shousei01/dcdc_converter/README.txt

DCDC converter - LLC (isolated) + 4-switch buck-boost, STM32G474RBT3          Rev E2 (2026-10-20)
12-48 V in, 1.5-48 V / 5 A / 50 W out, basic isolation, isolated CAN

01_hardware
  kicad_project\   KiCad 6/7 project (10-sheet wired schematic + routed 4-layer PCB). Open in KiCad, or import
                   into EasyEDA Pro (File > Import > KiCad) - same files as easyeda\*.zip
  easyeda\         DCDC_LLC_4SBB_G474_EasyEDA_import.zip
  docs\            DCDC_Design_Notes.docx / .pdf (design notes: sizing, full scales, firmware notes, review),
                   schematic PDF, PCB layer PDF, DRC report, pin-map.xlsx (every MCU pin + all AFs + what we use),
                   T1_PQ2620_winding_guide.html (hand-winding guide, 2D/3D, dots), layout_review_layers.png
  fabrication\     JLCPCB Gerber/drill zip, CPL (pick & place), JLCPCB BOM;
                   DCDC_JLC_BOM.csv / DCDC_JLC_CPL.csv = assembly upload files (U1, T1, connectors, headers,
                   SW1 and the J6 SWD pads are hand-soldered / not placed and left out)
  bom\             grouped BOM with prices / sources
02_firmware        firmware workspace + README (pin map, clocks, ADC full scales, VIN monitor, OVP, start-up)
03_calculations    loss / LLC sizing scripts; aux_fuse_check.py (Rev D); flyback_aux.py (Rev E isolated aux
                   flyback: rail budget, DCM operating points, stresses, ripple, feedback); copper_check.py
                   (Rev E copper widths / losses of the high-current paths on the finished board)
04_scripts         generator, routing and clean-up scripts that build this release (Rev E layout: 04_scripts\pcb5)

Rev E2 changes (20 Oct)
  - Debug-port series resistors: R123-R128 47.5 Ohm 0402 (UNI-ROYAL 0402WGF475JTCE, C82290) in SWDIO, SWCLK,
    TP_DAC, TP_GPIO1, TP_GPIO2, NRST; R129 2 Ohm 0603 (FOJAN FRC0603F2R00TS, C2933191) from +3V3 to J6 pin 7 /
    J7 VTref (net PROG_3V3). Each sits on the MCU side of the J6 / J7 branch, put into the existing traces.
  - DRC clean-up: the 16 courtyard overlaps Rev E accepted (T1 / CR1-CR6 / R64, T2 / D8 / C94 / R116 / C95 /
    Q11 / R114, C98 / R122, C69 / U11, C34 / U1) are cleared by 0.05-2 mm moves with the tracks re-attached;
    the 4 silk-over-pad notices are gone too. DRC: 0 errors, 0 warnings, 0 unconnected (docs\DRC_report.txt).
  - Board-edit scripts: 04_scripts\pcb6 (build_e2.sh lists the order).

Rev E changes
  - Isolated aux supply: the isolator's built-in 3.3 V is gone. New flyback (sheet "Isolated aux flyback"):
    UC3843B U20 from +10V_P, FDN86246 Q11, PA3855.006NLT EP13 transformer T2 (Np:Ns 1.33:1, 2250 Vdc hi-pot),
    SS110 D9 -> isolated +10 V. Secondary regulation: TL431 U22 (+10 V = 9.98 V) driving an EL357N opto U21
    into the UC3843 COMP pin; RCD clamp D8/R116/C94; 2 A primary current limit (R114 0.5 Ohm).
  - Secondary rails now come from the flyback, not VBUS: +10 V (drivers) -> U4 LMR16006 10 V -> 5 V ->
    U5 TLV75533 -> +3V3 (MCU, CAN, isolator side B) -> FB1 -> +3V3A. The MCU, CAN and drivers are up as soon
    as VIN is present, before the LLC starts.
  - U12 is now a CA-IS3742LW (4-channel isolator, no power). U12 ENA = +5V_P, ENB = +3V3.
  - VREF+ back to +3V3A (3.3 V); REF3030 U19 removed. Full scales: VBUS / VOUT 68.0 V, IL +/-20.6 A
    (zero 1.65 V), IOUT 6.6 A, DAC3 / COMP 0-3.3 V (see design notes and 02_firmware README).
  - PCB re-placed and re-routed for 1 oz outer / 0.5 oz inner copper: power on F.Cu pours (one net each),
    In1 solid ground planes (GNDP / GND / GND_ISO) with 4 mm isolation bands, VBUS link / VOUT strip / PGND bar
    copy on B.Cu, signals on In2 / B.Cu under ground floods. Gate loops as tight HO + HS pairs (0.4 mm) on
    B.Cu / In2; power via fields at 1.7 mm pitch so In1 keeps a ground web; own GND via on every small R/C in the
    MCU area. Board copper loss ~0.5 W at 50 W / 12 V in (03_calculations\copper_check.txt).
PCB status: 160 x 105 mm, 4 layers, 291 footprints, 779 vias; 0 DRC errors / 0 warnings / 0 unconnected with the
JLC rules loaded (docs\DRC_report.txt); no copper in the primary-secondary or CAN bands.
Order: 4 layers, 1.6 mm, 1 oz outer / 0.5 oz inner copper, JLC04161H-7628 stack-up;
upload fabrication\*_gerbers_JLCPCB.zip, DCDC_JLC_BOM.csv and DCDC_JLC_CPL.csv.
New parts to check in the JLC placement viewer: U20 (SOIC-8), U21 (SOP-4), U22 (SOT-23), Q11 (SOT-23),
T2 (EP13 SMD), U12 (SOIC-16W), U5 (SOT-23-5).

Rev D changes (history)
  - NTC moved PA4 -> PA6 (ADC2_IN3); PA4 kept free for DAC1_OUT1
  - 10k pull-down to GND on every unused MCU pin (R90-R105; R93 is now the PA2 / VIN_PWM pull-down)
  - HSE crystal 16 MHz (Y1 + 12 pF C0G)
  - (superseded in Rev E) ADC / DAC / comparator reference: external REF3030 (U19, 3.000 V +/-0.2 %) on VREF+, no longer the
    isolator's 3.3 V rail. Full scales: VBUS / VOUT 61.8 V, IL +/-18.75 A, IOUT 6.0 A (see design notes)
  - Primary input OVP: TL431 + LMV331, trips 50.26 V rising / 49.83 V falling, through U12 isolator
    channel 1 -> PA15 (HRTIM1_FLT2)
  - Isolated VIN monitor: primary ramp (~200 Hz) + comparator PWM through U12 channel 2 -> PA2 (TIM15_CH1);
    divider R81/R82 0.1 %. Monitoring only, about +/-0.5 % after a two-point calibration
  - Test pads TP1-TP15 on rails / filtered signals only (no switch nodes)
  - T1 footprint fits the vendor PQ2620 and PQ2625 6+6 bobbins: 3.8 mm pitch inside each 3-pin group,
    7.5 mm between pins 3 and 4, 25.4 mm row-to-row, 1.2 mm holes
  - JP1 is a 2x2 header that switches both legs of the CAN split termination
  - Silkscreen: VIN+/-, VOUT+/-, CAN_H / CAN_L / CAN_GND, JP1 shunt boxes, J7 notch + pin 1, DIP A0-A5 / ON=1
  - F1 now a 1206 7 A 63 V chip fuse (Littelfuse 0458007.DR; 2nd source Schurter 3413.0326.11);
    L2 / L3 now 5040 shielded 47 uH (Sunlord SWPA5040S470MT; 2nd source Bourns SRN5040-470M,
    Taiyo Yuden NRS5040T470MMGK). EN_AUX re-routed, VIN track centred between the L3 pads.
    Every part carries a JLCPCB-checked LCSC number (design.py JLC_LCSC) in the BOMs, schematic and PCB
  - Layout review (18 Oct): smaller switch-node pours, tighter gate loops, Kelvin taps, output pour,
    straightened routing, 5 mm ground stitching
  - JLCPCB compliance (4-layer, 2 oz outer): PTH pad-to-track >= 0.28 mm, inner hole-to-copper >= 0.3 mm,
    silkscreen text >= 1.0 mm / 0.15 mm stroke; limits kept as custom DRC rules in kicad_project\*.kicad_dru
Rev D PCB status: 160 x 105 mm, 4 layers, 257 footprints, 0 DRC errors / warnings with the JLC rules loaded,
0 unconnected, primary-secondary copper gap 4.0 mm on every layer.
Rev D order: 4 layers, 1.6 mm, 2 oz outer copper, JLC04161H-7628 stack-up; upload fabrication\*_gerbers_JLCPCB.zip.
