shousei01/dcdc_converter/01_hardware/docs/pin-map.xlsx

Sheet: Pin map
Pin # | Pin name | Pin type | Net (schematic) | Status | Function used | Mode / AF | Direction | Connected to | Design notes | Additional functions (analog, wake-up, ...) | AF0 | AF1 | AF2 | AF3 | AF4 | AF5 | AF6 | AF7 | AF8 | AF9 | AF10 | AF11 | AF12 | AF13 | AF14 | AF15
1 | VBAT | Power | +3V3 | Power | VBAT (backup domain) | Power | Supply |  | Tied to +3V3 (no backup battery; RTC/backup registers lost at power-off)
2 | PC13 | I/O | SP_PC13 | Unused | Not used | Analog (reset state) or input | - | R90.1 | 10k pull-down to GND (R90); low-drive backup-domain pin | RTC_OUT1, RTC_TAMP1, RTC_TS, SYS_WKUP2 |  |  | TIM1_BKIN |  | TIM1_CH1N |  | TIM8_CH4N |  |  |  |  |  |  |  |  | EVENTOUT
3 | PC14-OSC32_IN | I/O | SP_PC14 | Unused | Not used | Analog (reset state) or input | - | R91.1 | 10k pull-down to GND (R91); low-drive backup-domain pin | RCC_OSC32_IN |  |  |  |  |  |  |  |  |  |  |  |  |  |  |  | EVENTOUT
4 | PC15-OSC32_OUT | I/O | SP_PC15 | Unused | Not used | Analog (reset state) or input | - | R92.1 | 10k pull-down to GND (R92); low-drive backup-domain pin | ADC1_EXTI15, ADC2_EXTI15, RCC_OSC32_OUT |  |  |  |  |  |  |  |  |  |  |  |  |  |  |  | EVENTOUT
5 | PF0-OSC_IN | I/O | OSC_IN | Used | RCC_OSC_IN (HSE) | RCC HSE crystal | In | C38.1, Y1.1 | Y1 16 MHz 9 pF + 12 pF C0G load caps -> PLL 170 MHz | ADC1_IN10, RCC_OSC_IN |  |  |  |  | I2C2_SDA | I2S2_WS / SPI2_NSS | TIM1_CH3N |  |  |  |  |  |  |  |  | EVENTOUT
6 | PF1-OSC_OUT | I/O | OSC_OUT | Used | RCC_OSC_OUT (HSE) | RCC HSE crystal | Out | C39.1, Y1.3 | Y1 16 MHz | ADC2_IN10, COMP3_INM, RCC_OSC_OUT |  |  |  |  |  | I2S2_CK / SPI2_SCK |  |  |  |  |  |  |  |  |  | EVENTOUT
7 | PG10-NRST | I/O | NRST | Used | NRST | Reset | In/Out | C40.1, J6.6, J7.10 | 100 nF to GND (C40); SWD reset on J6.6 / J7.10 | DAC1_EXTI10, DAC2_EXTI10, DAC3_EXTI10, DAC4_EXTI10 | RCC_MCO |  |  |  |  |  |  |  |  |  |  |  |  |  |  | EVENTOUT
8 | PC0 | I/O | ADDR0 | Used | GPIO input | Input, no pull (10k external pull-up) | In | R32.1, R38.2, SW1.1 | Address bit 0: DIP SW1 / header J5 (ON or jumper = 0) | ADC1_IN6, ADC2_IN6, COMP3_INM |  | LPTIM1_IN1 | TIM1_CH1 |  |  |  |  |  | LPUART1_RX |  |  |  |  |  |  | EVENTOUT
9 | PC1 | I/O | ADDR1 | Used | GPIO input | Input, no pull (10k external pull-up) | In | R33.1, R39.2, SW1.2 | Address bit 1: DIP SW1 / header J5 (ON or jumper = 0) | ADC1_IN7, ADC2_IN7, COMP3_INP |  | LPTIM1_OUT | TIM1_CH2 |  |  |  |  |  | LPUART1_TX |  | QUADSPI1_BK2_IO0 |  |  | SAI1_SD_A |  | EVENTOUT
10 | PC2 | I/O | ADDR2 | Used | GPIO input | Input, no pull (10k external pull-up) | In | R34.1, R40.2, SW1.3 | Address bit 2: DIP SW1 / header J5 (ON or jumper = 0) | ADC1_IN8, ADC2_IN8, ADC3_EXTI2, ADC4_EXTI2, ADC5_EXTI2 |  | LPTIM1_IN2 | TIM1_CH3 | COMP3_OUT |  |  | TIM20_CH2 |  |  |  | QUADSPI1_BK2_IO1 |  |  |  |  | EVENTOUT
11 | PC3 | I/O | ADDR3 | Used | GPIO input | Input, no pull (10k external pull-up) | In | R35.1, R41.2, SW1.4 | Address bit 3: DIP SW1 / header J5 (ON or jumper = 0) | ADC1_IN9, ADC2_IN9, ADC3_EXTI3, ADC4_EXTI3, ADC5_EXTI3, OPAMP5_VINP, OPAMP5_VINP_SEC | SYS_SLEEP | LPTIM1_ETR | TIM1_CH4 | SAI1_D1 |  |  | TIM1_BKIN2 |  |  |  | QUADSPI1_BK2_IO2 |  |  | SAI1_SD_A |  | EVENTOUT
12 | PA0 | I/O | VBUS_SNS | Used | ADC1_IN1 | Analog | In | C41.1, R21.2, R22.1 | VBUS divider 100k/5.1k, 1 nF -> 68 V full scale | ADC1_IN1, ADC2_IN1, COMP1_INM, COMP3_INP, RTC_TAMP2, SYS_WKUP1 |  | TIM2_CH1 | TIM5_CH1 |  |  |  |  | USART2_CTS / USART2_NSS | COMP1_OUT | TIM8_BKIN | TIM8_ETR |  |  |  | TIM2_ETR | EVENTOUT
13 | PA1 | I/O | IOUT_SNS | Used | ADC1_IN2 | Analog | In | C47.1, R28.2, TP14.1 | INA181A2 on 10 mOhm (RSH1): 0.5 V/A, 1k + 10 nF filter | ADC1_IN2, ADC2_IN2, COMP1_INP, OPAMP1_VINP, OPAMP1_VINP_SEC, OPAMP3_VINP, OPAMP3_VINP_SEC, OPAMP6_VINM, OPAMP6_VINM0, OPAMP6_VINM_SEC | RTC_REFIN | TIM2_CH2 | TIM5_CH2 |  |  |  |  | USART2_DE / USART2_RTS |  | TIM15_CH1N |  |  |  |  |  | EVENTOUT
14 | PA2 | I/O | SP_PA2 | Unused | Not used | Analog (reset state) or input | - | R93.1 | 10k pull-down to GND (R93) | ADC1_IN3, ADC3_EXTI2, ADC4_EXTI2, ADC5_EXTI2, COMP2_INM, OPAMP1_VOUT, RCC_LSCO, SYS_WKUP4 |  | TIM2_CH3 | TIM5_CH3 |  |  |  |  | USART2_TX | COMP2_OUT | TIM15_CH1 | QUADSPI1_BK1_NCS |  | LPUART1_TX |  | UCPD1_FRSTX1 / UCPD1_FRSTX2 | EVENTOUT
15 | VSS | Power | GND | Power | Ground | Power | Supply |  | Secondary GND plane (In1)
16 | VDD | Power | +3V3 | Power | VDD supply | Power | Supply |  | 100 nF per VDD pin (C30-C34) + 4.7 uF bulk (C35)
17 | PA3 | I/O | SP_PA3 | Unused | Not used | Analog (reset state) or input | - | R94.1 | 10k pull-down to GND (R94) | ADC1_IN4, ADC3_EXTI3, ADC4_EXTI3, ADC5_EXTI3, COMP2_INP, OPAMP1_VINM, OPAMP1_VINM0, OPAMP1_VINM_SEC, OPAMP1_VINP, OPAMP1_VINP_SEC, OPAMP5_VINM, OPAMP5_VINM1, OPAMP5_VINM_SEC |  | TIM2_CH4 | TIM5_CH4 | SAI1_CK1 |  |  |  | USART2_RX |  | TIM15_CH2 | QUADSPI1_CLK |  | LPUART1_RX | SAI1_MCLK_A |  | EVENTOUT
18 | PA4 | I/O | SP_PA4 | Reserved | Reserved: DAC1_OUT1 | Analog (reset state) or input | - | R95.1 | Kept free for DAC1_OUT1 (Rev D request); 10k pull-down R95 is a valid DAC load (min 5k) | ADC2_IN17, COMP1_INM, DAC1_OUT1 |  |  | TIM3_CH2 |  |  | SPI1_NSS | I2S3_WS / SPI3_NSS | USART2_CK |  |  |  |  |  | SAI1_FS_B |  | EVENTOUT
19 | PA5 | I/O | TP_DAC | Used | DAC1_OUT2 | Analog | Out | J6.3 | Test_pin_DAC on PROG PADS J6.3 (debug waveform out) | ADC2_IN13, COMP2_INM, DAC1_OUT2, OPAMP2_VINM, OPAMP2_VINM0, OPAMP2_VINM_SEC |  | TIM2_CH1 | TIM2_ETR |  |  | SPI1_SCK |  |  |  |  |  |  |  |  | UCPD1_FRSTX1 / UCPD1_FRSTX2 | EVENTOUT
20 | PA6 | I/O | NTC_SNS | Used | ADC2_IN3 | Analog | In | C48.1, R29.2, TH1.1 | NTC 10k B3950 / 10k divider (Rev D: moved from PA4 to PA6) | ADC2_IN3, DAC2_OUT1, OPAMP2_VOUT |  | TIM16_CH1 | TIM3_CH1 |  | TIM8_BKIN | SPI1_MISO | TIM1_BKIN |  | COMP1_OUT |  | QUADSPI1_BK1_IO3 |  | LPUART1_CTS |  |  | EVENTOUT
21 | PA7 | I/O | SP_PA7 | Unused | Not used | Analog (reset state) or input | - | R96.1 | 10k pull-down to GND (R96) | ADC2_IN4, COMP2_INP, OPAMP1_VINP, OPAMP1_VINP_SEC, OPAMP2_VINP, OPAMP2_VINP_SEC |  | TIM17_CH1 | TIM3_CH2 |  | TIM8_CH1N | SPI1_MOSI | TIM1_CH1N |  | COMP2_OUT |  | QUADSPI1_BK1_IO2 |  |  |  | UCPD1_FRSTX1 / UCPD1_FRSTX2 | EVENTOUT
22 | PC4 | I/O | ADDR4 | Used | GPIO input | Input, no pull (10k external pull-up) | In | R36.1, R42.2, SW1.5 | Address bit 4: DIP SW1 / header J5 (ON or jumper = 0) | ADC2_IN5 |  |  | TIM1_ETR |  | I2C2_SCL |  |  | USART1_TX |  |  | QUADSPI1_BK2_IO3 |  |  |  |  | EVENTOUT
23 | PC5 | I/O | ADDR5 | Used | GPIO input | Input, no pull (10k external pull-up) | In | R37.1, R43.2, SW1.6 | Address bit 5: DIP SW1 / header J5 (ON or jumper = 0) | ADC2_IN11, OPAMP1_VINM, OPAMP1_VINM1, OPAMP1_VINM_SEC, OPAMP2_VINM, OPAMP2_VINM1, OPAMP2_VINM_SEC, SYS_WKUP5 |  |  | TIM15_BKIN | SAI1_D3 |  |  | TIM1_CH4N | USART1_RX |  |  |  |  |  | HRTIM1_EEV10 |  | EVENTOUT
24 | PB0 | I/O | IL_SNS | Used | COMP4_INP | Analog | In | C45.1, R27.2, TP13.1 | Inductor current (INA181A1 on 4 mOhm, 1.65 V + 0.08 V/A): buck-mode negative OCP, COMP4 output inverted -> HRTIM fault | ADC1_IN15, ADC3_IN12, COMP4_INP, OPAMP2_VINP, OPAMP2_VINP_SEC, OPAMP3_VINP, OPAMP3_VINP_SEC |  |  | TIM3_CH3 |  | TIM8_CH2N |  | TIM1_CH2N |  |  |  | QUADSPI1_BK1_IO1 |  |  | HRTIM1_FLT5 | UCPD1_FRSTX1 / UCPD1_FRSTX2 | EVENTOUT
25 | PB1 | I/O | IL_SNS | Used | ADC1_IN12 + COMP1_INP | Analog | In | C45.1, R27.2, TP13.1 | Inductor current sample for CC loop; COMP1 = positive OCP -> HRTIM fault (thresholds from DAC3) | ADC1_IN12, ADC3_IN1, COMP1_INP, OPAMP3_VOUT, OPAMP6_VINM, OPAMP6_VINM1, OPAMP6_VINM_SEC |  |  | TIM3_CH4 |  | TIM8_CH3N |  | TIM1_CH3N |  | COMP4_OUT |  | QUADSPI1_BK1_IO0 |  | LPUART1_DE / LPUART1_RTS | HRTIM1_SCOUT |  | EVENTOUT
26 | PB2 | I/O | SP_PB2 | Unused | Not used | Analog (reset state) or input | - | R97.1 | 10k pull-down to GND (R97) | ADC2_IN12, ADC3_EXTI2, ADC4_EXTI2, ADC5_EXTI2, COMP4_INM, OPAMP3_VINM, OPAMP3_VINM0, OPAMP3_VINM_SEC | RTC_OUT2 | LPTIM1_OUT | TIM5_CH1 | TIM20_CH1 | I2C3_SMBA |  |  |  |  |  | QUADSPI1_BK2_IO1 |  |  | HRTIM1_SCIN |  | EVENTOUT
27 | VSSA | Power | GND | Power | Ground | Power | Supply |  | Secondary GND plane (In1)
28 | VREF+ | MonoIO | +3V3A | Power | VREF+ input | Power | Supply |  | Tied to +3V3A (VREFBUF disabled); ADC/DAC full scale = 3.3 V | VREFBUF_OUT
29 | VDDA | Power | +3V3A | Power | Analog supply / reference | Power | Supply |  | VDDA and VREF+ from +3V3 via FB1; VREFBUF off, VREF+ used as input (1 uF + 100 nF)
30 | PB10 | I/O | SP_PB10 | Unused | Not used | Analog (reset state) or input | - | R98.1 | 10k pull-down to GND (R98) | COMP5_INM, DAC1_EXTI10, DAC2_EXTI10, DAC3_EXTI10, DAC4_EXTI10, OPAMP3_VINM, OPAMP3_VINM1, OPAMP3_VINM_SEC, OPAMP4_VINM, OPAMP4_VINM0, OPAMP4_VINM_SEC |  | TIM2_CH3 |  |  |  |  |  | USART3_TX | LPUART1_RX |  | QUADSPI1_CLK |  | TIM1_BKIN | HRTIM1_FLT3 | SAI1_SCK_A | EVENTOUT
31 | VSS | Power | GND | Power | Ground | Power | Supply |  | Secondary GND plane (In1)
32 | VDD | Power | +3V3 | Power | VDD supply | Power | Supply |  | 100 nF per VDD pin (C30-C34) + 4.7 uF bulk (C35)
33 | PB11 | I/O | VOUT_SNS | Used | ADC1_IN14 + COMP6_INP | Analog | In | C42.1, R23.2, R24.1 | VOUT divider 100k/5.1k; COMP6 = fast hardware OVP (threshold from DAC3) | ADC1_EXTI11, ADC1_IN14, ADC2_EXTI11, ADC2_IN14, COMP6_INP, OPAMP4_VINP, OPAMP4_VINP_SEC, OPAMP6_VOUT |  | TIM2_CH4 |  |  |  |  |  | USART3_RX | LPUART1_TX |  | QUADSPI1_BK1_NCS |  |  | HRTIM1_FLT4 |  | EVENTOUT
34 | PB12 | I/O | LLC_A | Used | HRTIM1_CHC1 | AF13 | Out | R79.1, U12.12 | LLC half-bridge high side via CA-IS3742 (U12) -> UCC27211 (U10) | ADC1_IN11, ADC4_IN3, COMP7_INM, OPAMP4_VOUT, OPAMP6_VINP, OPAMP6_VINP_SEC |  |  | TIM5_ETR |  | I2C2_SMBA | I2S2_WS / SPI2_NSS | TIM1_BKIN | USART3_CK | LPUART1_DE / LPUART1_RTS | FDCAN2_RX |  |  |  | HRTIM1_CHC1 |  | EVENTOUT
35 | PB13 | I/O | LLC_B | Used | HRTIM1_CHC2 | AF13 | Out | R80.1, U12.11 | LLC half-bridge low side via U12 -> U10 | ADC3_IN5, COMP5_INP, OPAMP3_VINP, OPAMP3_VINP_SEC, OPAMP4_VINP, OPAMP4_VINP_SEC, OPAMP6_VINP, OPAMP6_VINP_SEC |  |  |  |  |  | I2S2_CK / SPI2_SCK | TIM1_CH1N | USART3_CTS / USART3_NSS | LPUART1_CTS | FDCAN2_TX |  |  |  | HRTIM1_CHC2 |  | EVENTOUT
36 | PB14 | I/O | SR1_PWM | Used | HRTIM1_CHD1 | AF13 | Out | R73.1, U11.2 | Synchronous rectifier Q7 via UCC27524 (U11) | ADC1_IN5, ADC4_IN4, COMP7_INP, OPAMP2_VINP, OPAMP2_VINP_SEC, OPAMP5_VINP, OPAMP5_VINP_SEC |  | TIM15_CH1 |  |  |  | SPI2_MISO | TIM1_CH2N | USART3_DE / USART3_RTS | COMP4_OUT |  |  |  |  | HRTIM1_CHD1 |  | EVENTOUT
37 | PB15 | I/O | SR2_PWM | Used | HRTIM1_CHD2 | AF13 | Out | R74.1, U11.4 | Synchronous rectifier Q8 via U11 | ADC1_EXTI15, ADC2_EXTI15, ADC2_IN15, ADC4_IN5, COMP6_INM, OPAMP5_VINM, OPAMP5_VINM0, OPAMP5_VINM_SEC | RTC_REFIN | TIM15_CH2 | TIM15_CH1N | COMP3_OUT | TIM1_CH3N | I2S2_SD / SPI2_MOSI |  |  |  |  |  |  |  | HRTIM1_CHD2 |  | EVENTOUT
38 | PC6 | I/O | SP_PC6 | Unused | Not used | Analog (reset state) or input | - | R99.1 | 10k pull-down to GND (R99) |  |  |  | TIM3_CH1 | HRTIM1_EEV10 | TIM8_CH1 |  | I2S2_MCK | COMP6_OUT | I2C4_SCL |  |  |  |  | HRTIM1_CHF1 |  | EVENTOUT
39 | PC7 | I/O | SP_PC7 | Unused | Not used | Analog (reset state) or input | - | R100.1 | 10k pull-down to GND (R100) |  |  |  | TIM3_CH2 | HRTIM1_FLT5 | TIM8_CH2 |  | I2S3_MCK | COMP5_OUT | I2C4_SDA |  |  |  |  | HRTIM1_CHF2 |  | EVENTOUT
40 | PC8 | I/O | PWM_E1 | Used | HRTIM1_CHE1 | AF3 | Out | R14.1, U3.5 | 4SBB output leg high side Q3 via UCC27211 (U3) |  |  |  | TIM3_CH3 | HRTIM1_CHE1 | TIM8_CH3 |  | TIM20_CH3 | COMP7_OUT | I2C3_SCL |  |  |  |  |  |  | EVENTOUT
41 | PC9 | I/O | PWM_E2 | Used | HRTIM1_CHE2 | AF3 | Out | R15.1, U3.6 | 4SBB output leg low side Q4 via U3 | DAC1_EXTI9, DAC2_EXTI9, DAC3_EXTI9, DAC4_EXTI9 |  |  | TIM3_CH4 | HRTIM1_CHE2 | TIM8_CH4 | I2S_CKIN | TIM8_BKIN2 |  | I2C3_SDA |  |  |  |  |  |  | EVENTOUT
42 | PA8 | I/O | PWM_A1 | Used | HRTIM1_CHA1 | AF13 | Out | R8.1, U2.5 | 4SBB input leg high side Q1 via UCC27211 (U2) | ADC5_IN1, OPAMP5_VOUT | RCC_MCO |  | I2C3_SCL |  | I2C2_SDA | I2S2_MCK | TIM1_CH1 | USART1_CK | COMP7_OUT |  | TIM4_ETR | FDCAN3_RX | SAI1_CK2 | HRTIM1_CHA1 | SAI1_SCK_A | EVENTOUT
43 | PA9 | I/O | PWM_A2 | Used | HRTIM1_CHA2 | AF13 | Out | R9.1, U2.6 | 4SBB input leg low side Q2 via U2 | ADC5_IN2, DAC1_EXTI9, DAC2_EXTI9, DAC3_EXTI9, DAC4_EXTI9, UCPD1_DBCC1 |  |  | I2C3_SMBA |  | I2C2_SCL | I2S3_MCK | TIM1_CH2 | USART1_TX | COMP5_OUT | TIM15_BKIN | TIM2_CH3 |  |  | HRTIM1_CHA2 | SAI1_FS_A | EVENTOUT
44 | PA10 | I/O | SP_PA10 | Unused | Not used | Analog (reset state) or input | - | R101.1 | 10k pull-down to GND (R101) | DAC1_EXTI10, DAC2_EXTI10, DAC3_EXTI10, DAC4_EXTI10, UCPD1_DBCC2 |  | TIM17_BKIN |  | CRS_SYNC | I2C2_SMBA | SPI2_MISO | TIM1_CH3 | USART1_RX | COMP6_OUT |  | TIM2_CH4 | TIM8_BKIN | SAI1_D1 | HRTIM1_CHB1 | SAI1_SD_A | EVENTOUT
45 | PA11 | I/O | CAN_RXD | Used | FDCAN1_RX | AF9 | In | U9.5 | CA-IS3062VW (U9) RXD | ADC1_EXTI11, ADC2_EXTI11, USB_DM |  |  |  |  |  | I2S2_SD / SPI2_MOSI | TIM1_CH1N | USART1_CTS / USART1_NSS | COMP1_OUT | FDCAN1_RX | TIM4_CH1 | TIM1_CH4 | TIM1_BKIN2 | HRTIM1_CHB2 |  | EVENTOUT
46 | PA12 | I/O | CAN_TXD | Used | FDCAN1_TX | AF9 | Out | U9.3 | CA-IS3062VW (U9) TXD | USB_DP |  | TIM16_CH1 |  |  |  | I2S_CKIN | TIM1_CH2N | USART1_DE / USART1_RTS | COMP2_OUT | FDCAN1_TX | TIM4_CH2 | TIM1_ETR |  | HRTIM1_FLT1 |  | EVENTOUT
47 | VSS | Power | GND | Power | Ground | Power | Supply |  | Secondary GND plane (In1)
48 | VDD | Power | +3V3 | Power | VDD supply | Power | Supply |  | 100 nF per VDD pin (C30-C34) + 4.7 uF bulk (C35)
49 | PA13 | I/O | SWDIO | Used | SYS_JTMS-SWDIO | AF0 (reset default) | In/Out | J6.1, J7.2 | J6.1 / J7.2 |  | SYS_JTMS-SWDIO | TIM16_CH1N |  | I2C4_SCL | I2C1_SCL | IR_OUT |  | USART3_CTS / USART3_NSS |  |  | TIM4_CH3 |  |  | SAI1_SD_B |  | EVENTOUT
50 | PA14 | I/O | SWCLK | Used | SYS_JTCK-SWCLK | AF0 (reset default) | In | J6.2, J7.4 | J6.2 / J7.4 |  | SYS_JTCK-SWCLK | LPTIM1_OUT |  | I2C4_SMBA | I2C1_SDA | TIM8_CH2 | TIM1_BKIN | USART2_TX |  |  |  |  |  | SAI1_FS_B |  | EVENTOUT
51 | PA15 | I/O | VIN_OVP | Used | HRTIM1_FLT2 (alt.: GPIO EXTI15) | AF13 | In | TP15.1, U12.14 | Rev D: primary input OVP, LMV331 + TL431 trip 50.2 V, through U12 VI1->VO1; high = over-voltage. Configure FLT2 active-high so the HRTIM shuts all outputs in hardware | ADC1_EXTI15, ADC2_EXTI15 | SYS_JTDI | TIM2_CH1 | TIM8_CH1 |  | I2C1_SCL | SPI1_NSS | I2S3_WS / SPI3_NSS | USART2_RX | UART4_DE / UART4_RTS | TIM1_BKIN |  | FDCAN3_TX |  | HRTIM1_FLT2 | TIM2_ETR | EVENTOUT
52 | PC10 | I/O | LED_FLT | Used | GPIO output | Output push-pull | Out | R45.2 | Red FAULT LED D5 via 1k, active low | DAC1_EXTI10, DAC2_EXTI10, DAC3_EXTI10, DAC4_EXTI10 |  |  |  |  | TIM8_CH1N | UART4_TX | I2S3_CK / SPI3_SCK | USART3_TX |  |  |  |  |  | HRTIM1_FLT6 |  | EVENTOUT
53 | PC11 | I/O | SR_EN | Used | GPIO output | Output push-pull | Out | R72.1, U11.1, U11.8 | UCC27524 ENA/ENB, high = SR drive enabled; 10k pull-downs keep it off at reset | ADC1_EXTI11, ADC2_EXTI11 |  |  |  | HRTIM1_EEV2 | TIM8_CH2N | UART4_RX | SPI3_MISO | USART3_RX | I2C3_SDA |  |  |  |  |  |  | EVENTOUT
54 | PC12 | I/O | SP_PC12 | Unused | Not used | Analog (reset state) or input | - | R102.1 | 10k pull-down to GND (R102) |  |  | TIM5_CH2 |  | HRTIM1_EEV1 | TIM8_CH3N | UART5_TX | I2S3_SD / SPI3_MOSI | USART3_CK |  |  |  |  |  |  | UCPD1_FRSTX1 / UCPD1_FRSTX2 | EVENTOUT
55 | PD2 | I/O | SP_PD2 | Unused | Not used | Analog (reset state) or input | - | R103.1 | 10k pull-down to GND (R103) | ADC3_EXTI2, ADC4_EXTI2, ADC5_EXTI2 |  |  | TIM3_ETR |  | TIM8_BKIN | UART5_RX |  |  |  |  |  |  |  |  |  | EVENTOUT
56 | PB3 | I/O | SWO | Used | SYS_JTDO-SWO | AF0 (reset default) | Out | J7.6 | J7.6 trace output | ADC3_EXTI3, ADC4_EXTI3, ADC5_EXTI3 | SYS_JTDO-SWO | TIM2_CH2 | TIM4_ETR | CRS_SYNC | TIM8_CH1N | SPI1_SCK | I2S3_CK / SPI3_SCK | USART2_TX |  |  | TIM3_ETR | FDCAN3_RX | HRTIM1_SCOUT | HRTIM1_EEV9 | SAI1_SCK_B | EVENTOUT
57 | PB4 | I/O | SP_PB4 | Unused | Not used | Analog (reset state) or input | - | R104.1 | 10k pull-down to GND (R104); PB4 = NJTRST with internal pull-up at reset - harmless, JTAG unused (SWD only) | UCPD1_CC2 | SYS_JTRST | TIM16_CH1 | TIM3_CH1 |  | TIM8_CH2N | SPI1_MISO | SPI3_MISO | USART2_RX | UART5_DE / UART5_RTS |  | TIM17_BKIN | FDCAN3_TX |  | HRTIM1_EEV7 | SAI1_MCLK_B | EVENTOUT
58 | PB5 | I/O | SP_PB5 | Unused | Not used | Analog (reset state) or input | - | R105.1 | 10k pull-down to GND (R105) |  |  | TIM16_BKIN | TIM3_CH2 | TIM8_CH3N | I2C1_SMBA | SPI1_MOSI | I2S3_SD / SPI3_MOSI | USART2_CK | I2C3_SDA | FDCAN2_RX | TIM17_CH1 | LPTIM1_IN1 | SAI1_SD_B | HRTIM1_EEV6 | UART5_CTS | EVENTOUT
59 | PB6 | I/O | TP_GPIO1 | Used | GPIO | Output (debug) | In/Out | J6.4 | Test_pin_GPIO1 on J6.4 (timing / debug) | UCPD1_CC1 |  | TIM16_CH1N | TIM4_CH1 |  |  | TIM8_CH1 | TIM8_ETR | USART1_TX | COMP4_OUT | FDCAN2_TX | TIM8_BKIN2 | LPTIM1_ETR | HRTIM1_SCIN | HRTIM1_EEV4 | SAI1_FS_B | EVENTOUT
60 | PB7 | I/O | TP_GPIO2 | Used | GPIO | Output (debug) | In/Out | J6.5 | Test_pin_GPIO2 on J6.5 (timing / debug) | SYS_PVD_IN |  | TIM17_CH1N | TIM4_CH2 | I2C4_SDA | I2C1_SDA | TIM8_BKIN |  | USART1_RX | COMP3_OUT |  | TIM3_CH4 | LPTIM1_IN2 | FMC_NL | HRTIM1_EEV3 | UART4_CTS | EVENTOUT
61 | PB8-BOOT0 | I/O | BOOT0 | Used | BOOT0 | Boot pin | In | R20.1 | 10k to GND (R20) -> boot from flash; nSWBOOT0 option bit may override |  |  | TIM16_CH1 | TIM4_CH3 | SAI1_CK1 | I2C1_SCL |  |  | USART3_RX | COMP1_OUT | FDCAN1_RX | TIM8_CH2 |  | TIM1_BKIN | HRTIM1_EEV8 | SAI1_MCLK_A | EVENTOUT
62 | PB9 | I/O | LED_RUN | Used | GPIO output | Output push-pull | Out | R44.2 | Green RUN LED D4 via 1k, active low | DAC1_EXTI9, DAC2_EXTI9, DAC3_EXTI9, DAC4_EXTI9 |  | TIM17_CH1 | TIM4_CH4 | SAI1_D2 | I2C1_SDA |  | IR_OUT | USART3_TX | COMP2_OUT | FDCAN1_TX | TIM8_CH3 |  | TIM1_CH3N | HRTIM1_EEV5 | SAI1_FS_A | EVENTOUT
63 | VSS | Power | GND | Power | Ground | Power | Supply |  | Secondary GND plane (In1)
64 | VDD | Power | +3V3 | Power | VDD supply | Power | Supply |  | 100 nF per VDD pin (C30-C34) + 4.7 uF bulk (C35)

Sheet: Summary
STM32G474RBT6 (LQFP64) pin usage - DCDC LLC + 4SBB, Rev D
Status | Pins
Used
Reserved
Unused (10k pull-down)
Power / ground
Total
Check (must be 64)
Peripheral resources in use
Peripheral | Signals (pin)
HRTIM1 Timer A | CHA1 PA8, CHA2 PA9 (AF13) - 4SBB input leg, 150 kHz
HRTIM1 Timer E | CHE1 PC8, CHE2 PC9 (AF3) - 4SBB output leg, 150 kHz
HRTIM1 Timer C | CHC1 PB12, CHC2 PB13 (AF13) - LLC half-bridge, ~205 kHz
HRTIM1 Timer D | CHD1 PB14, CHD2 PB15 (AF13) - synchronous rectifiers
HRTIM1 faults | FLT2 PA15 (AF13) = input OVP; internal COMP1/COMP4/COMP6 outputs as fault sources
ADC1 | IN1 PA0 VBUS, IN2 PA1 IOUT, IN12 PB1 IL, IN14 PB11 VOUT
ADC2 | IN3 PA6 NTC
COMP1 / COMP4 / COMP6 | INP PB1 (+OCP), INP PB0 (-OCP), INP PB11 (VOUT OVP); INM from DAC3 channels
DAC1 | OUT2 PA5 = Test_pin_DAC; OUT1 PA4 reserved
DAC3 (internal) | Comparator thresholds, no pins
FDCAN1 | RX PA11, TX PA12 (AF9) -> isolated CAN
SWD | SWDIO PA13, SWCLK PA14, SWO PB3, NRST
RCC | HSE 16 MHz crystal PF0/PF1 -> PLL 170 MHz
GPIO | ADDR0-5 PC0-PC5 (in), LED_RUN PB9, LED_FLT PC10, SR_EN PC11, TP_GPIO1/2 PB6/PB7
Legend: green = used, blue = reserved, grey = unused (10k pull-down), yellow = power. Pin-map columns K-AA copied from the ST pin database.
Source: STMicroelectronics STM32_open_pin_data (CubeMX DB) - mcu/STM32G474R(B-C-E)Tx.xml and mcu/IP/GPIO-STM32G47x_gpio_v1_0_Modes.xml; matches datasheet DS12288 pin definition and alternate-function tables.
Design columns D-J generated from the Rev D netlist (design.py, U1). Edit the netlist, not this sheet, and regenerate.
