shousei01/dcdc_converter/01_hardware/docs/layout_review_layers.png

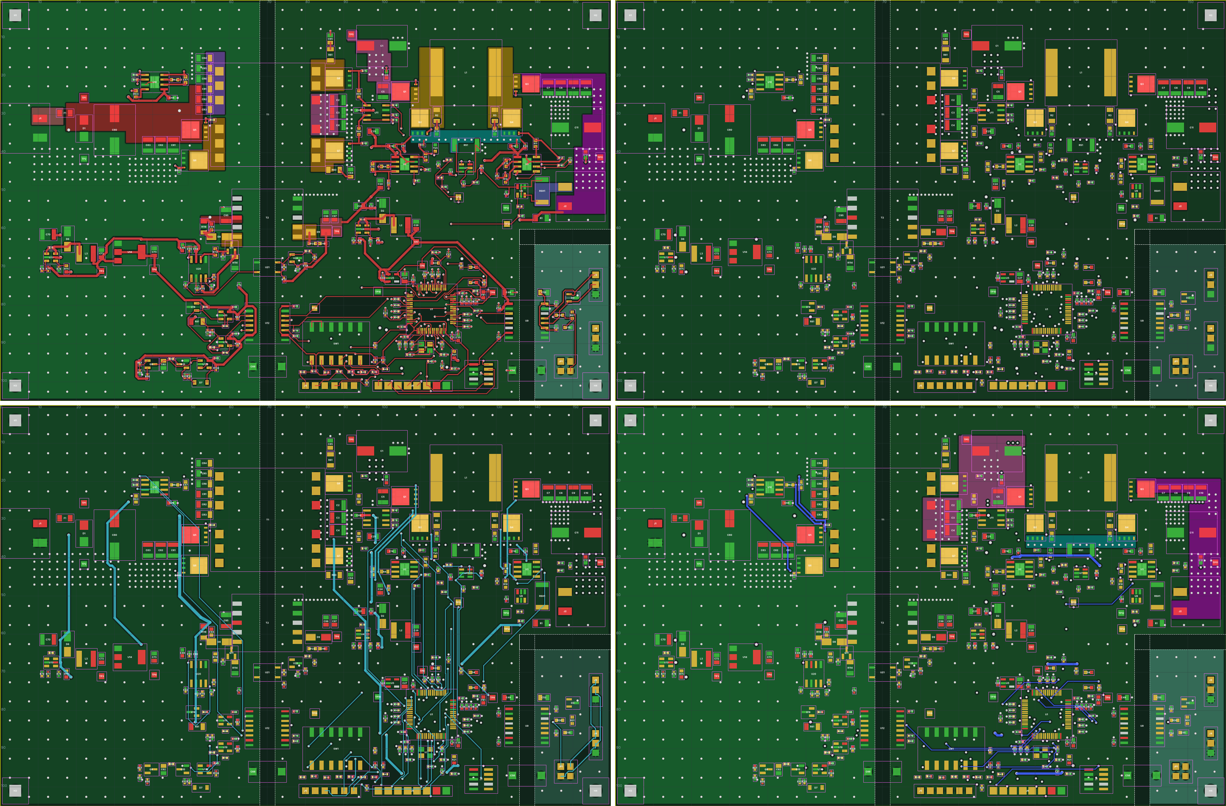
01_hardware/docs/layout_review_layers.png
