shousei01/dcdc_converter/01_hardware/bom/BOM_sourcing_revE.xlsx

Sheet: Summary
DCDC_LLC_4SBB_G474 Rev E - shortage risk, 2nd / 3rd sources (spec + footprint checked)
LCSC stock read live from lcsc.com on 2026-10-20. Stock moves daily - re-check at order time. JLC basic parts may be in JLC's own SMT stock when LCSC retail shows 0.
Risk | Lines | Rule
CRITICAL |  | Out of stock / not listed / < 50 boards, or a BOM error - change before ordering (same footprint)
HIGH |  | Covers < 100-300 boards, single maker, or discontinued - buy now
MEDIUM |  | Covers < 1,000 boards or alternates thin
LOW |  | Plenty of stock and two checked alternates
Check | Alternates | Meaning
DS |  | Checked against the datasheet: pinout vs board netlist, land pattern vs footprint, ratings
EQ |  | Same part number from another maker, or passive with same value / package / dielectric and equal-or-better rating
CHK |  | Usable; one item to confirm (see note)
PCB |  | Needs a PCB change - see 'PCB reserve'
Packages |  | All lines use industry-standard packages except: T2 (Pulse EP13Plus, vendor-specific) and T1 (custom PQ2620, hand-fitted). L1 1770 / L2-L3 5040 / SW1 2.54 SMD DIP / J1-J2 5.08 pluggable are de-facto standards made by many vendors.
First source changed on the Rev E BOM today (all in stock, same footprints):
C1235414 | STM32G474RBT3 (ST) | replaces C529413 STM32G474RBT6 - not listed / out of stock
C503061 | NCEP068N10G (NCE) | replaces C503012 NCEP0160AG
C2906861 | FRC0402F1002TS (FOJAN) | replaces C25744 0402WGF1002TCE - not listed / out of stock
C20539426 | TCC0402X5R105K500AT (CCTC) | replaces C52923 CL05A105KA5NQNC - not listed / out of stock
C2907006 | FRC0603F2R20TS (FOJAN) | replaces C22939 0603WAF220KT5E - not listed / out of stock
C2929994 | FRC0402F22R0TS (FOJAN) | replaces C25092 0402WGF220JTCE - not listed / out of stock
C844452 | TNPW040210K0BEED (VISHAY) | replaces C190095 RT0402BRD0710KL - not listed / out of stock
C85833 | BLM18KG601SN1D (muRata) | replaces C1002 GZ1608D601TF - not listed / out of stock
C167974 | FNR5040S470MT (cjiang) | replaces C86617 SWPA5040S470MT - not listed / out of stock
C2233314 | C0805C473F3GECAUTO (KEMET) | replaces C53134 CL21B473KBCNNNC
C2904236 | HoJLR2512-3W-4mR-1% (Milliohm) | replaces C500738 LR2512D-3W-4mR-1%
C2482 | SS110 (MDD(Microdiode Semiconductor)) | replaces C224219 SS110
C307331 | CL05B104KB54PNC | now also used for the 22 x 100 nF that were on C1525 (out of stock)
Buy now / watch:
C249664 | C1,C11,C60 | 175 pcs, 3 per board (58 boards). ChengTao RVE1J470M1010 is an exact 2nd source.
C49308184 | L1 | 120 pcs. Buy now. SMMS1770-220M / SLO1770C (both 23 A sat, 1770 body) - SOREDE 16 A part dropped.
C5718384 | T2 | 102 pcs, single maker (Pulse). Buy now. Backup needs the T2 jumper option (PA3855.005NLT in series).
C141980 | U2,U3,U10 | 338 pcs, 3 per board. UCC27211AQDDARQ1 (same DDA) / UCC27211DR (SOIC-8, no pad).
Not on LCSC | T1 | Custom PQ2620 transformer - the only part not orderable from LCSC
Extra to order | J1, J2 plugs | Kefa KF2EDGK-5.08-2P-AA (C440880), 2 per board - the cable-side plugs; JP1 needs one 2.54 mm jumper cap

Sheet: Sourcing
# | Designators | Qty / board | Description | Footprint | Package type | Primary MPN | Manufacturer | LCSC # | LCSC stock today | Boards covered | Price from (USD) | Risk | Action | Use as primary (same footprint) | 2nd source | 2nd LCSC # | 2nd stock | 2nd check | 2nd spec / fit note | 3rd source | 3rd LCSC # | 3rd stock | 3rd check | 3rd spec / fit note | Sources with stock for 100 boards
1 | C1,C11,C60 | 3 | 47u 63V | CP_Elec_10x10.5 | Standard (SMD alu 10x10.5) | VEJ470M1JTR-1010 | Lelon | C249664 | 175 |  | 0.0875 | HIGH | 175 pcs, 3 per board (58 boards). ChengTao RVE1J470M1010 is an exact 2nd source. |  | RVE1J470M1010 (ChengTao) | C46527630 | 350 | EQ | ChengTao RVE1J470M1010: 47 uF 63 V 10x10.5, 105 C | RVT63V100M10X10 (JIERR) | C51953411 | 24990 | CHK | JIERR 100 uF 63 V 10x10.5: same can, more C -> check F1 inrush
28 | L1 | 1 | PSPMAA1770-220M-CGP | L_Bourns_SRP1770TA_16.9x16.9mm | De-facto standard (many makers) (1770 molded) | PSPMAA1770-220M-CGP | PROD Tech | C49308184 | 120 |  | 0.8544 | HIGH | 120 pcs. Buy now. SMMS1770-220M / SLO1770C (both 23 A sat, 1770 body) - SOREDE 16 A part dropped. |  | SMMS1770-220M (Shun Xiang Nuo) | C2976969 | 961 | CHK | Shun Xiang Nuo SMMS1770-220M 22 uH, Isat 23 A, 17.5x17.2 - same 1770 body; confirm land drawing | SLO1770C220MTT (Sunltech) | C48996578 | 150 | DS | Sunltech SLO1770C220MTT 22 uH, Isat 23 A - land 3.5x12.8 / gap 11.2 fits the SRP1770 footprint
68 | T2 | 1 | PA3855.006NLT | TX_PA3855_EP13_10P | Vendor-specific (Pulse EP13Plus) | PA3855.006NLT | PULSE | C5718384 | 102 |  | 1.2828 | HIGH | 102 pcs, single maker (Pulse). Buy now. Backup needs the T2 jumper option (PA3855.005NLT in series). |  | PA3855.005NLT (PULSE) | C17526143 | 520 | PCB | Pulse PA3855.005NLT: same EP13 footprint and primary, secondaries must be in SERIES - needs the T2 jumper option |  |  |  |  | Custom-wound EP13 to the same pinout from a local winder (no PCB change)
70 | U2,U3,U10 | 3 | UCC27211DDAR | SOIC-8-1EP_3.9x4.9mm_P1.27mm_EP2.41x3.3mm | Standard (SOIC-8 PowerPAD) | UCC27211DDAR | TI | C141980 | 338 |  | 1.4619 | HIGH | 338 pcs, 3 per board. UCC27211AQDDARQ1 (same DDA) / UCC27211DR (SOIC-8, no pad). |  | UCC27211AQDDARQ1 (TI) | C485921 | 755 | DS | TI UCC27211AQDDARQ1 (same DDA package and pinout) | UCC27211DR (TI) | C2871979 | 2138 | DS | TI UCC27211DR SOIC-8 (no pad): same pinout; pad 9 left unsoldered - remove its paste for this build
19 | CR1,CR2,CR3,CR4,CR5,CR6 | 6 | 100n 100V C0G | C_1206_3216Metric | Standard (1206) | C1206N104J101T | IHHEC | C2940749 | 1802 |  | 0.1817 | MEDIUM | 902 pcs, 6 per board (150 boards). Murata / TDK 1206 C0G 100 V are verified 2nd/3rd (CCTC/HRE 'M3L' parts dropped: not C0G). |  | GRM31C5C2A104JA01L (muRata) | C405303 | 7815 | EQ | Murata GRM31C5C2A104JA01L 100 nF C0G 5 % 100 V 1206 | C3216C0G2A104JT000E (TDK) | C338111 | 1350 | EQ | TDK C3216C0G2A104JT000E 100 nF C0G 5 % 100 V 1206
26 | F1 | 1 | 0458007.DR | Fuse_1206_3216Metric | Standard (1206 fuse) | 0458007.DR | Littelfuse | C206980 | 765 |  | 0.4845 | MEDIUM | 765 pcs. Reomax R12.000.7 verified as 2nd source. |  | R12.000.7 (Reomax) | C5383192 | 2710 | DS | Reomax R12.000.7 7 A 63 V DC 1206 | 3413.0326.11 (SCHURTER) | C3165071 | 40 | EQ | Schurter 3413.0326.11 7 A 63 V 1206 (low stock)
30 | Q1,Q4 | 2 | NCEP0140AG | TDSON-8-1 | Standard (DFN5x6 / PowerPAK SO-8) | NCEP0140AG | NCE | C503009 | 4695 |  | 0.2860 | MEDIUM | 4,695 pcs (2,300 boards). NCE alternates have 2x the gate charge - fine, but check Q1/Q4 temperature on the bench if used. |  | NCEP095N10AG (NCE) | C2686677 | 645 | CHK | NCE NCEP095N10AG 100 V 12 mOhm: Qg 54 nC vs 26 nC - more gate/switching loss in the hard-switched Q1/Q4, check temp | NCEP068N10G (NCE) | C503061 | 7577 | CHK | NCE NCEP068N10G 100 V 6.1 mOhm: Qg 60 nC vs 26 nC - same check
35 | Q11 | 1 | FDN86246 | SOT-23 | Standard (SOT-23) | FDN86246 | onsemi | C891118 | 1606 |  | 0.6163 | MEDIUM | 1,606 pcs. JSMSEMI FDN86246 / HSS2N15 (150 V) - same SOT-23 pinout. |  | FDN86246 (JSMSEMI) | C7421706 | 4035 | EQ | JSMSEMI FDN86246 (same part no.) 150 V | HSS2N15 (HUASHUO) | C2987707 | 6090 | EQ | HUASHUO HSS2N15 150 V 1.8 A
51 | R81 | 1 | 191k 0.1% | R_1206_3216Metric | Standard (1206) | RT1206BRD07191KL | YAGEO | C870479 | 4755 |  | 0.0506 | MEDIUM | Single LCSC source (4,755 pcs, 1 per board). Other makers only at Digikey/Mouser. |  |  |  |  |  | No other 191k 0.1 % 1206 in stock on LCSC (Panasonic ERA-8AEB1913V / Vishay TNPW1206191KBEEA at Digikey/Mouser) |  |  |  |  | none in stock on LCSC
75 | U9 | 1 | CA-IS3062VW | SOIC-16W_7.5x10.3mm_P1.27mm | Standard (SOIC-16W) | CA-IS3062VW | Chipanalog | C5338808 | 4777 |  | 2.1600 | MEDIUM | 4,777 pcs but Chipanalog only (integrated isolated DC-DC). Backup ISO1042DW + B0505S needs the U9 reserve option. |  | ISO1042QDWRQ1 (TI) | C2671569 | 2231 | PCB | TI ISO1042QDWRQ1 fits the U9 footprint (pins 2-16 match) but needs pin 1 = 3.3 V and an external isolated 5 V (B0505S module) - U9 reserve option | ISO1042DWR (TI) | C1848126 | 270 | PCB | TI ISO1042DWR - same as above
77 | U12 | 1 | CA-IS3742LW | SOIC-16W_7.5x10.3mm_P1.27mm | Standard (SOIC-16W) | CA-IS3742LW | Chipanalog | C4944981 | 2320 |  | 0.4600 | MEDIUM | 2,320 pcs; default-LOW wide-body alternates exist but have low stock (TI 139, YLPTEC 90). |  | ISO7742FDWR (TI) | C2862403 | 139 | DS | TI ISO7742FDWR: same pinout, default LOW (F) like CA-IS3742L - low stock | ISO7742W0-Y (YLPTEC) | C53446650 | 90 | DS | YLPTEC ISO7742W0-Y: wide body, default LOW ('0') - low stock (do NOT use the N0 narrow-body part)
84 | U1 | 1 | STM32G474RBT3 (hand-soldered) | LQFP-64_10x10mm_P0.5mm | Standard (LQFP-64) | STM32G474RBT3 | ST | C1235414 | 564 |  | 2.9236 | MEDIUM | Primary covers the build; alternates thin - watch. |  | STM32G474RET6 (ST) | C521608 | 12 | EQ | ST STM32G474RET6 (512 KB, same pinout; 12 pcs) |  |  |  |  | none in stock on LCSC
89 | J7 | 1 | HX PZ1.27-2x5P TP (hand-soldered) | PinHeader_2x05_P1.27mm_Vertical_SMD | Standard (1.27 SMD header) | HX PZ1.27-2x5P TP | hanxia | C41376037 | 40345 |  |  | MEDIUM | Primary covers the build; alternates thin - watch. |  |  |  |  |  | Samtec FTSH-105-01-L-DV-K or any 2x5 1.27 mm SMD header |  |  |  |  | none in stock on LCSC
2 | C2,C3,C4,C5,C7,C8,C9,C10,C61,C62,C63,C70,C95 | 13 | 2.2u 100V X7R | C_1210_3225Metric | Standard (1210) | FS32X225K101EGG | PSA | C153036 | 261555 |  | 0.0476 | LOW | Stock fine; 2nd/3rd checked. |  | GRM32ER72A225KA35L (muRata) | C86054 | 25205 | EQ | Murata GRM32ER72A225KA35L 2.2 uF 100 V X7R 1210 | HMK325B7225KN-T (Taiyo Yuden) | C92775 | 30780 | EQ | Taiyo Yuden HMK325B7225KN-T 2.2 uF 100 V X7R 1210
3 | C6,C12 | 2 | 100n 100V X7R | C_0603_1608Metric | Standard (0603) | 0603B104K101NT | FH | C88219 | 1977150 |  | 0.0058 | LOW | Stock fine; 2nd/3rd checked. |  | CC0603KRX7R0BB104 (YAGEO) | C113803 | 328150 | EQ | Yageo CC0603KRX7R0BB104 100 V X7R | AM03B104K101NT (FH) | C42959888 | 4980 | EQ | FH AM03B104K101NT 100 V X7R
4 | C15,C18,C67 | 3 | 100n 25V X7R | C_0603_1608Metric | Standard (0603) | CC0603KRX7R9BB104 | YAGEO | C14663 | 6739100 |  | 0.0067 | LOW | Stock fine; 2nd/3rd checked. |  | 0603B104K500CT (Walsin) | C314282 | 835700 | EQ | Walsin 0603B104K500CT 50 V X7R | VJ0603Y104KXACW1BC (VISHAY) | C161854 | 13120 | EQ | Vishay VJ0603Y104KXACW1BC 50 V X7R
5 | C16,C19,C68,C69,C88 | 5 | 1u 25V X7R | C_0603_1608Metric | Standard (0603) | CL10A105KB8NNNC | Samsung Electro-Mechanics | C15849 | 2731000 |  | 0.0087 | LOW | Stock fine; 2nd/3rd checked. |  | 0603X105K500NT (FH) | C157684 | 774900 | EQ | FH 0603X105K500NT 1 uF 50 V X5R | CC0603KRX5R9BB105 (YAGEO) | C128624 | 23100 | EQ | Yageo CC0603KRX5R9BB105 1 uF 50 V X5R
6 | C17,C20,C22,C23,C71,C89,C29,C30,C31,C32,C33,C34,C37,C40,C43,C44,C46,C48,C50,C53,C54,C75,C77,C80,C83,C84,C90,C99 | 28 | 100n 25V | C_0402_1005Metric | Standard (0402) | CL05B104KB54PNC | Samsung Electro-Mechanics | C307331 | 2343800 |  | 0.0049 | LOW | Stock fine; 2nd/3rd checked. |  | CC0402KRX7R9BB104 (YAGEO) | C131394 | 4590850 | EQ | Yageo CC0402KRX7R9BB104 50 V X7R | 0402B104K500NT (FH) | C110251 | 1825760 | EQ | FH 0402B104K500NT 50 V X7R
7 | C21,C24,C25,C26,C72,C96,C97,C49,C52 | 9 | 10u 25V X5R | C_0805_2012Metric | Standard (0805) | CL21A106KAYNNNE | Samsung Electro-Mechanics | C15850 | 3082660 |  | 0.0528 | LOW | Stock fine; 2nd/3rd checked. |  | TCC0805X5R106K350FT (CCTC) | C18185754 | 100165 | EQ | CCTC TCC0805X5R106K350FT 10 uF 35 V X5R | GRM21BR6YA106KE43L (muRata) | C162422 | 99525 | EQ | Murata GRM21BR6YA106KE43L 10 uF 35 V X5R
8 | C27,C73 | 2 | 22u 10V X5R | C_0805_2012Metric | Standard (0805) | CL21A226MAQNNNE | Samsung Electro-Mechanics | C45783 | 100080 |  | 0.1061 | LOW | Stock fine; 2nd/3rd checked. |  | TCC0805X5R226M250FT (CCTC) | C20416420 | 131690 | EQ | CCTC TCC0805X5R226M250FT 22 uF 25 V | 0805X226M250NT (FH) | C129303 | 85780 | EQ | FH 0805X226M250NT 22 uF 25 V
9 | C28,C36,C51,C86 | 4 | 1u 10V | C_0402_1005Metric | Standard (0402) | TCC0402X5R105K500AT | CCTC | C20539426 | 179400 |  | 0.0099 | LOW | Stock fine; 2nd/3rd checked. |  | GRM155R61H105KE05D (muRata) | C1518208 | 32180 | EQ | Murata GRM155R61H105KE05D 1 uF 50 V X5R |  |  |  |  | none in stock on LCSC
10 | C35 | 1 | 4.7u 10V | C_0603_1608Metric | Standard (0603) | CL10A475KO8NNNC | Samsung Electro-Mechanics | C19666 | 584680 |  | 0.0114 | LOW | Stock fine; 2nd/3rd checked. |  | EMK107ABJ475KA-T (Taiyo Yuden) | C92758 | 157460 | EQ | Taiyo Yuden EMK107ABJ475KA-T 16 V X5R | GRM188R61E475KE11D (muRata) | C90057 | 106410 | EQ | Murata GRM188R61E475KE11D 25 V X5R
11 | C38,C39 | 2 | 12p C0G | C_0402_1005Metric | Standard (0402) | 0402CG120J500NT | FH | C1547 | 1236600 |  | 0.0013 | LOW | Stock fine; 2nd/3rd checked. |  | 0402CG120F500NT (FH) | C182477 | 145100 | EQ | FH 0402CG120F500NT 12 pF C0G 1 % | AM02CG120J500NT (FH) | C49238110 | 6900 | EQ | FH AM02CG120J500NT 12 pF C0G
12 | C41,C42,C79,C91,C92 | 5 | 1n C0G | C_0402_1005Metric | Standard (0402) | CC0402JRNPO9BN102 | YAGEO | C113780 | 60500 |  | 0.0096 | LOW | Stock fine; 2nd/3rd checked. |  | 0402N102J500CT (Walsin) | C237166 | 158300 | EQ | Walsin 0402N102J500CT 1 nF NP0 | AC0402JRNPO9BN102 (YAGEO) | C427014 | 12750 | EQ | Yageo AC0402JRNPO9BN102 1 nF NP0
13 | C45 | 1 | 470p C0G | C_0402_1005Metric | Standard (0402) | CC0402JRNPO9BN471 | YAGEO | C106259 | 349500 |  | 0.0021 | LOW | Stock fine; 2nd/3rd checked. |  | 0402N471J500CT (Walsin) | C295986 | 74200 | EQ | Walsin 0402N471J500CT 470 pF NP0 | CC0402GRNPO9BN471 (YAGEO) | C541429 | 2700 | EQ | Yageo CC0402GRNPO9BN471 470 pF NP0 2 %
14 | C47 | 1 | 10n C0G | C_0402_1005Metric | Standard (0402) | GRM1555C1H103JE01D | muRata | C22400107 | 52755 |  | 0.0600 | LOW | Stock fine; 2nd/3rd checked. |  | GRM1555C1E103JE01D (muRata) | C3855387 | 65320 | EQ | Murata GRM1555C1E103JE01D C0G 25 V (C47 sits on a 3.3 V ADC node) | CGA0402C0G103J250GT (HRE) | C36911359 | 10855 | EQ | HRE CGA0402C0G103J250GT C0G 25 V
15 | C55 | 1 | 4.7n | C_0603_1608Metric | Standard (0603) | 0603B472K500NT | FH | C53987 | 309050 |  | 0.0027 | LOW | Stock fine; 2nd/3rd checked. |  | 0603B472K101NT (FH) | C12164 | 14250 | EQ | FH 0603B472K101NT 100 V X7R | 0603B472J500NT (FH) | C168956 | 9300 | EQ | FH 0603B472J500NT 50 V X7R
16 | C81,C93 | 2 | 220p C0G | C_0402_1005Metric | Standard (0402) | CC0402JRNPO9BN221 | YAGEO | C107001 | 483000 |  | 0.0024 | LOW | Stock fine; 2nd/3rd checked. |  | 0402N221J500CT (Walsin) | C301973 | 33400 | EQ | Walsin 0402N221J500CT 220 pF NP0 | CC0402GRNPO9BN221 (YAGEO) | C541425 | 27400 | EQ | Yageo CC0402GRNPO9BN221 220 pF NP0
17 | C82 | 1 | C0805C473F3GECAUTO | C_0805_2012Metric | Standard (0805) | C0805C473F3GECAUTO | KEMET | C2233314 | 2403 |  | 0.4834 | LOW | Stock fine; 2nd/3rd checked. |  | C0805C473K3GECTU (KEMET) | C22409143 | 830 | DS | KEMET C0805C473K3GECTU 47 nF C0G 10 % 25 V | CL21B473KBCNNNC (Samsung Electro-Mechanics) | C53134 | 23600 | EQ | previous primary (low / no stock)
18 | C94 | 1 | 4.7n 100V X7R | C_0603_1608Metric | Standard (0603) | CC0603KRX7R0BB472 | YAGEO | C115052 | 80950 |  | 0.0080 | LOW | Stock fine; 2nd/3rd checked. |  | 0603B472K101NT (FH) | C12164 | 14250 | EQ | FH 0603B472K101NT 100 V X7R | 0603B472K101CT (Walsin) | C152940 | 2600 | EQ | Walsin 0603B472K101CT 100 V X7R
20 | D1 | 1 | SMBJ51A | D_SMB | Standard (SMB) | SMBJ51A | OTW | C20883337 | 9260 |  | 0.0163 | LOW | Stock fine; 2nd/3rd checked. |  | SMBJ51A (Littelfuse) | C1973217 | 7885 | EQ | Littelfuse SMBJ51A | SMBJ51A (RUILON) | C10225 | 2665 | EQ | RUILON SMBJ51A
21 | D2,D6,D8,D9 | 4 | SS110 | D_SMA | Standard (SMA) | SS110 | MDD(Microdiode Semiconductor) | C2482 | 163400 |  | 0.0100 | LOW | Stock fine; 2nd/3rd checked. |  | STPS1H100A (ST) | C165701 | 18455 | EQ | ST STPS1H100A 100 V 1 A SMA (lower leakage) | SS110 (Guangdong Hottech) | C224219 | 1360 | EQ | previous primary (low / no stock)
22 | D3 | 1 | NUP2105LT1G | SOT-23 | Standard (SOT-23) | NUP2105LT1G | onsemi | C14486 | 119530 |  | 0.0381 | LOW | Stock fine; 2nd/3rd checked. |  | NUP2105LT1G (GOODWORK) | C21713988 | 68040 | EQ | GOODWORK NUP2105LT1G (same part no., same pinout 1=CAN 2=CAN 3=GND) | NUP2105L (DOWO) | C284104 | 57270 | EQ | DOWO NUP2105L
23 | D4 | 1 | GREEN RUN | LED_0603_1608Metric | Standard (0603 LED) | KT-0603G | Hubei KENTO Elec | C12624 | 476000 |  | 0.0058 | LOW | Stock fine; 2nd/3rd checked. |  | 19-217/GHC-YR1S2/6T (EVERLIGHT) | C2986059 | 837050 | EQ | Everlight 19-217/GHC emerald green | 19-217/G7C-AN1P2/6T (EVERLIGHT) | C2986030 | 845850 | CHK | Everlight yellow-green, Vf 2.0 V (brighter at the same resistor)
24 | D5 | 1 | RED FAULT | LED_0603_1608Metric | Standard (0603 LED) | KT-0603R | Hubei KENTO Elec | C2286 | 5889200 |  | 0.0036 | LOW | Stock fine; 2nd/3rd checked. |  | 19-217/R6C-AL1M2VY/6T (EVERLIGHT) | C2986060 | 3778500 | EQ | Everlight 19-217/R6C red | 19-217/R6C-P1Q2/6T (EVERLIGHT) | C2986061 | 64200 | EQ | Everlight 19-217/R6C-P1Q2 red
25 | D7 | 1 | 1N4148W | D_SOD-123 | Standard (SOD-123) | 1N4148W | ST(Semtech) | C81598 | 2881050 |  | 0.0061 | LOW | Stock fine; 2nd/3rd checked. |  | 1N4448W (ST(Semtech)) | C108428 | 1400 | EQ | 1N4448W 80 V SOD-123 |  |  |  |  | none in stock on LCSC
27 | FB1 | 1 | BLM18KG601SN1D | L_0603_1608Metric | Standard (0603 bead) | BLM18KG601SN1D | muRata | C85833 | 806800 |  | 0.0093 | LOW | Stock fine; 2nd/3rd checked. |  | BLM18KG601SH1D (muRata) | C710379 | 21960 | EQ | Murata BLM18KG601SH1D 600R 1.3 A |  |  |  |  | none in stock on LCSC
29 | L2,L3 | 2 | FNR5040S470MT | L_Sunlord_SWPA5040S | De-facto standard (many makers) (5040 shielded) | FNR5040S470MT | cjiang | C167974 | 35940 |  | 0.0455 | LOW | Stock fine; 2nd/3rd checked. |  | ANR5040T470M (APV) | C7427133 | 7940 | CHK | APV ANR5040T470M 47 uH 1.3 A sat - no datasheet on LCSC; 5040 body |  |  |  |  | none in stock on LCSC
31 | Q2,Q3,Q5,Q6 | 4 | NCEP068N10G | TDSON-8-1 | Standard (DFN5x6 / PowerPAK SO-8) | NCEP068N10G | NCE | C503061 | 7577 |  | 0.6372 | LOW | Stock fine; 2nd/3rd checked. |  | NCEP095N10AG (NCE) | C2686677 | 645 | DS | NCE NCEP095N10AG 100 V 12 mOhm, Qg 54 nC | NCEP0160AG (NCE) | C503012 | 38 | EQ | previous primary (low / no stock)
32 | Q7,Q8 | 2 | BSC160N15NS5 | TDSON-8-1 | Standard (DFN5x6 / SuperSO8) | BSC160N15NS5 | Infineon | C459172 | 4771 |  | 0.5455 | LOW | Stock fine; 2nd/3rd checked. |  | SP015N13GHNK (Siliup) | C22466810 | 465 | DS | Siliup SP015N13GHNK 150 V 13 mOhm, Qg 30 nC (primary 19 nC) - fine for UCC27524 | LN7910DT1WG (LRC) | C2936692 | 1461 | CHK | LRC LN7910DT1WG 150 V 15 mOhm - Qg not readable in the datasheet text
33 | Q9 | 1 | MMBT3906 | SOT-23 | Standard (SOT-23) | MMBT3906LT1G | onsemi | C53444 | 938050 |  | 0.0086 | LOW | Stock fine; 2nd/3rd checked. |  | PMBT3906,215 (Nexperia) | C8670 | 114520 | EQ | Nexperia PMBT3906 | S-LMBT3906LT1G (LRC) | C383300 | 5280 | EQ | LRC S-LMBT3906LT1G
34 | Q10 | 1 | 2N7002 | SOT-23 | Standard (SOT-23) | 2N7002 | JSCJ | C8545 | 1919050 |  | 0.0105 | LOW | Stock fine; 2nd/3rd checked. |  | BSS123 (JSCJ) | C79015 | 150960 | EQ | JSCJ BSS123 100 V (G-S-D pinout) | CJ2310 (JSCJ) | C75882 | 156800 | EQ | JSCJ CJ2310 60 V 3 A
36 | R1 | 1 | 47k | R_1206_3216Metric | Standard (1206) | FRC1206J473 TS | FOJAN | C2907507 | 771700 |  | 0.0022 | LOW | Stock fine; 2nd/3rd checked. |  | RC1206FR-0747KL (YAGEO) | C137270 | 372600 | EQ | Yageo RC1206FR-0747KL 1 % (primary is 5 %) | FRC1206F4702TS (FOJAN) | C2933708 | 296200 | EQ | FOJAN FRC1206F4702TS 1 %
37 | R4,R5,R10,R11,R68,R69 | 6 | 4R7 | R_0603_1608Metric | Standard (0603) | 0603WAF470KT5E | UNI-ROYAL | C23164 | 20900 |  | 0.0014 | LOW | Stock fine; 2nd/3rd checked. |  | FRC0603F4R70TS (FOJAN) | C2907035 | 4914100 | EQ | FOJAN FRC0603F4R70TS | RC0603FR-074R7L (YAGEO) | C137705 | 8600 | EQ | Yageo RC0603FR-074R7L
38 | R6,R7,R8,R9,R12,R13,R14,R15,R20,R32,R33,R34,R35,R36,R37,R64,R65,R66,R67,R70,R71,R72,R73,R74,R79,R80,R83,R90,R91,R92,R93,R94,R95,R96,R97,R98,R99,R100,R101,R102,R103,R104,R105,R108,R113,R19,R29,R78,R87,R111,R120 | 51 | 10k | R_0402_1005Metric | Standard (0402) | FRC0402F1002TS | FOJAN | C2906861 | 14247200 |  | 0.0008 | LOW | Stock fine; 2nd/3rd checked. |  | RC0402FR-0710KL (YAGEO) | C60490 | 431300 | EQ | Yageo RC0402FR-0710KL |  |  |  |  | none in stock on LCSC
39 | R16,R18,R86 | 3 | 56k 1% | R_0402_1005Metric | Standard (0402) | 0402WGF5602TCE | UNI-ROYAL | C25796 | 13600 |  | 0.0016 | LOW | Stock fine; 2nd/3rd checked. |  | RC0402FR-0756KL (YAGEO) | C114756 | 1195200 | EQ | Yageo RC0402FR-0756KL | FRC0402F5602TS (FOJAN) | C2906875 | 728300 | EQ | FOJAN FRC0402F5602TS
40 | R17,R88 | 2 | 15k 1% | R_0402_1005Metric | Standard (0402) | 0402WGF1502TCE | UNI-ROYAL | C25756 | 1071900 |  | 0.0005 | LOW | Stock fine; 2nd/3rd checked. |  | RC0402FR-0715KL (YAGEO) | C114761 | 1482500 | EQ | Yageo RC0402FR-0715KL | FRC0402F1502TS (FOJAN) | C2909322 | 2074900 | EQ | FOJAN FRC0402F1502TS
41 | R21,R23 | 2 | 100k 0.1% | R_0603_1608Metric | Standard (0603) | RT0603BRD07100KL | YAGEO | C122538 | 1098200 |  | 0.0218 | LOW | Stock fine; 2nd/3rd checked. |  | TNPW0603100KBEEA (VISHAY) | C844888 | 46265 | EQ | Vishay TNPW0603100KBEEA 0.1 % 25 ppm | ERA3AEB104V (PANASONIC) | C190609 | 540 | EQ | Panasonic ERA3AEB104V 0.1 % 25 ppm
42 | R22,R24 | 2 | 5.1k 0.1% | R_0402_1005Metric | Standard (0402) | RN73H1ETTP5101B25 | KOA | C186154 | 6975 |  | 0.0947 | LOW | Stock fine; 2nd/3rd checked. |  | RT0402BRD075K1L (YAGEO) | C852856 | 15760 | EQ | Yageo RT0402BRD075K1L 0.1 % 25 ppm | TNPW04025K10BEED (VISHAY) | C2088796 | 7905 | EQ | Vishay TNPW04025K10BEED
43 | R25,R26 | 2 | 1k 0.1% | R_0402_1005Metric | Standard (0402) | RN73H1ETTP1001B25 | KOA | C186137 | 8110 |  | 0.1296 | LOW | Stock fine; 2nd/3rd checked. |  | RT0402BRD071KL (YAGEO) | C852624 | 293450 | EQ | Yageo RT0402BRD071KL 0.1 % 25 ppm | ARG02BTC1001 (Viking) | C2984405 | 26950 | EQ | Viking ARG02BTC1001
44 | R27 | 1 | 100R | R_0402_1005Metric | Standard (0402) | 0402WGF1000TCE | UNI-ROYAL | C25076 | 3045000 |  | 0.0008 | LOW | Stock fine; 2nd/3rd checked. |  | RC0402FR-07100RL (YAGEO) | C106232 | 8387000 | EQ | Yageo RC0402FR-07100RL | FRC0402F1000TS (FOJAN) | C2906860 | 7638200 | EQ | FOJAN FRC0402F1000TS
45 | R28,R38,R39,R40,R41,R42,R43,R44,R45,R85,R106,R109,R115,R118 | 14 | 1k | R_0402_1005Metric | Standard (0402) | 0402WGF1001TCE | UNI-ROYAL | C11702 | 8909200 |  | 0.0008 | LOW | Stock fine; 2nd/3rd checked. |  | FRC0402F1001TS (FOJAN) | C2906864 | 14359800 | EQ | FOJAN FRC0402F1001TS | RC0402FR-071KL (YAGEO) | C106235 | 209800 | EQ | Yageo RC0402FR-071KL
46 | R30,R31 | 2 | 60.4R | R_0603_1608Metric | Standard (0603) | FRC0603F60R4TS | FOJAN | C2933247 | 423800 |  | 0.0010 | LOW | 423 k pcs; Yageo 60.4R 2nd; no 3rd in stock. |  | RC0603FR-0760R4L (YAGEO) | C245987 | 191800 | EQ | Yageo RC0603FR-0760R4L |  |  |  |  | none in stock on LCSC
47 | R62,R63 | 2 | 2R2 | R_0603_1608Metric | Standard (0603) | FRC0603F2R20TS | FOJAN | C2907006 | 3848600 |  | 0.0013 | LOW | Stock fine; 2nd/3rd checked. |  | RC0603FR-072R2L (YAGEO) | C112307 | 445600 | EQ | Yageo RC0603FR-072R2L |  |  |  |  | none in stock on LCSC
48 | R75 | 1 | 470k | R_0603_1608Metric | Standard (0603) | 0603WAF4703T5E | UNI-ROYAL | C23178 | 655300 |  | 0.0014 | LOW | Stock fine; 2nd/3rd checked. |  | RC0603FR-07470KL (YAGEO) | C114622 | 272700 | EQ | Yageo RC0603FR-07470KL | FRC0603F4703TS (FOJAN) | C2907040 | 2245400 | EQ | FOJAN FRC0603F4703TS
49 | R76 | 1 | 68k | R_0402_1005Metric | Standard (0402) | 0402WGF6802TCE | UNI-ROYAL | C36871 | 2300 |  | 0.0011 | LOW | Stock fine; 2nd/3rd checked. |  | RC0402FR-0768KL (YAGEO) | C137947 | 473100 | EQ | Yageo RC0402FR-0768KL | FRC0402F6802TS (FOJAN) | C2909379 | 1801400 | EQ | FOJAN FRC0402F6802TS
50 | R77 | 1 | 120k 1% | R_0402_1005Metric | Standard (0402) | 0402WGF1203TCE | UNI-ROYAL | C25750 | 390700 |  | 0.0006 | LOW | Stock fine; 2nd/3rd checked. |  | RC0402FR-07120KL (YAGEO) | C93945 | 1326500 | EQ | Yageo RC0402FR-07120KL | FRC0402F1203TS (FOJAN) | C2909314 | 1322500 | EQ | FOJAN FRC0402F1203TS
52 | R82 | 1 | 10k 0.1% | R_0402_1005Metric | Standard (0402) | TNPW040210K0BEED | VISHAY | C844452 | 55710 |  | 0.0341 | LOW | Stock fine; 2nd/3rd checked. |  | TC02G1002BT (FH) | C2961361 | 7510 | EQ | FH TC02G1002BT 0.1 % 25 ppm |  |  |  |  | none in stock on LCSC
53 | R84 | 1 | 2.2M | R_0402_1005Metric | Standard (0402) | 0402WGF2204TCE | UNI-ROYAL | C11490 | 5900 |  | 0.0005 | LOW | Stock fine; 2nd/3rd checked. |  | RC0402FR-072M2L (YAGEO) | C138015 | 115100 | EQ | Yageo RC0402FR-072M2L | FRC0402F2204TS (FOJAN) | C2998080 | 349600 | EQ | FOJAN FRC0402F2204TS
54 | R89 | 1 | 22R | R_0402_1005Metric | Standard (0402) | FRC0402F22R0TS | FOJAN | C2929994 | 4263000 |  | 0.0011 | LOW | Stock fine; 2nd/3rd checked. |  | RC0402FR-0722RL (YAGEO) | C114765 | 2478600 | EQ | Yageo RC0402FR-0722RL |  |  |  |  | none in stock on LCSC
55 | R107 | 1 | 100k | R_0402_1005Metric | Standard (0402) | 0402WGF1003TCE | UNI-ROYAL | C25741 | 2245100 |  | 0.0008 | LOW | Stock fine; 2nd/3rd checked. |  | RC0402FR-07100KL (YAGEO) | C60491 | 8076400 | EQ | Yageo RC0402FR-07100KL | FRC0402F1003TS (FOJAN) | C2906859 | 4253800 | EQ | FOJAN FRC0402F1003TS
56 | R110 | 1 | 4.7M | R_0402_1005Metric | Standard (0402) | AC0402FR-074M7L | YAGEO | C227116 | 4300 |  | 0.0031 | LOW | Stock fine; 2nd/3rd checked. |  | FRC0402F4704TS (FOJAN) | C3013173 | 108900 | EQ | FOJAN FRC0402F4704TS | RC0402FR-074M7L (YAGEO) | C354978 | 48400 | EQ | Yageo RC0402FR-074M7L
57 | R112 | 1 | 10R | R_0603_1608Metric | Standard (0603) | 0603WAF100JT5E | UNI-ROYAL | C22859 | 1142980 |  | 0.0017 | LOW | Stock fine; 2nd/3rd checked. |  | RC0603FR-0710RL (YAGEO) | C109318 | 5228200 | EQ | Yageo RC0603FR-0710RL | FRC0603F10R0TS (FOJAN) | C2906983 | 1939500 | EQ | FOJAN FRC0603F10R0TS
58 | R114 | 1 | 0R5 1% | R_1206_3216Metric | Standard (1206) | 1206W4F500LT5E | UNI-ROYAL | C25340 | 454700 |  | 0.0041 | LOW | Stock fine; 2nd/3rd checked. |  | RL1206FR-070R5L (YAGEO) | C327075 | 7000 | EQ | Yageo RL1206FR-070R5L | HP06W2F500LT5E (UNI-ROYAL) | C2759131 | 9680 | EQ | UNI-ROYAL HP06W2F500LT5E 0.5 W
59 | R116 | 1 | 4k7 | R_1206_3216Metric | Standard (1206) | 1206W4F4701T5E | UNI-ROYAL | C17936 | 2003100 |  | 0.0037 | LOW | Stock fine; 2nd/3rd checked. |  | RC1206FR-074K7L (YAGEO) | C137262 | 47700 | EQ | Yageo RC1206FR-074K7L | NQ06W4F4701T5E (UNI-ROYAL) | C965034 | 5450 | EQ | UNI-ROYAL NQ06W4F4701T5E
60 | R117 | 1 | 1k5 | R_0402_1005Metric | Standard (0402) | 0402WGF1501TCE | UNI-ROYAL | C25867 | 778200 |  | 0.0013 | LOW | Stock fine; 2nd/3rd checked. |  | RC0402FR-071K5L (YAGEO) | C114759 | 965400 | EQ | Yageo RC0402FR-071K5L | FRC0402F1501TS (FOJAN) | C2933074 | 2177800 | EQ | FOJAN FRC0402F1501TS
61 | R119 | 1 | 30k 1% | R_0402_1005Metric | Standard (0402) | 0402WGF3002TCE | UNI-ROYAL | C25776 | 1408700 |  | 0.0008 | LOW | Stock fine; 2nd/3rd checked. |  | RC0402FR-0730KL (YAGEO) | C138008 | 307000 | EQ | Yageo RC0402FR-0730KL | FRC0402F3002TS (FOJAN) | C2909347 | 1724400 | EQ | FOJAN FRC0402F3002TS
62 | R121 | 1 | 4k7 | R_0402_1005Metric | Standard (0402) | 0402WGF4701TCE | UNI-ROYAL | C25900 | 8383200 |  | 0.0011 | LOW | Stock fine; 2nd/3rd checked. |  | RC0402FR-074K7L (YAGEO) | C105871 | 7531300 | EQ | Yageo RC0402FR-074K7L | CQ02WGF4701TCE (UNI-ROYAL) | C2765614 | 89400 | EQ | UNI-ROYAL CQ02WGF4701TCE
63 | R123,R124,R125,R126,R127,R128 | 6 | 0402WGF475JTCE | R_0402_1005Metric | Standard (0402) | 0402WGF475JTCE | UNI-ROYAL | C82290 | 10000 |  | 0.0013 | LOW | Stock fine; 2nd/3rd checked. |  | FRC0402F47R5TS (FOJAN) | C5159689 | 2400 | EQ | FOJAN FRC0402F47R5TS 47.5 R 1% 0402 62.5 mW | RTT0247R5FTH (RALEC) | C159023 | 9900 | EQ | RALEC RTT0247R5FTH 47.5 R 1% 0402 62.5 mW
64 | R129 | 1 | FRC0603F2R00TS | R_0603_1608Metric | Standard (0603) | FRC0603F2R00TS | FOJAN | C2933191 | 2259500 |  | 0.0022 | LOW | Stock fine; 2nd/3rd checked. |  | RC0603FR-7W2RL (YAGEO) | C2930558 | 17600 | EQ | YAGEO RC0603FR-7W2RL 2 R 1% 0603 200 mW |  |  |  |  | none in stock on LCSC
65 | RS1 | 1 | HoJLR2512-3W-4mR-1% | R_2512_6332Metric | Standard (2512) | HoJLR2512-3W-4mR-1% | Milliohm | C2904236 | 21240 |  | 0.0415 | LOW | Stock fine; 2nd/3rd checked. |  | HoLR2512-3W-4mR-1%-15ppm (Milliohm) | C2908366 | 3915 | EQ | Milliohm HoLR2512-3W-4mR-1%-15ppm | LR2512D-3W-4mR-1% (Milliohm) | C500738 | 3680 | EQ | previous primary (low / no stock)
66 | RSH1 | 1 | 10m 1% 1W | R_2512_6332Metric | Standard (2512) | GX2512-2W-10mR-1% | Milliohm | C500718 | 2140 |  | 0.0414 | LOW | Stock fine; 2nd/3rd checked. |  | HoYLR2512-3W-10mR-1% (Milliohm) | C5375464 | 223160 | EQ | Milliohm HoYLR2512-3W-10mR-1% | HoLLR2512-3W-10mR-1% (Milliohm) | C2994644 | 4180 | EQ | Milliohm HoLLR2512-3W-10mR-1%
67 | SW1 | 1 | DIP-6 | SW_DIP_SPSTx06_Slide_6.7x16.8mm_W8.61mm_P2.54mm_LowProfile | De-facto standard (many makers) (2.54 mm SMD DIP) | 2.54-6P TPGT | SHOU HAN | C6331172 | 11262 |  | 0.3527 | LOW | 11,262 pcs; HX TPGT clone (2,002 pcs) is the same body. |  | HX 2.54-6P TPGT (hanxia) | C19189100 | 2002 | EQ | hanxia HX 2.54-6P TPGT (same 6.15x15.24 TPGT body; primary land 1.1 x 2.2 mm, rows 6.6 / 11 mm = footprint) | DM-06-V-T/R (Diptronics) | C225006 | 4401 | CHK | Diptronics DM-06-V-T/R 6-pos 2.54 SMD - confirm row spacing vs footprint
69 | TH1 | 1 | 10k B3950 | R_0603_1608Metric | Standard (0603) | KNTC0603/10KF3950 | KUU | C2892547 | 109660 |  | 0.0133 | LOW | Stock fine; 2nd/3rd checked. |  | HNTC0603-103F3950FB (R+O) | C49247666 | 50770 | EQ | R+O HNTC0603-103F3950FB 10k 1 % B25/50 3950 | ANTC1608-103F3950FB (APV) | C52155406 | 5620 | EQ | APV ANTC1608-103F3950FB 10k 1 % B3950
71 | U4,U13 | 2 | LMR16006XDDCR | SOT-23-6 | Standard (SOT-23-6) | LMR16006XDDCR | TI | C87080 | 43365 |  | 0.3314 | LOW | Stock fine; 2nd/3rd checked. |  | LV2862XLVDDCR (TI) | C3200285 | 34923 | DS | TI LV2862XLVDDCR: same pinout (CB GND FB EN VIN SW), 0.765 V FB, 60 V, 770 kHz; EN threshold 1.25 V -> U13 UVLO ~10 V instead of ~12 V | LMR16006YDDCR (TI) | C290195 | 20508 | DS | TI LMR16006YDDCR 2.1 MHz: same pinout; 47 uH fine; U13 at 48 V runs near min on-time
72 | U5 | 1 | TLV75533PDBVR | SOT-23-5 | Standard (SOT-23-5) | TLV75533PDBVR | TI | C404027 | 114670 |  | 0.0659 | LOW | Stock fine; 2nd/3rd checked. |  | TLV75733PDBVR (TI) | C485517 | 57390 | DS | TI TLV75733PDBVR (1 A, same pinout) | RT9013-33GB (RICHTEK) | C47773 | 273255 | DS | Richtek RT9013-33GB: VIN GND EN NC VOUT = same, 5.5 V max (input is +5V)
73 | U7 | 1 | INA181A1IDBVR | SOT-23-6 | Standard (SOT-23-6) | INA181A1IDBVR | TI | C2058943 | 5213 |  | 0.2538 | LOW | Stock fine; 2nd/3rd checked. |  | INA181A1IDBVT (TI) | C2861997 | 514 | EQ | TI INA181A1IDBVT (same part, small reel) | INA181A1IDBVR(XBLW) (XBLW) | C45351496 | 4285 | CHK | XBLW INA181A1IDBVR clone - confirm gain error
74 | U8 | 1 | INA181A2IDBVR | SOT-23-6 | Standard (SOT-23-6) | INA181A2IDBVR | TI | C2058784 | 55660 |  | 0.1946 | LOW | Stock fine; 2nd/3rd checked. |  | INA181A2IDBVT (TI) | C116200 | 1074 | EQ | TI INA181A2IDBVT (same part, small reel) | INA181A2IDBVR(LX) (lingxingic) | C53198613 | 2655 | CHK | lingxingic INA181A2 clone - confirm gain error
76 | U11 | 1 | UCC27524DR | SOIC-8_3.9x4.9mm_P1.27mm | Standard (SOIC-8) | UCC27524DR | TI | C465729 | 17531 |  | 0.2077 | LOW | Stock fine; 2nd/3rd checked. |  | UCC27524ADR (TI) | C185857 | 26155 | DS | TI UCC27524ADR (same pinout ENA INA GND INB OUTB VDD OUTA ENB) | UCC27524DR(UMW) (UMW) | C20623206 | 3055 | DS | UMW UCC27524DR - datasheet states pin-to-pin with 27524
78 | U14 | 1 | AMS1117-5.0 | SOT-223-3_TabPin2 | Standard (SOT-223) | AMS1117-5.0 | Advanced Monolithic Systems | C6187 | 6670 |  | 0.1270 | LOW | Stock fine; 2nd/3rd checked. |  | AMS1117-5.0 (GOODWORK) | C6068482 | 52680 | EQ | GOODWORK AMS1117-5.0 (same part no.) | LD1117-5.0 (UMW) | C347230 | 98350 | EQ | UMW LD1117-5.0 (GND OUT IN, 15 V max; input +10V_P)
79 | U15,U17,U18 | 3 | LMV331IDBVR | SOT-23-5 | Standard (SOT-23-5) | LMV331IDBVR | TI | C34731 | 144505 |  | 0.0672 | LOW | Stock fine; 2nd/3rd checked. |  | LMV331X-S5TR (3PEAK) | C38943276 | 35930 | DS | 3PEAK LMV331X-S5TR: open-drain, pinout +IN -VS -IN OUT +VS = TI DBV, 35.9 k pcs | LMV331ILT (ST) | C672259 | 2635 | DS | ST LMV331ILT: open-drain, same SOT23-5 pinout
80 | U16,U22 | 2 | TL431AIDBZR | SOT-23 | Standard (SOT-23) | TL431AIDBZR | TI | C23892 | 121415 |  | 0.0449 | LOW | Stock fine; 2nd/3rd checked. |  | TL431AIDBZR(UMW) (UMW) | C29780634 | 12440 | DS | UMW TL431AIDBZR: 1=K 2=REF 3=A = TI DBZ (U22 needs this pinout) | TL431AIDBZR,215 (Nexperia) | C79737 | 4385 | DS | Nexperia TL431AIDBZR,215 'normal pinning' 1=K 2=REF 3=A (not the MFDT mirrored type)
81 | U20 | 1 | UC3843BVD1R2G | SOIC-8_3.9x4.9mm_P1.27mm | Standard (SOIC-8) | UC3843BVD1R2G | onsemi | C231572 | 22345 |  | 0.1922 | LOW | Stock fine; 2nd/3rd checked. |  | UC2843BD1R2G (onsemi) | C59197 | 72335 | EQ | onsemi UC2843BD1R2G (same die, -25..85 C) | UC3843D8TR (TI) | C702405 | 1296 | EQ | TI UC3843D8TR (same 8-pin pinout, 0..70 C)
82 | U21 | 1 | EL357N(B)(TA)-G | SOP-4_3.8x4.1mm_P2.54mm | Standard (SOP-4 2.54) | EL357N(B)(TA)-G | EVERLIGHT | C42381015 | 452440 |  | 0.0313 | LOW | Stock fine; 2nd/3rd checked. |  | LTV-357T-B (LITEON) | C33068 | 40510 | EQ | LITEON LTV-357T-B (CTR 130-260 %, same pinout) | EL357B (GOODWORK) | C17702877 | 7680 | EQ | GOODWORK EL357B (CTR B)
83 | Y1 | 1 | X322516MLB4SI | Crystal_SMD_3225-4Pin_3.2x2.5mm | Standard (3225 4-pad) | X322516MLB4SI | YXC Crystal Oscillators | C13738 | 84200 |  | 0.0485 | LOW | Stock fine; 2nd/3rd checked. |  | XL2LI-111-16M (YXC Crystal Oscillators) | C18207610 | 35535 | EQ | YXC XL2LI-111-16M 16 MHz 9 pF 50 ohm | XL2EL89CLI-111YLC-16M (YXC Crystal Oscillators) | C5444547 | 10405 | EQ | YXC XL2EL89CLI-111YLC-16M 16 MHz 9 pF
85 | J1,J2 | 2 | KF2EDGR-5.08-2P (hand-soldered) | PhoenixContact_MSTBA_2,5_2-G-5,08 | De-facto standard (many makers) (5.08 pluggable header) | KF2EDGR-5.08-2P | Cixi Kefa Elec | C441204 | 30830 |  | 0.0246 | LOW | Stock fine; 2nd/3rd checked. |  | 2EDGR-5.08-02P-14-100A(H) (DEGSON) | C699495 | 1720 | EQ | DEGSON 2EDGR-5.08-02P: same 5.08 mm 2-pin right-angle header |  |  |  |  | Mating plug: Kefa KF2EDGK-5.08-2P-AA (C440880), 2 per board
86 | J3,J4 | 2 | PZ254V-11-03P-A40 (hand-soldered) | PinHeader_1x03_P2.54mm_Vertical | Standard (2.54 header) | PZ254V-11-03P-A40 | XFCN | C42419910 | 5250 |  |  | LOW | Stock fine; 2nd/3rd checked. |  | XY-PZ254V-11-03P (XYECONN) | C53200685 | 2050 | EQ | XYECONN XY-PZ254V-11-03P | PZ254V-11-03P-RD (XFCN) | C41425293 | 4080 | EQ | XFCN PZ254V-11-03P-RD (red)
87 | J5 | 1 | PZ254V-11-06P-A40 (hand-soldered) | PinHeader_1x06_P2.54mm_Vertical | Standard (2.54 header) | PZ254V-11-06P-A40 | XFCN | C42419913 | 3800 |  |  | LOW | Stock fine; 2nd/3rd checked. |  | XY-PZ254V-11-06P (XYECONN) | C53200691 | 1180 | EQ | XYECONN XY-PZ254V-11-06P | PZ254V-11-06P-RD (XFCN) | C41425296 | 1580 | EQ | XFCN PZ254V-11-06P-RD (red)
88 | JP1 | 1 | PZ254V-12-04P-A40 (hand-soldered) | PinHeader_2x02_P2.54mm_Vertical | Standard (2.54 header) | PZ254V-12-04P-A40 | XFCN | C45384660 | 1280 |  |  | LOW | Stock fine; 2nd/3rd checked. |  | PZ254V-12-04P-T (XFCN) | C56153598 | 1000 | EQ | XFCN PZ254V-12-04P-T | PZ254V-12-04P-YL (XFCN) | C42393319 | 1980 | EQ | XFCN PZ254V-12-04P-YL

Sheet: Spec check findings
Line | Finding | Result
U12 3rd | YLPTEC ISO7742N0-Y (old 3rd source) is the NARROW SOIC-16 body | Won't fit SOIC-16W. Replaced by ISO7742W0-Y (wide, default-low).
U11 3rd | Maxinmicro MX27524S: pin order could not be confirmed from its datasheet | Dropped. TI UCC27524ADR + UMW UCC27524DR (stated pin-to-pin).
U15/17/18 | TPV331S5 / HT331 are push-pull clones with unconfirmed pinout | Replaced by 3PEAK LMV331X-S5TR and ST LMV331ILT (open-drain, same pinout).
U16/U22 | TL431 SOT-23 pinout differs between makers. Board: pin1 = cathode, pin2 = REF (TI DBZ) | U22 must use a 1=K / 2=REF part: TI, UMW, Nexperia normal pinning, HGSEMI. MSKSEMI (no pin numbers) dropped. U16 has pins 1+2 tied so any TL431 works.
TH1 | FH CMFB103F3950FANT (old 2nd) is 0805 | Won't fit the 0603 pads. Replaced by two 0603 10k 1 % B3950 parts.
CR1-CR6 | CCTC / HRE 'M3L' 100 nF 1206 caps show no dielectric - not confirmed C0G | Resonant caps need C0G. Replaced by Murata GRM31C5C2A104JA01L / TDK C3216C0G2A104JT000E.
L1 | SOREDE SRYH.1770 (old 3rd) saturates at 16 A vs 23 A design | Dropped. Shun Xiang Nuo SMMS1770-220M and Sunltech SLO1770C (both 23 A sat). Sunltech land checked: fits.
L2/L3 | APV ANR5040 has no datasheet on LCSC | New primary cjiang FNR5040S470MT: recommended land 1.4 x 4.2 / gap 2.3 = our footprint exactly.
RS1 | Alloy shunt land pattern vs standard R_2512 footprint | HoJLR2512 terminations 0.9 mm sit fully on our pads (2.35-3.58 mm from centre). OK.
SW1 | SHOU HAN TPGT land: 1.1 x 2.2 mm pads, rows 6.6 / 11 mm | Matches our footprint (1.12 x 2.44, rows 6.16 / 10.74).
Q1/Q4 | NCE alternates have Qg 54-60 nC vs 26 nC | Pin-compatible DFN5x6; usable but more switching loss in the hard-switched FETs - bench check.
Q2/3/5/6 | NCEP068N10G Qg 60 nC vs 65 nC, 6.1 mOhm | Drop-in (better Rds).
U4/U13 | LV2862: same pinout and FB; EN threshold 1.25 V vs ~1.5 V | U13 under-voltage start moves from ~12 V to ~10 V VIN. Acceptable; note it.
U9 | No pin-compatible integrated-power isolated CAN from another maker | ISO1042DW matches pins 2-16; needs pin 1 = 3.3 V + external isolated 5 V. See 'PCB reserve'.
T2 | Pulse only; PA3855.005NLT same EP13 footprint | Needs series secondaries. See 'PCB reserve'.
C82 | BOM had X7R on the ramp cap | KEMET C0G 47 nF (25 V, node < 5 V).

Sheet: PCB reserve
Part | Why | What to add (DNP on the normal build) | Space | Where | Status
T2 PA3855.006NLT | Single maker (Pulse), 102 pcs at LCSC | 3 x 0805 0R jumpers on the secondary: A = pin10->FLY_SA, B = pin6->GND, C = pin6->pin10. Normal (.006): fit A+B. Backup (.005NLT, secondaries in series): fit C only. | ~6 x 4 mm | Free 10 x 8 mm area right of T2 pins 6-10 (x 79.5-89.5, y 46-54) | Waiting for your OK
U9 CA-IS3062VW | Single maker (Chipanalog), integrated isolated DC-DC | 1 x 0402 0R to select U9 pin 1 = +5V (CA-IS3062) or +3V3 (ISO1042DW); B0505S-1WR3 isolated 5 V SIP-4 module + 2 caps feeding VISO. | ~14 x 10 mm + one 0402 | Free area straddling the isolation gap directly above U9 (x 128-142, y 64-74) | Waiting for your OK (module pin spacing vs 4 mm gap to confirm)
