shousei01/dcdc_converter/01_hardware/docs/T1_PQ2620_winding_guide.html

# T1 — PQ2620 LLC transformer, hand-winding guide

DCDC LLC + 4SBB, Rev D · Np = 4 : Ns = 8 + 8 (centre tap) · Lm 50 µH · leakage ≈ 1 µH (this is the resonant inductor Lr) · basic insulation 3 kVrms

The two things that must be right: (1) the turn counts 4 / 8 / 8, and (2) the centre tap joins the finish of S1 to the start of S2 (series-aiding). Get that wrong and the two secondary halves cancel and VBUS does not come up. Primary-to-secondary polarity only decides which SR fires first (firmware). Section 7 tells you how to check both with a function generator before soldering.

## 1. Specification

Item | Value | Notes
Core | PQ2620 pair, TDK N97 / PC95 or equivalent | Ae ≈ 119 mm², Bpk 63 mT at 48 V in — far from saturation
Bobbin | PQ2620 vertical 6 + 6 (vendor drawing): pins Ø0.70 mm, 3.8 mm pitch, 7.5 mm between pin 3 and 4, 25.4 mm row to row, base 27 × 29 mm, height 20.8 mm | Winding width 9.5 mm between flanges, tube Ø14.1 mm, flange Ø20.8 mm → ≈ 3.3 mm radial build available. Primary row and secondary row on opposite sides (isolation)
P Primary | 4 turns, copper foil 0.15 mm × 8 mm (1.2 mm²), 25 µm polyimide between turns. Wire fallback: litz 0.1 mm × 100 (Ø ≈ 1.5 mm) | 10.1 A rms worst case (12 V in, full power). One foil stack ≈ 0.7 mm thick. Start pins 1-2-3, finish 4-5-6. Litz Ø2 mm (0.1 × 200) does not fit together with the secondary – see §1b
S1 Secondary half A | 8 turns, TIW (triple-insulated) 0.65 mm conductor (OD ≈ 0.85 mm) | Start = pins 11-12 (SR_D2, dot), finish = centre tap pins 9-10
S2 Secondary half B | 8 turns, same TIW | Start = centre tap pins 9-10 (dot), finish = pins 7-8 (SR_D1)
Winding method | S1 and S2 wound bifilar (two wires in hand), 2 layers × 4 turns (8 wires per layer = 6.8 mm of the 9.5 mm width) | Bifilar keeps both halves identical → equal SR currents
Direction | All windings the same direction (clockwise seen from the top of the bobbin) | Dots = start of each winding
Lm (primary, secondaries open) | 50 µH ± 10 % @ 100 kHz, 1 V | AL ≈ 3.1 µH/T² → small centre gap, ≈ 0.05 mm total (see §6)
Llk (primary, both secondaries shorted) | 1.0 µH, 0.7-1.4 µH usable | With Cr = 600 nF: fr = 1/(2π√(Llk·Cr)) → 245-170 kHz. Firmware runs at the measured fr
Ratio check | V(S1+S2) / V(P) = 4.0, each half 2.0 | VBUS ≈ VIN (half-bridge puts VIN/2 on the primary)
Hipot | 3 kVrms 60 s, primary pins ↔ secondary pins | TIW carries the insulation; tape between layers is mechanical

## 1b. Does it fit? (vendor bobbin, radial build ≤ 3.3 mm)

Layer (inside → out) | Option A – foil primary (recommended) | Option B – all wire | Litz 0.1 × 200 (first guess)
Primary 4 T | foil 0.15 × 8 mm + film: 0.70 mm | litz 0.1 × 100, Ø 1.5: 1.50 mm | litz Ø 2.0: 2.00 mm
Tape P → S | 0.05 mm | 0.05 mm | 0.05 mm
Secondary 2 layers bifilar | TIW 0.65 (OD 0.85): 1.70 mm | TIW 0.55 (OD 0.75): 1.50 mm | TIW 0.65: 1.70 mm
Tape between / outer | 0.05 + 0.10 mm | 0.05 + 0.10 mm | 0.05 + 0.10 mm
Total vs 3.3 mm | 2.6 mm – fits | 3.2 mm – just fits, wind tight | 3.9 mm – does not fit
Current density @ 12 V in, full load | P 8.4 A/mm², S 10.7 A/mm² | P 12.9 A/mm², S 15 A/mm² (OK for bench tests at ≥ 24 V in) | –

Winding width 9.5 mm: 4 foil turns are a stack (8 mm wide foil leaves 0.75 mm creepage each side); 4 litz turns Ø 1.5 = 6 mm; 8 TIW per layer × 0.85 = 6.8 mm. Leakage changes with the build: measure Llk and set fr in firmware from the measured value (§7). An extra tape layer between P and S raises Llk if it comes out low.

## 2. Electrical diagram with dots and pin numbers

## 3. Bobbin pin map — top view (as on the PCB footprint)

Pin | Wire end | PCB net
1, 2, 3 | P start ● (split litz over 3 pins) | HB_SW (Q5/Q6)
4, 5, 6 | P finish | CR_MID (resonant caps)
11, 12 | S1 start ● | SR_D2 (Q8 drain)
9, 10 | S1 finish + S2 start ● | VBUS (centre tap)
7, 8 | S2 finish | SR_D1 (Q7 drain)

Positions 1-12 are this guide's numbering, seen from the top (component side), matching the T1 footprint: position 1 is next to the silkscreen dot, primary row ("PRI") left → right 1-6, secondary row ("SEC") left → right 7-12. In the KiCad footprint the pads are named by net group: 1-3 = pad "1", 4-6 = pad "2", 7-8 = pad "3", 9-10 = pad "4", 11-12 = pad "5". Mark pin 1 on the bobbin with a pen before you start; if your bobbin's moulded numbers differ, go by position, not by the moulded number.

On the PCB T1 is turned 90°: the primary row is the left column and pin 1 (square pad + dot) is its bottom end; the secondary row is the right column. The drawing above is the footprint itself (pins down, seen from the top); rotate it a quarter turn counter-clockwise to match the board.

Use both pins of each pair (solder the wire to one, bridge to the other) — each secondary end carries up to 3.6 A rms.

## 4. Cross-section — winding build-up

PrimaryS1S2TapeCore

## 5. 3D view (drag to rotate, scroll to zoom)

P 4 TS1 8 TS2 8 T● start (dot)pin 1 · core hidden for clarity (toggle below)

show core

## 6. Winding procedure

1. Prepare. Mark pin 1 on the bobbin. Decide the winding direction: hold the bobbin with the pins pointing down and look from the top — every winding goes clockwise.
2. Primary (4 T). Foil: cut 0.15 × 8 mm copper foil, solder a short tinned wire tab (or a strip of litz) across the start end and take it to pin 1 (bridge 1-2-3). Lay a 25 µm polyimide strip on the foil so turns are insulated from each other, wind 4 turns clockwise, centred in the 9.5 mm width, then a finish tab to pin 4 (bridge 4-5-6). Round off the foil corners so they cannot cut the tape. Litz (option B): start on pin 1, 4 turns clockwise in one layer, finish to pin 4. Count each time the conductor passes the pin-1 side.
3. Tape. One layer of polyimide (Kapton) tape over the primary.
4. Secondary (bifilar 8 T). Take two TIW wires together, mark one S1 (e.g. a red sleeve) and the other S2. Solder the start of S1 to pin 11 (bridge 12) and the start of S2 to pin 9 (bridge 10). Wind both together clockwise, 4 turns per layer, 2 layers = 8 turns. Tape between the two layers.
5. Finish the secondary. S1 finish → pin 10 (centre tap, joins S2's start). S2 finish → pin 7 (bridge 8). The pins on the centre tap now carry S1-finish + S2-start: that is the series-aiding joint.
6. Outer tape 2 layers. Keep leads on the primary side away from the secondary side (TIW leads may cross the bobbin flange; plain litz must not touch secondary pins).
7. Gap and core. Insert the core halves with a 0.025 mm polyimide spacer under each outer leg (≈ 0.05 mm total centre gap equivalent), or use a pre-gapped half. Clamp, measure Lm (step 7), adjust the spacer until Lm = 45-55 µH. Then glue or clip the core.

## 7. Checks before soldering T1 to the board

Check | How | Pass
Turns / ratio | Function generator 100 kHz, 1-2 Vpp sine on pins 1 → 4. Measure V(11 → 7) with a scope or AC meter. | 4.0 × V(1-4) (each half 2.0 ×). 2× → one half missing; ≈ 0 → halves opposing (centre-tap wrong)
Centre-tap polarity | Same signal. Scope ground on pin 9 (CT). CH1 on pin 11, CH2 on pin 7. | CH1 and CH2 opposite phase, equal amplitude (2× input)
Primary-to-secondary dot | Ground pin 4 and pin 9 together (bench only, not on the board). CH1 = pin 1, CH2 = pin 11. | CH1 and CH2 in phase. If inverted: swap SR1_PWM / SR2_PWM timing in firmware, or rewind the primary the other way
Lm | LCR meter 100 kHz on pins 1-4, secondaries open | 50 µH ± 10 %
Leakage (Lr) | LCR meter on pins 1-4 with pins 7, 9, 11 all shorted together | ≈ 1.0 µH (0.7-1.4 µH OK). Note the value: fr = 1/(2π√(Llk × 600 nF))
DCR | Milliohm meter | P ≈ 3-6 mΩ, each S half ≈ 15-30 mΩ, S halves within 10 % of each other
Insulation | Hipot pins 1-6 ↔ 7-12 | 3 kVrms 60 s (or 4.2 kV DC), no breakdown

Why the dot matters for firmware: with the dots as drawn, when Q5 (high side, HRTIM CHC1 = LLC_A) is on, pin 11 swings up and pin 7 (SR_D1) is pulled to ground — so Q7 (CHD1 = SR1_PWM) conducts together with CHC1, and Q8 (CHD2) together with CHC2. The SRs start on their body diodes, so a wrong primary dot is safe at power-up; just don't enable SR_EN until the timing is confirmed.

## 8. Materials

Item | Suggestion
Core | PQ26/20 pair, N97 / PC95 / 3C95 (ungapped + spacer, or one half gapped for AL ≈ 3150 nH)
Bobbin | PQ2620 vertical 6 + 6 (your vendor drawing). PCB footprint takes it and the PQ2625 6 + 6 (25.5 mm rows, Ø0.80 mm pins, 29.8 × 26.7 mm base, 25.3 mm high): Ø1.2 mm holes, same 3.8 / 7.5 mm pin pattern
Primary | Copper foil 0.15 mm × 8 mm, ≈ 0.4 m (+ 25 µm polyimide film 9 mm wide), or litz 0.1 mm × 100, ≈ 0.4 m
Secondary wire | TIW 0.65 mm conductor (OD ≈ 0.85 mm, Furukawa TEX-E or similar), ≈ 1.2 m per half, 2.5 m total; option B: TIW 0.55 mm
Tape | Polyimide (Kapton) 10 mm wide, 25 µm spacer film for the gap

Bobbin from the vendor drawing: winding width 9.5 mm, radial space ≈ 3.3 mm (tube Ø14.1 to flange Ø20.8). See §1b for the build-up check. Height with core and clip ≈ 21-22 mm above the board.
