shousei01/dcdc_converter/03_calculations/llc_results.txt

fr = 195.9 kHz, Z0 = 1.23 ohm, Lm/Lr = 50, n = 2.0
ZVS: Lm max for td 150 ns = 94 uH (chosen 50 uH)
vin	worst_out	pbus	ibus	ipri_rms	ipri_pk	isr_rms	im_pk	p_pri	p_sr	p_xfmr	p_core	loss_llc	eta_llc	loss_4sbb	loss_total	eta_total	bpk_mT	vcr_pk	vsr_max	zvs
12	48V/1.04A	53.6	4.54	10.08	14.4	3.56	0.15	1.21	0.57	1.07	0.01	3.91	0.9321	3.62	7.53	0.8692	16	23.2	23.6	True
18	10V/5.0A	53.1	3.0	6.66	9.6	2.35	0.23	0.54	0.25	0.48	0.02	2.03	0.9632	3.12	5.15	0.9066	24	20.3	35.5	True
24	10V/5.0A	53.2	2.25	5.0	7.4	1.77	0.3	0.31	0.14	0.3	0.03	1.42	0.974	3.2	4.62	0.9154	32	20.5	47.3	True
36	10V/5.0A	53.4	1.51	3.36	5.2	1.18	0.45	0.17	0.06	0.21	0.1	1.04	0.9808	3.43	4.47	0.9179	47	23.7	70.9	True
48	10V/5.0A	53.7	1.14	2.55	4.2	0.89	0.6	0.13	0.04	0.27	0.2	1.02	0.9814	3.67	4.69	0.9143	63	28.3	94.6	True
