shousei01/dcdc_converter/01_hardware/docs/DCDC_LLC_4SBB_G474_schematic.pdf

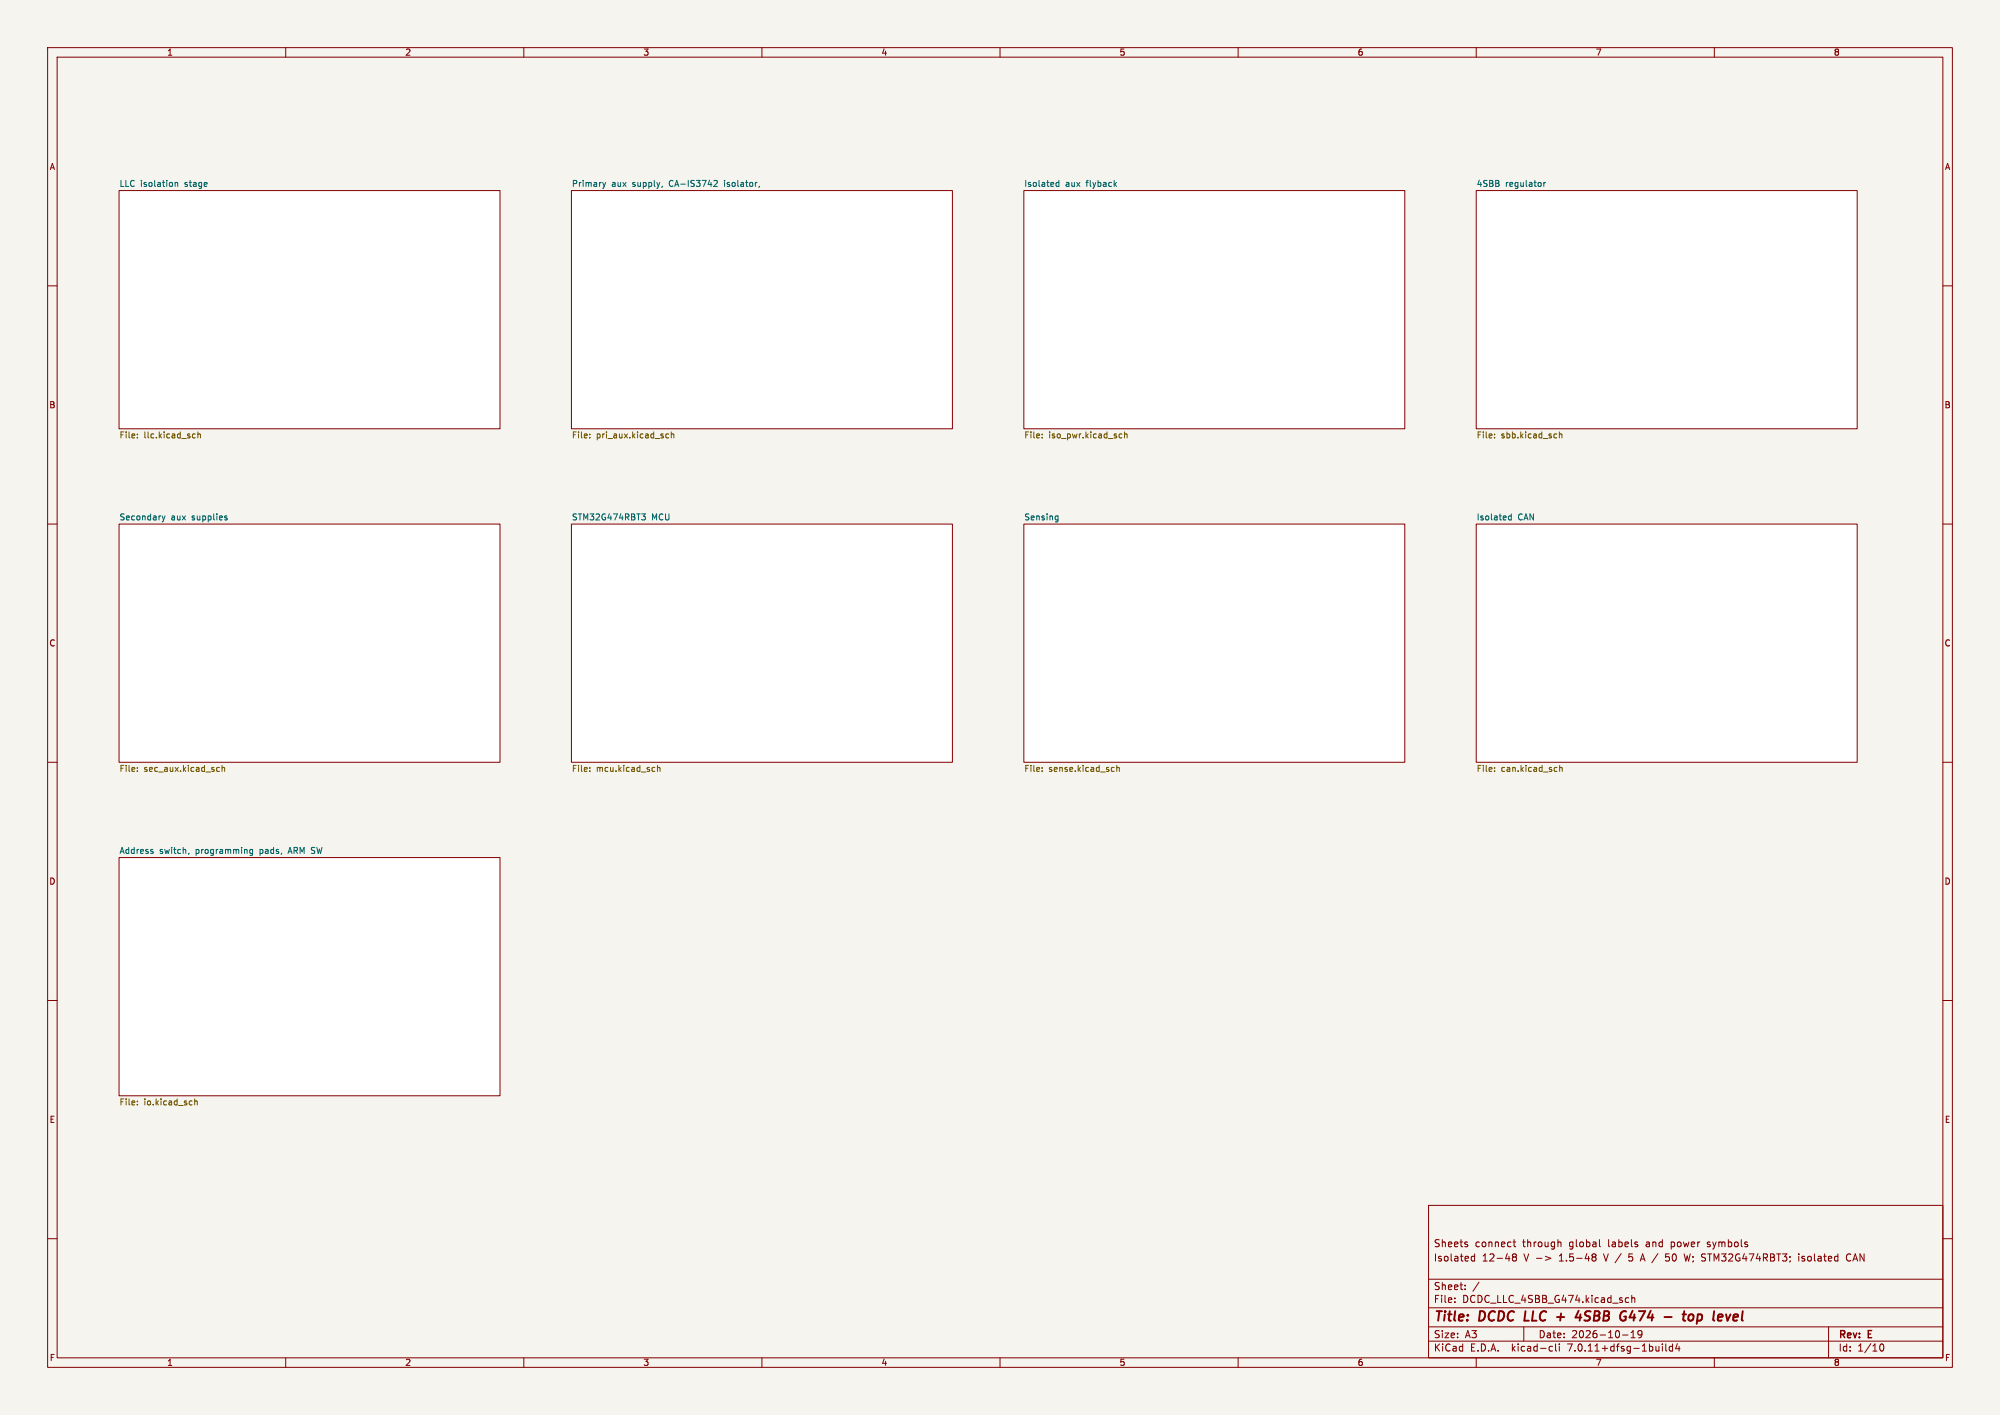
[picture p2: page 1]

4SBB regulator File: sbb.kicad_sch Sensing File: sense.kicad_sch

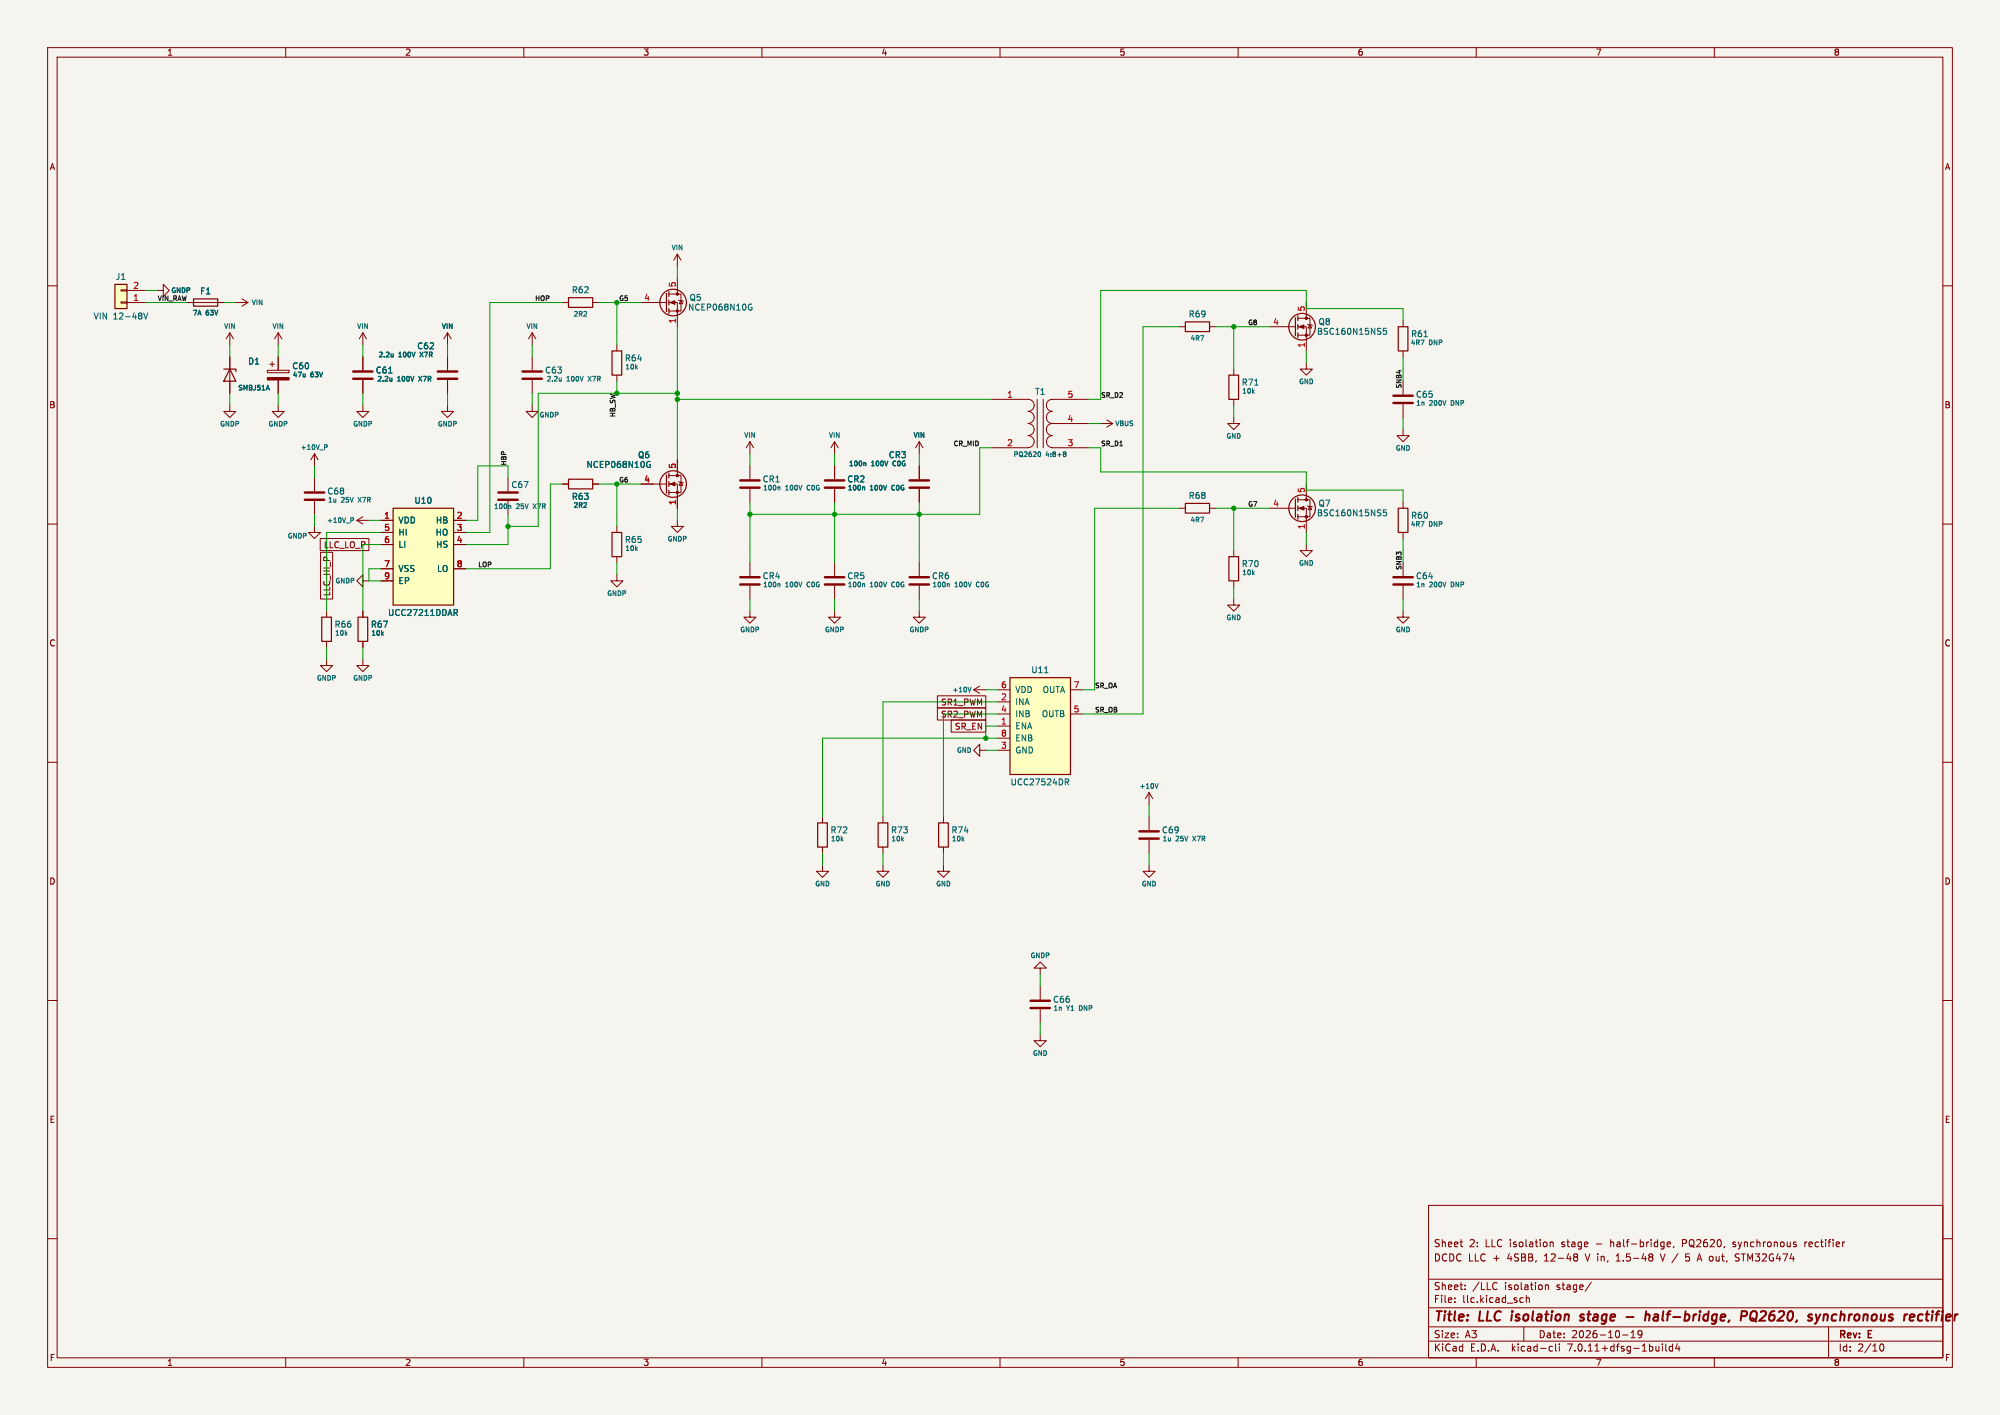
[picture p3: page 2]

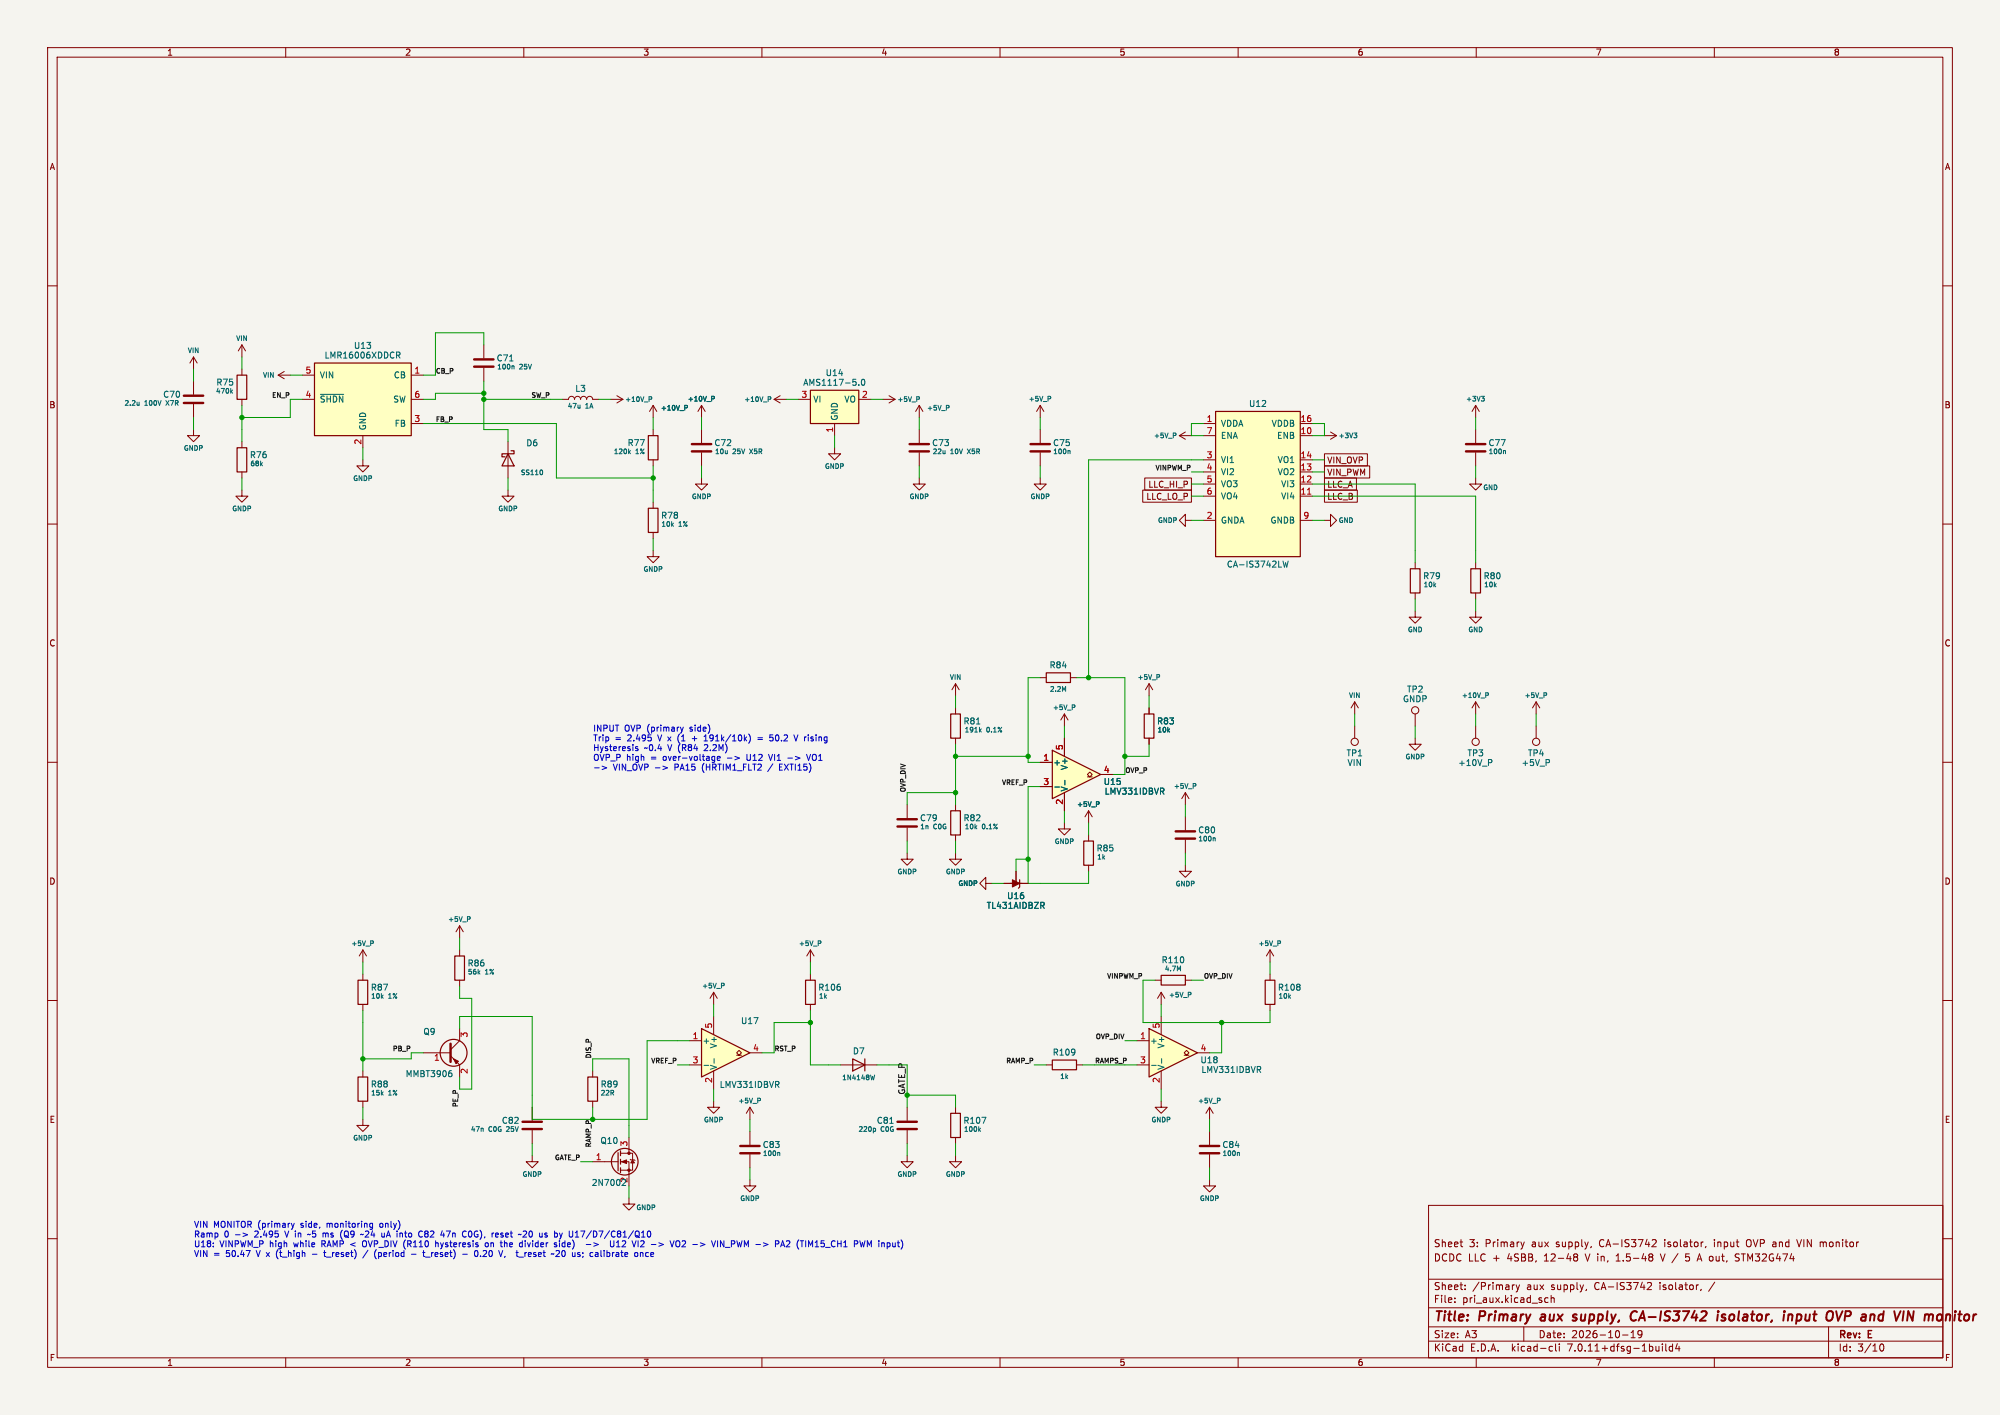
[picture p4: page 3]

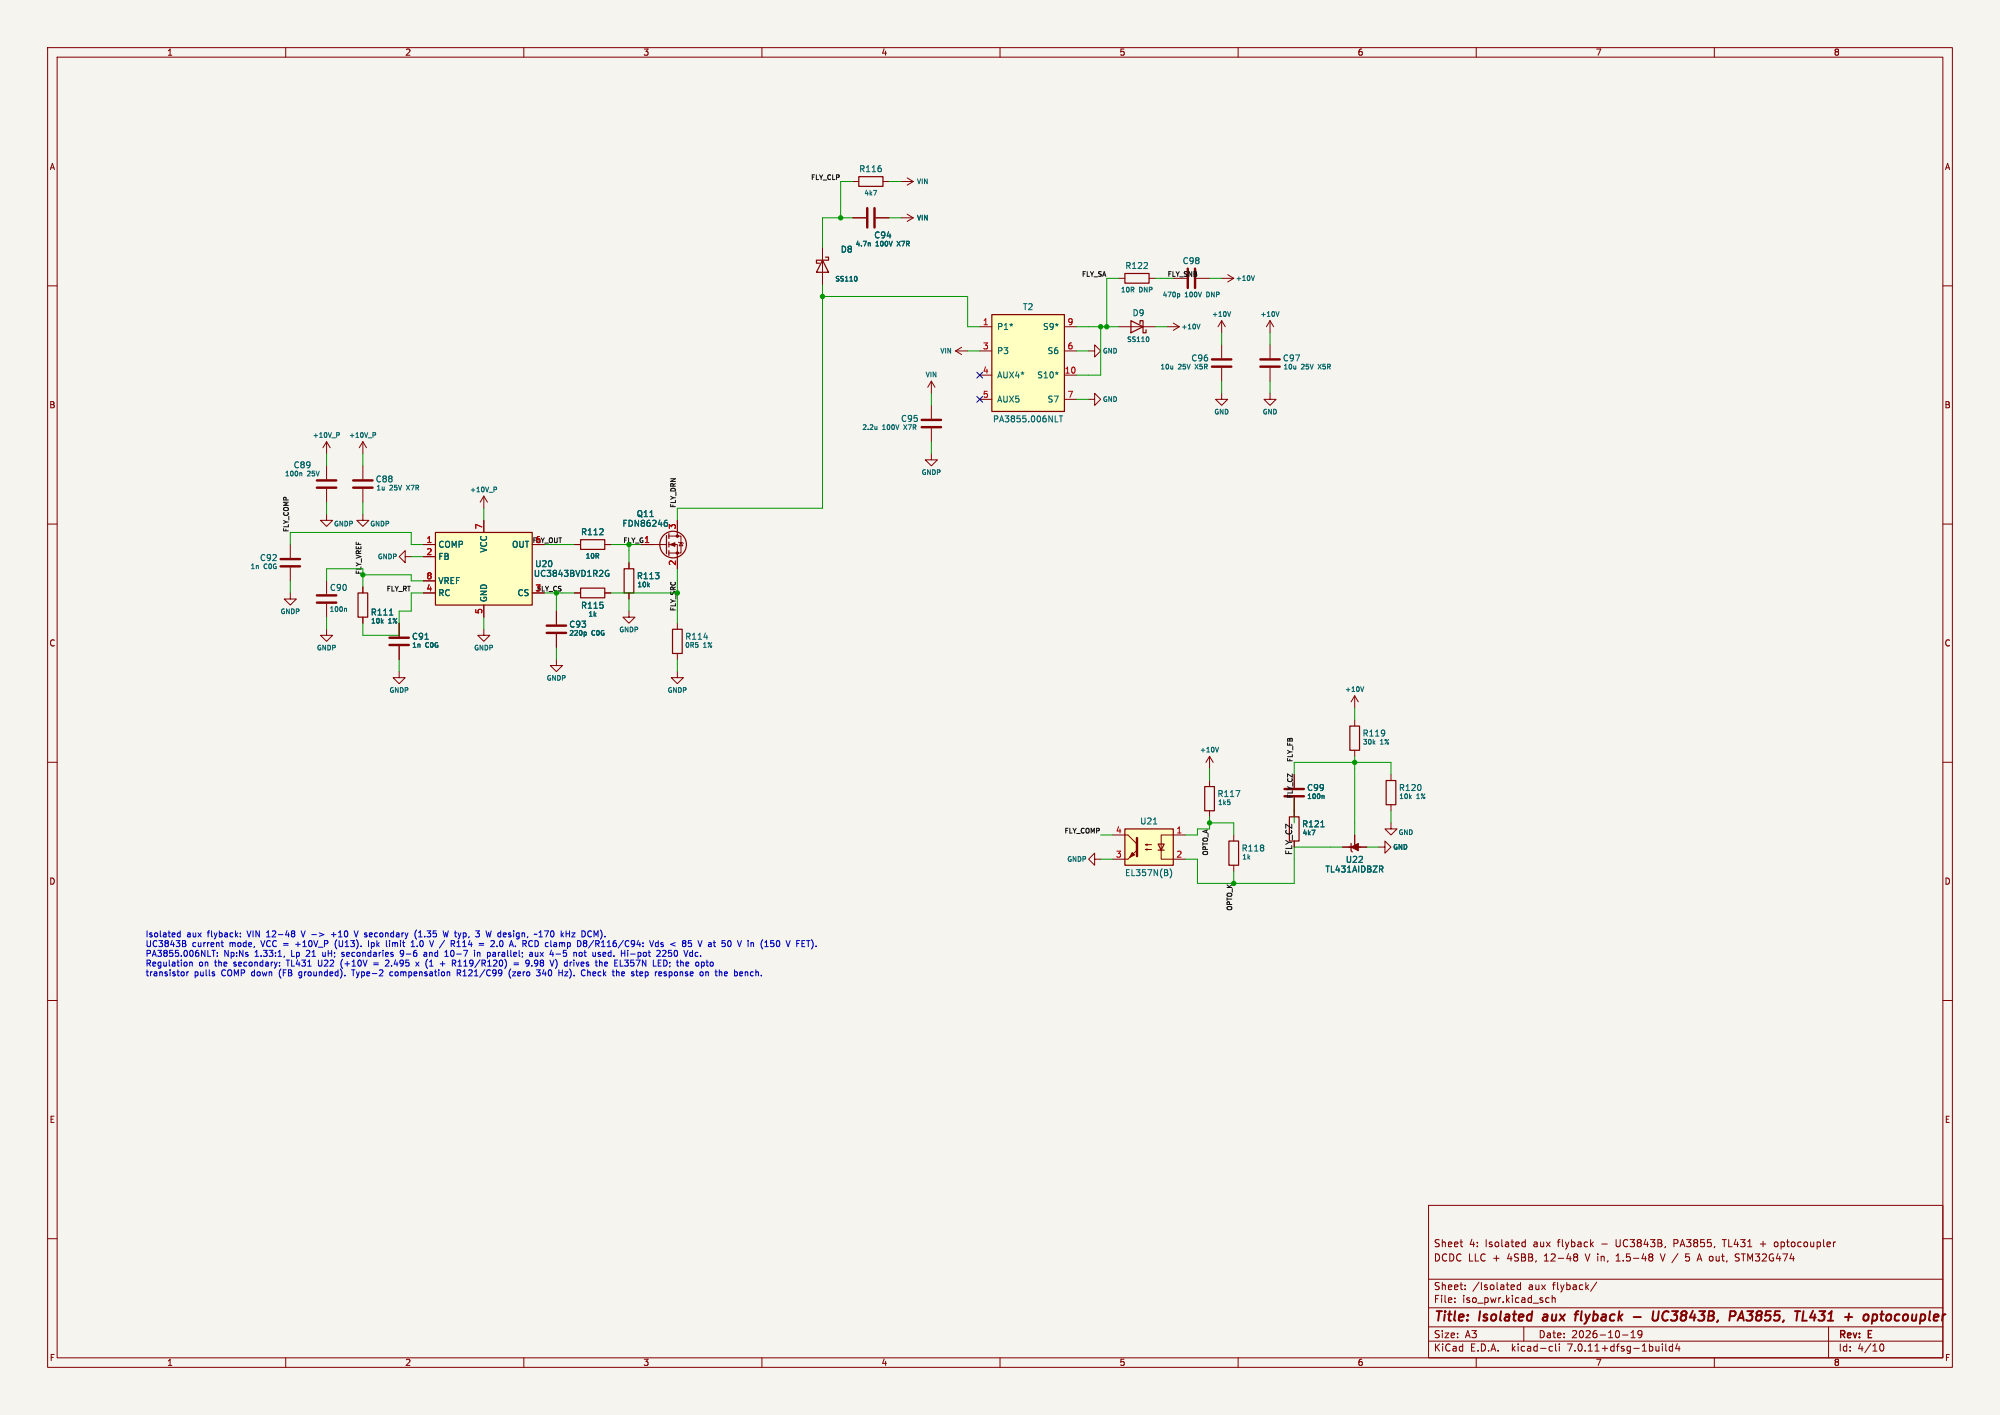
[picture p5: page 4]

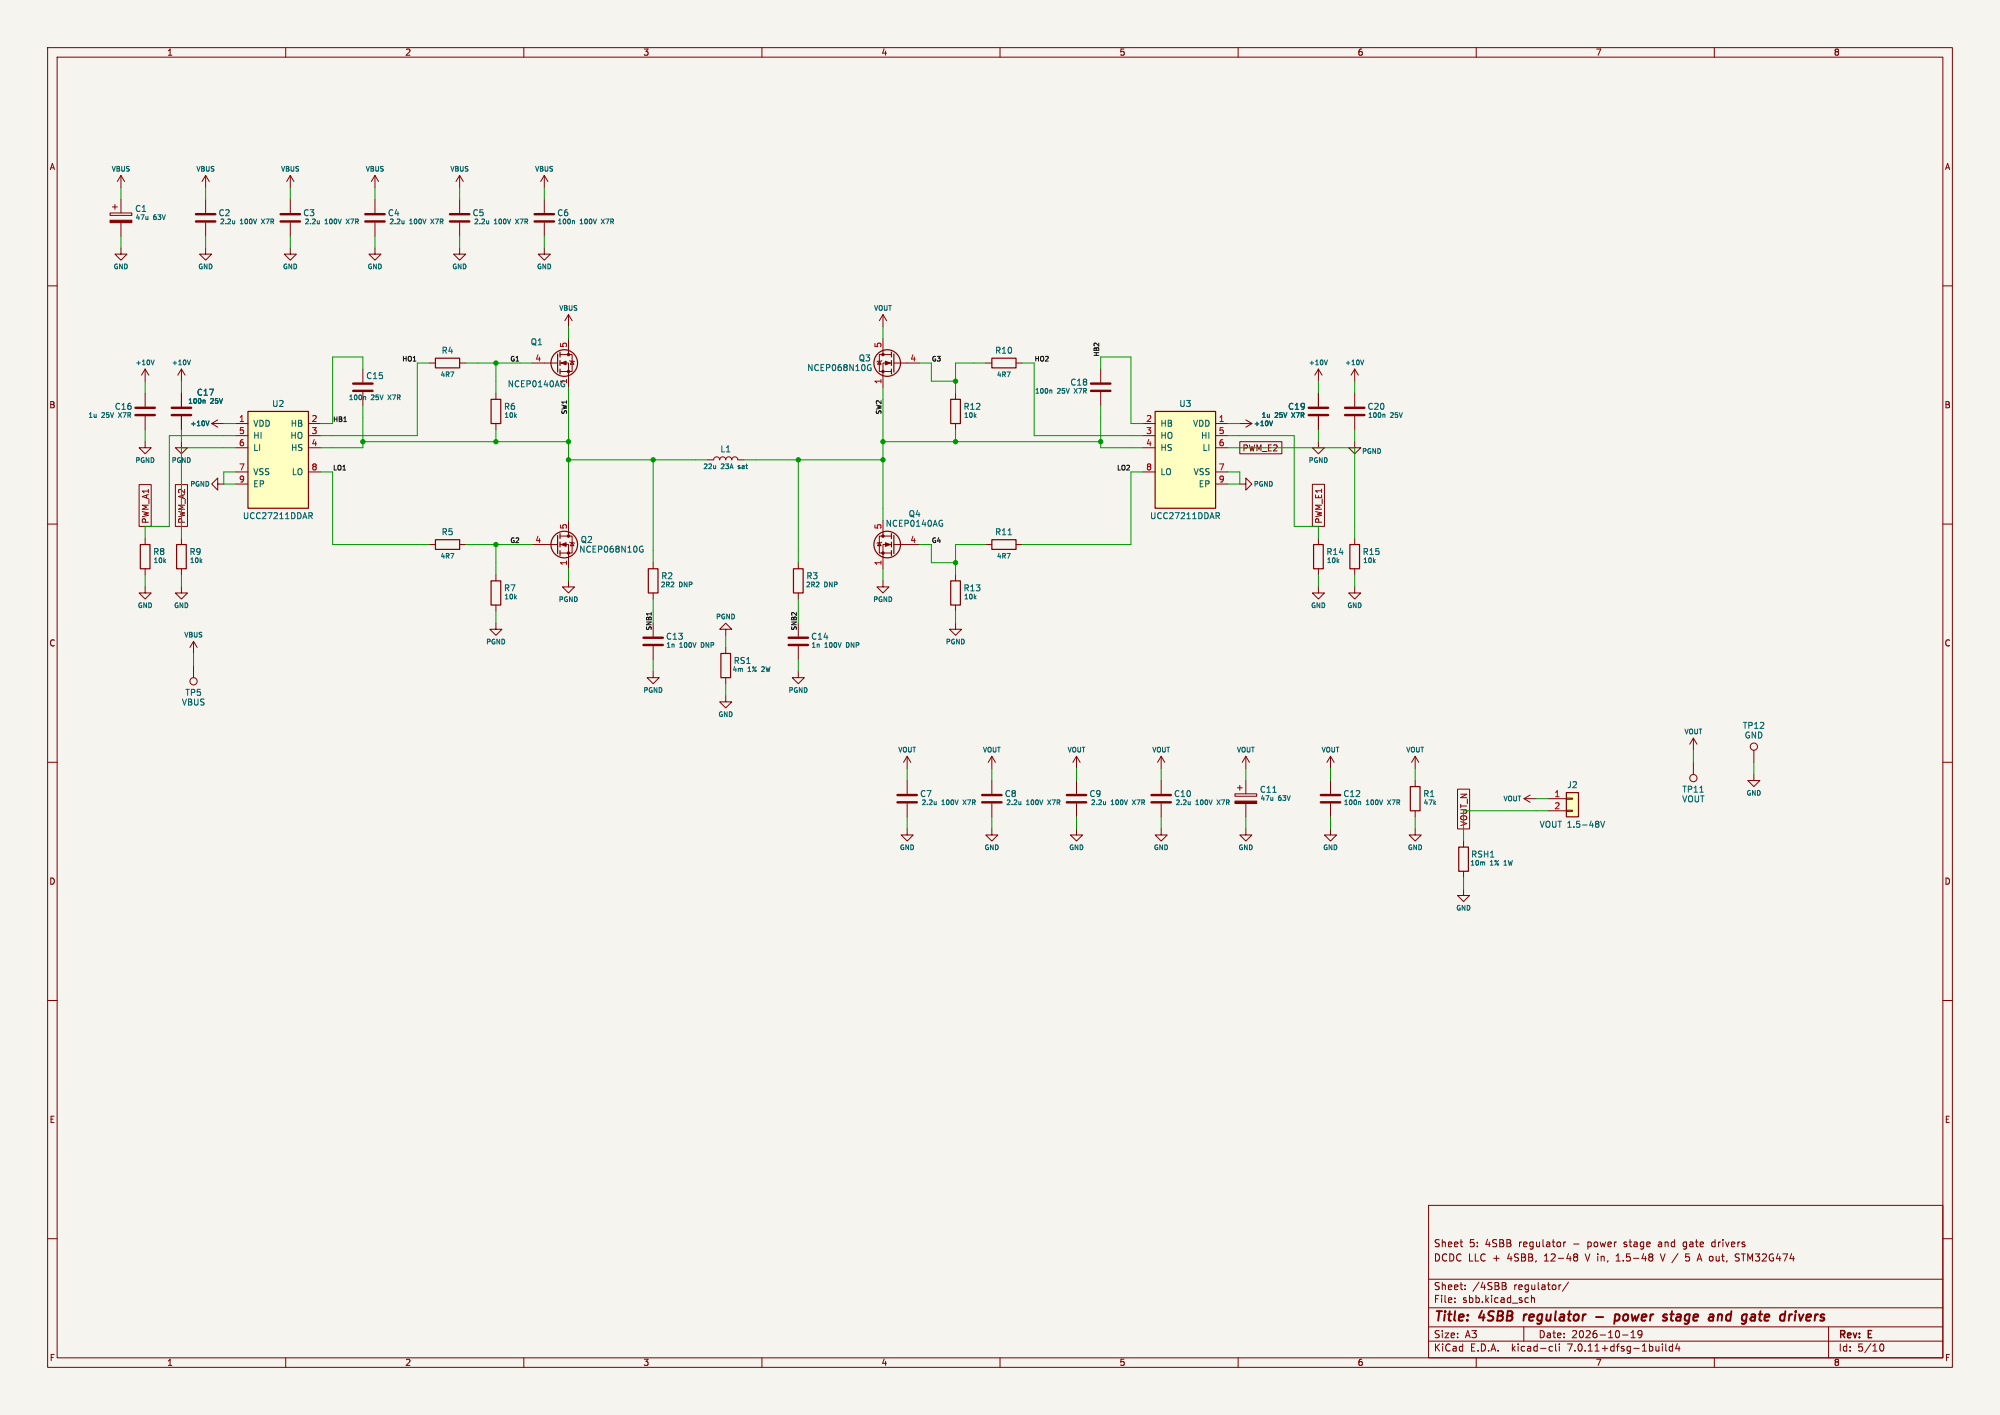
[picture p6: page 5]

Id: 5/10 Title: 4SBB regulator - power stage and gate drivers

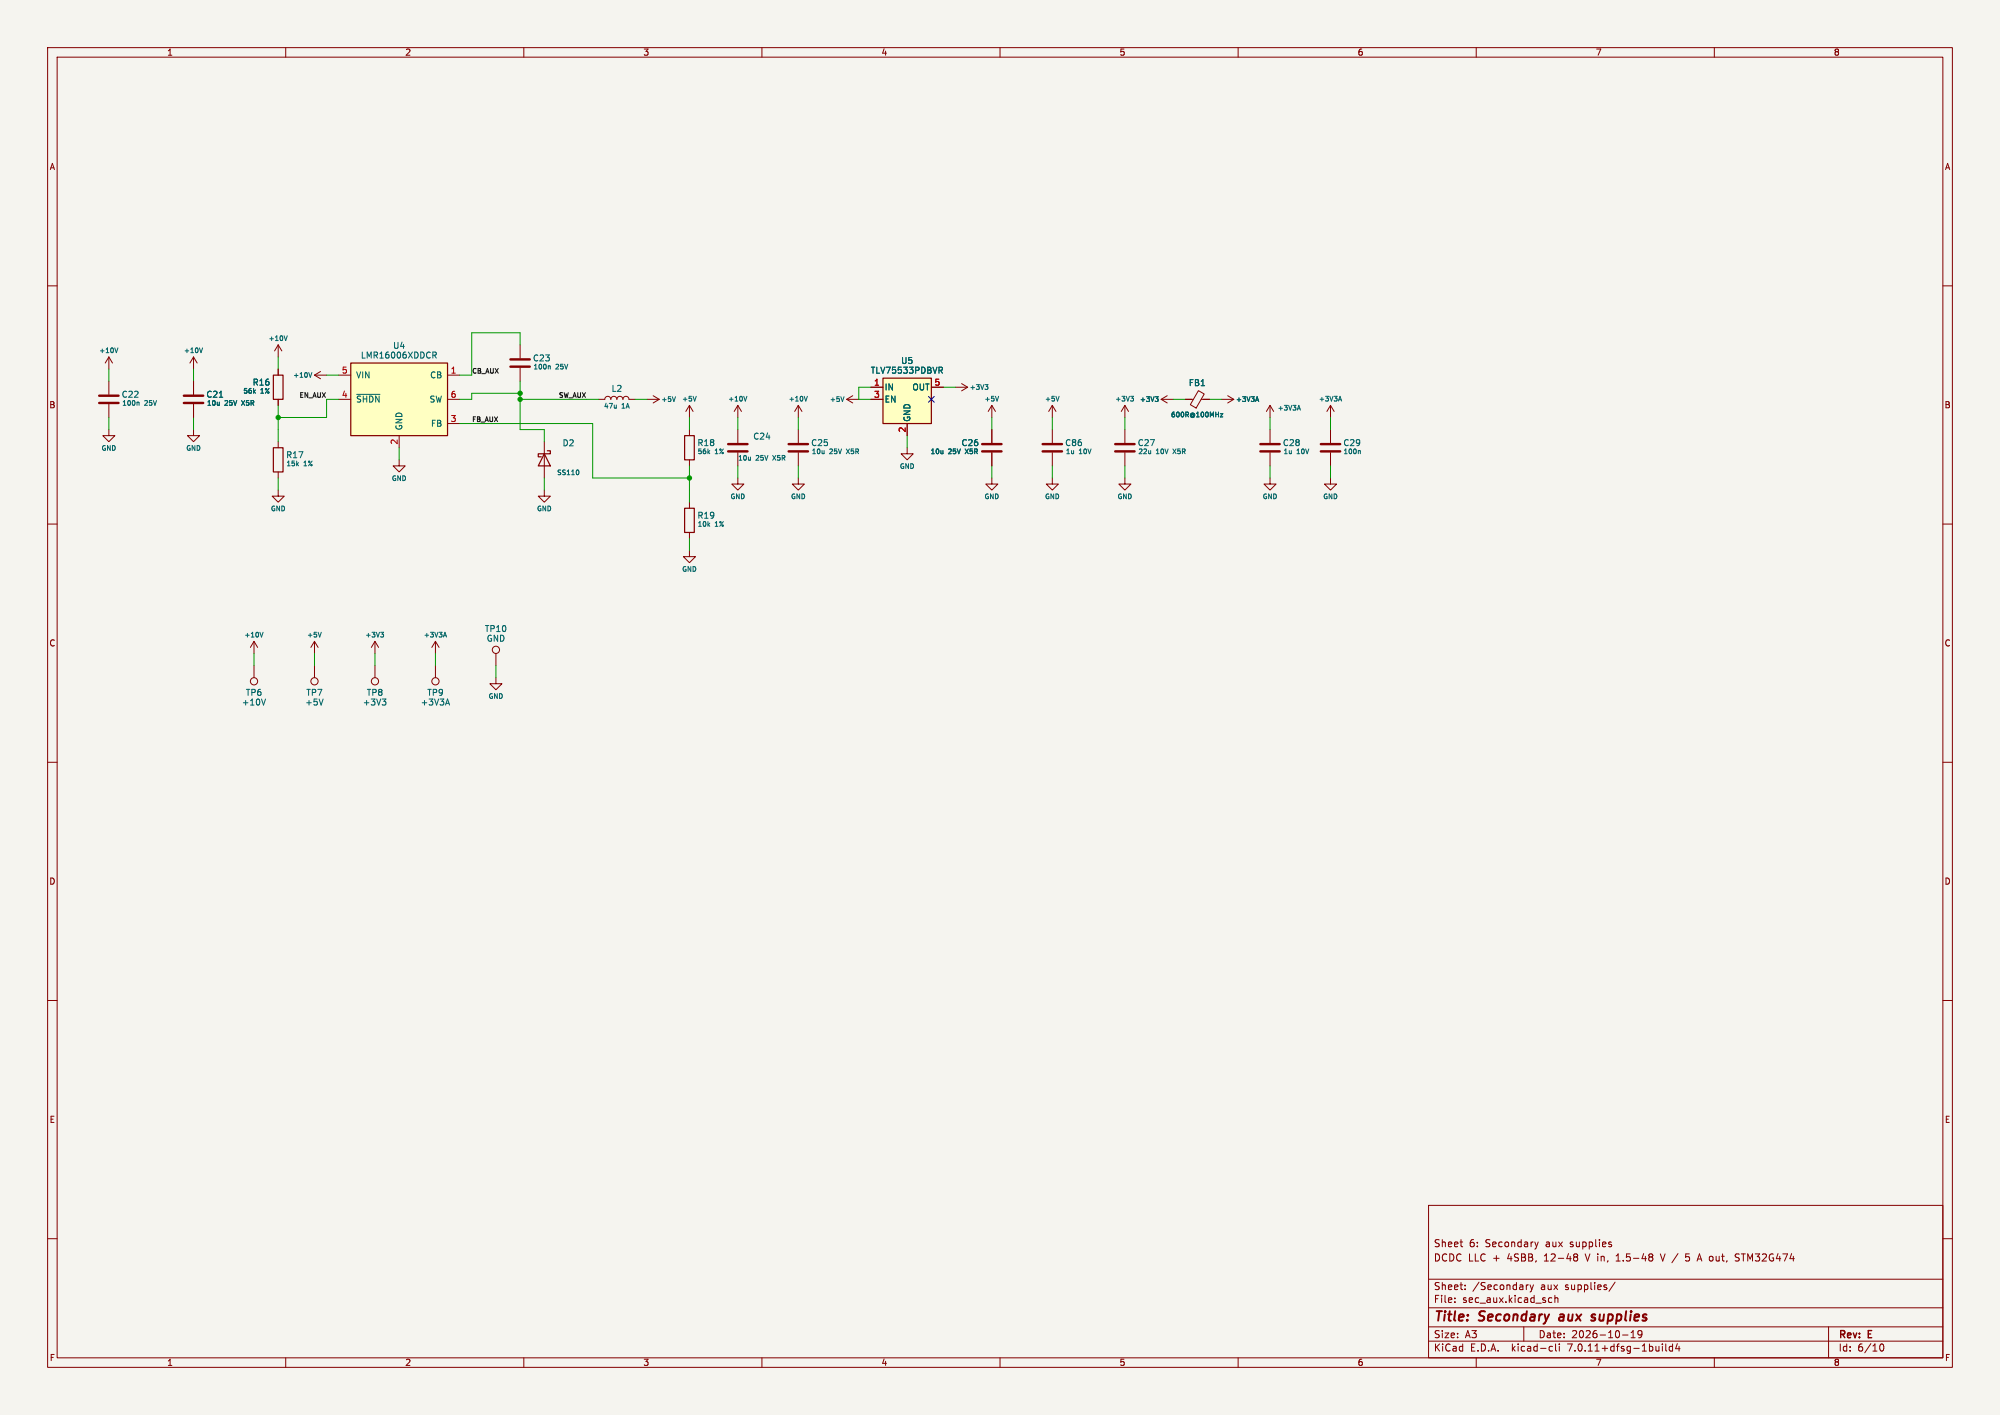
[picture p7: page 6]

2 FB 3 ~{SHDN} 4 VIN 5 SW 6 U4
LMR16006XDDCR

Id: 6/10 Title: Secondary aux supplies

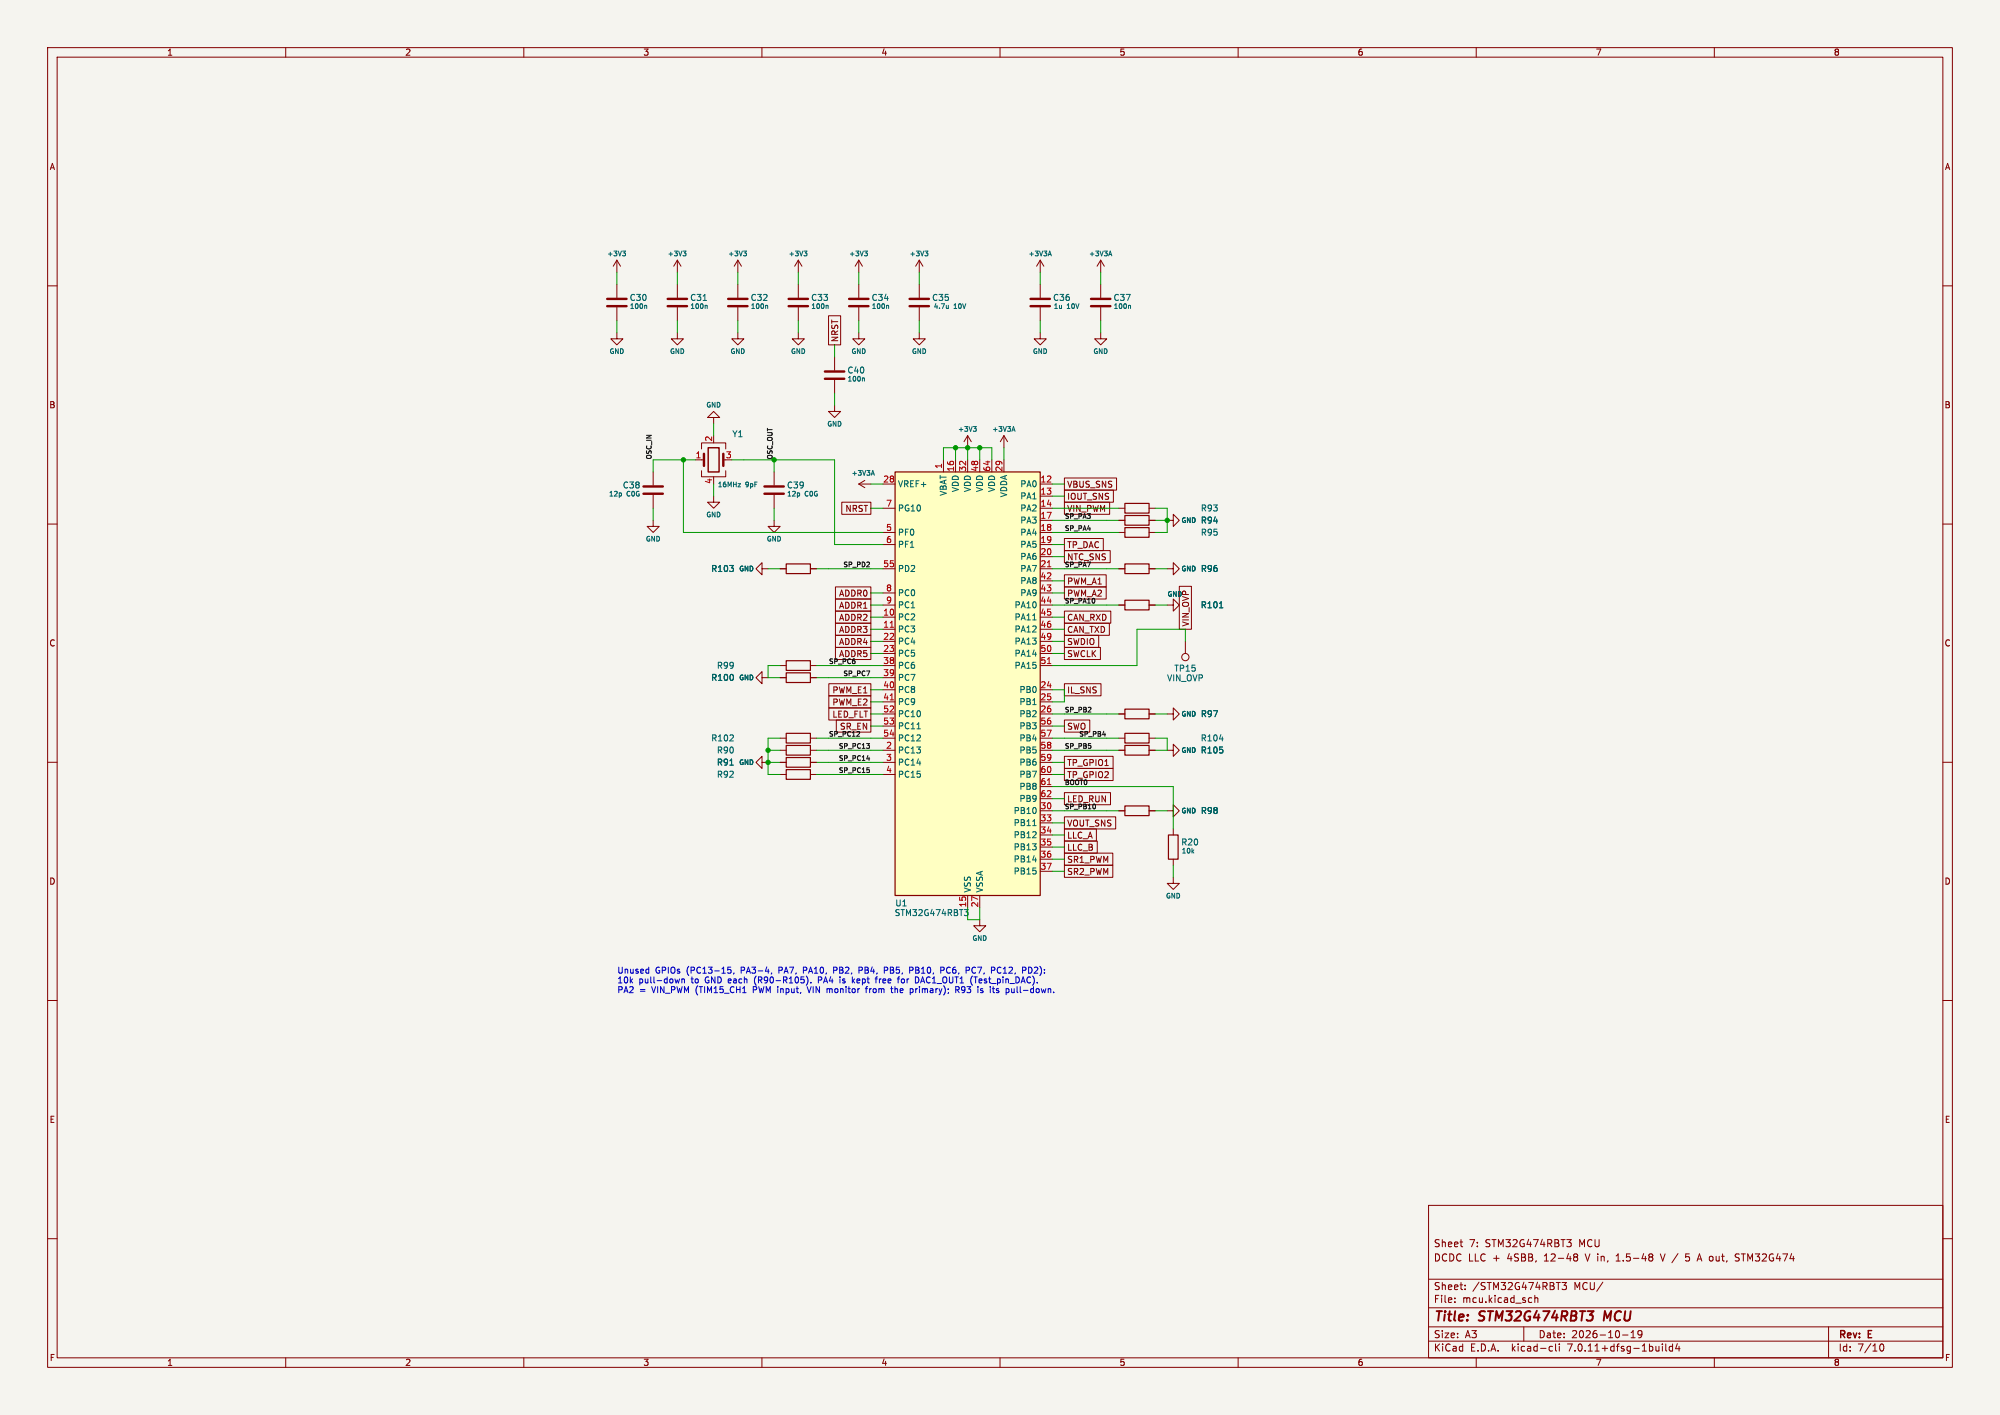
[picture p8: page 7]

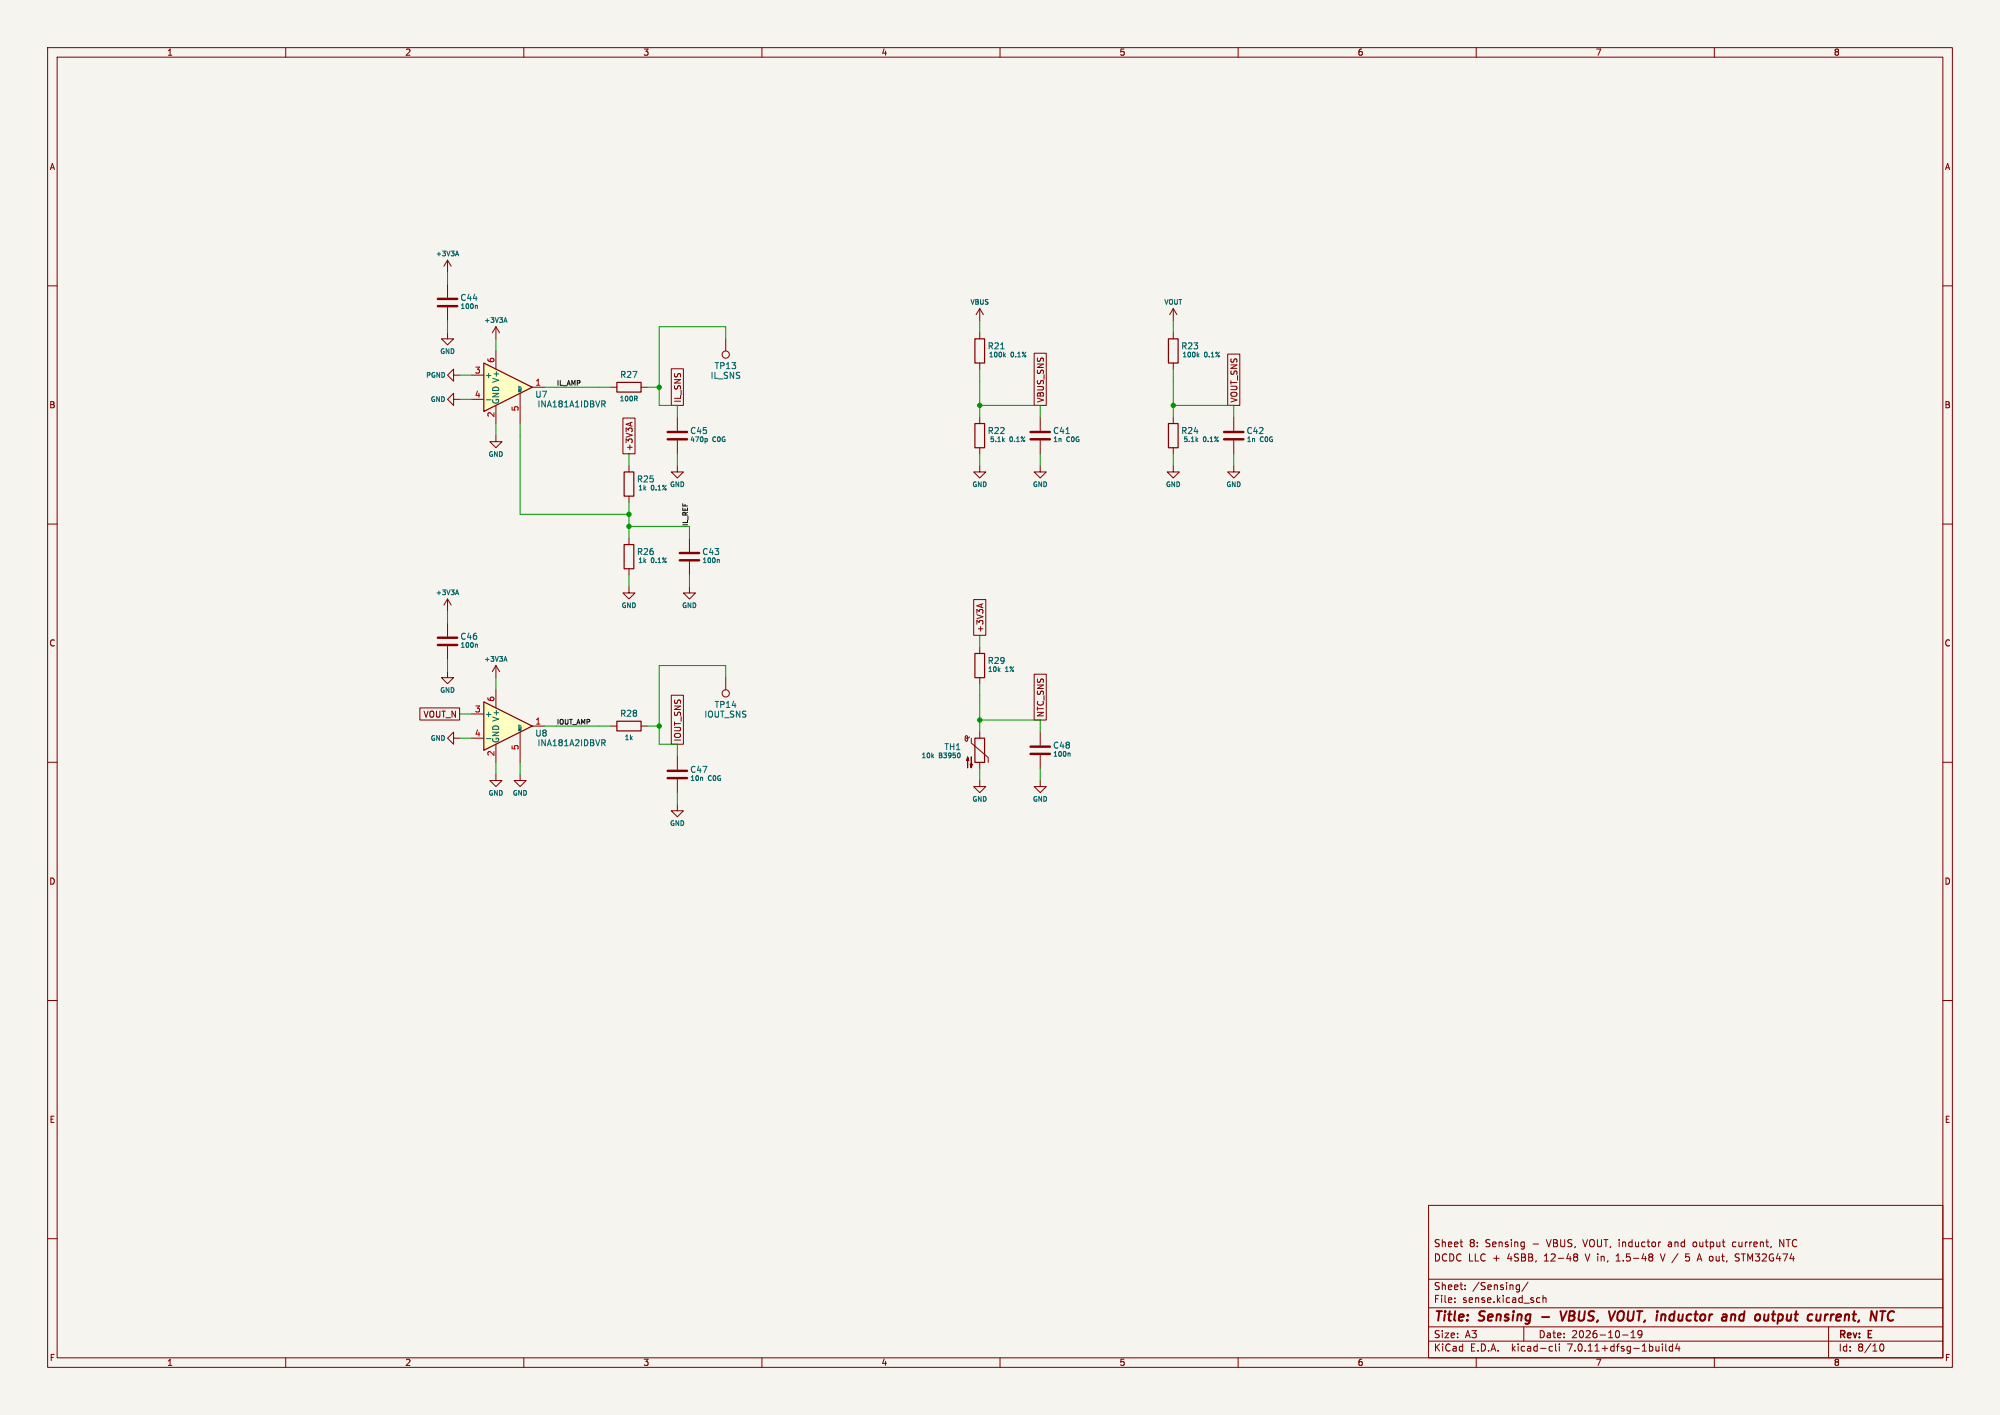
[picture p9: page 8]

Id: 8/10 Title: Sensing - VBUS, VOUT, inductor and output current, NTC

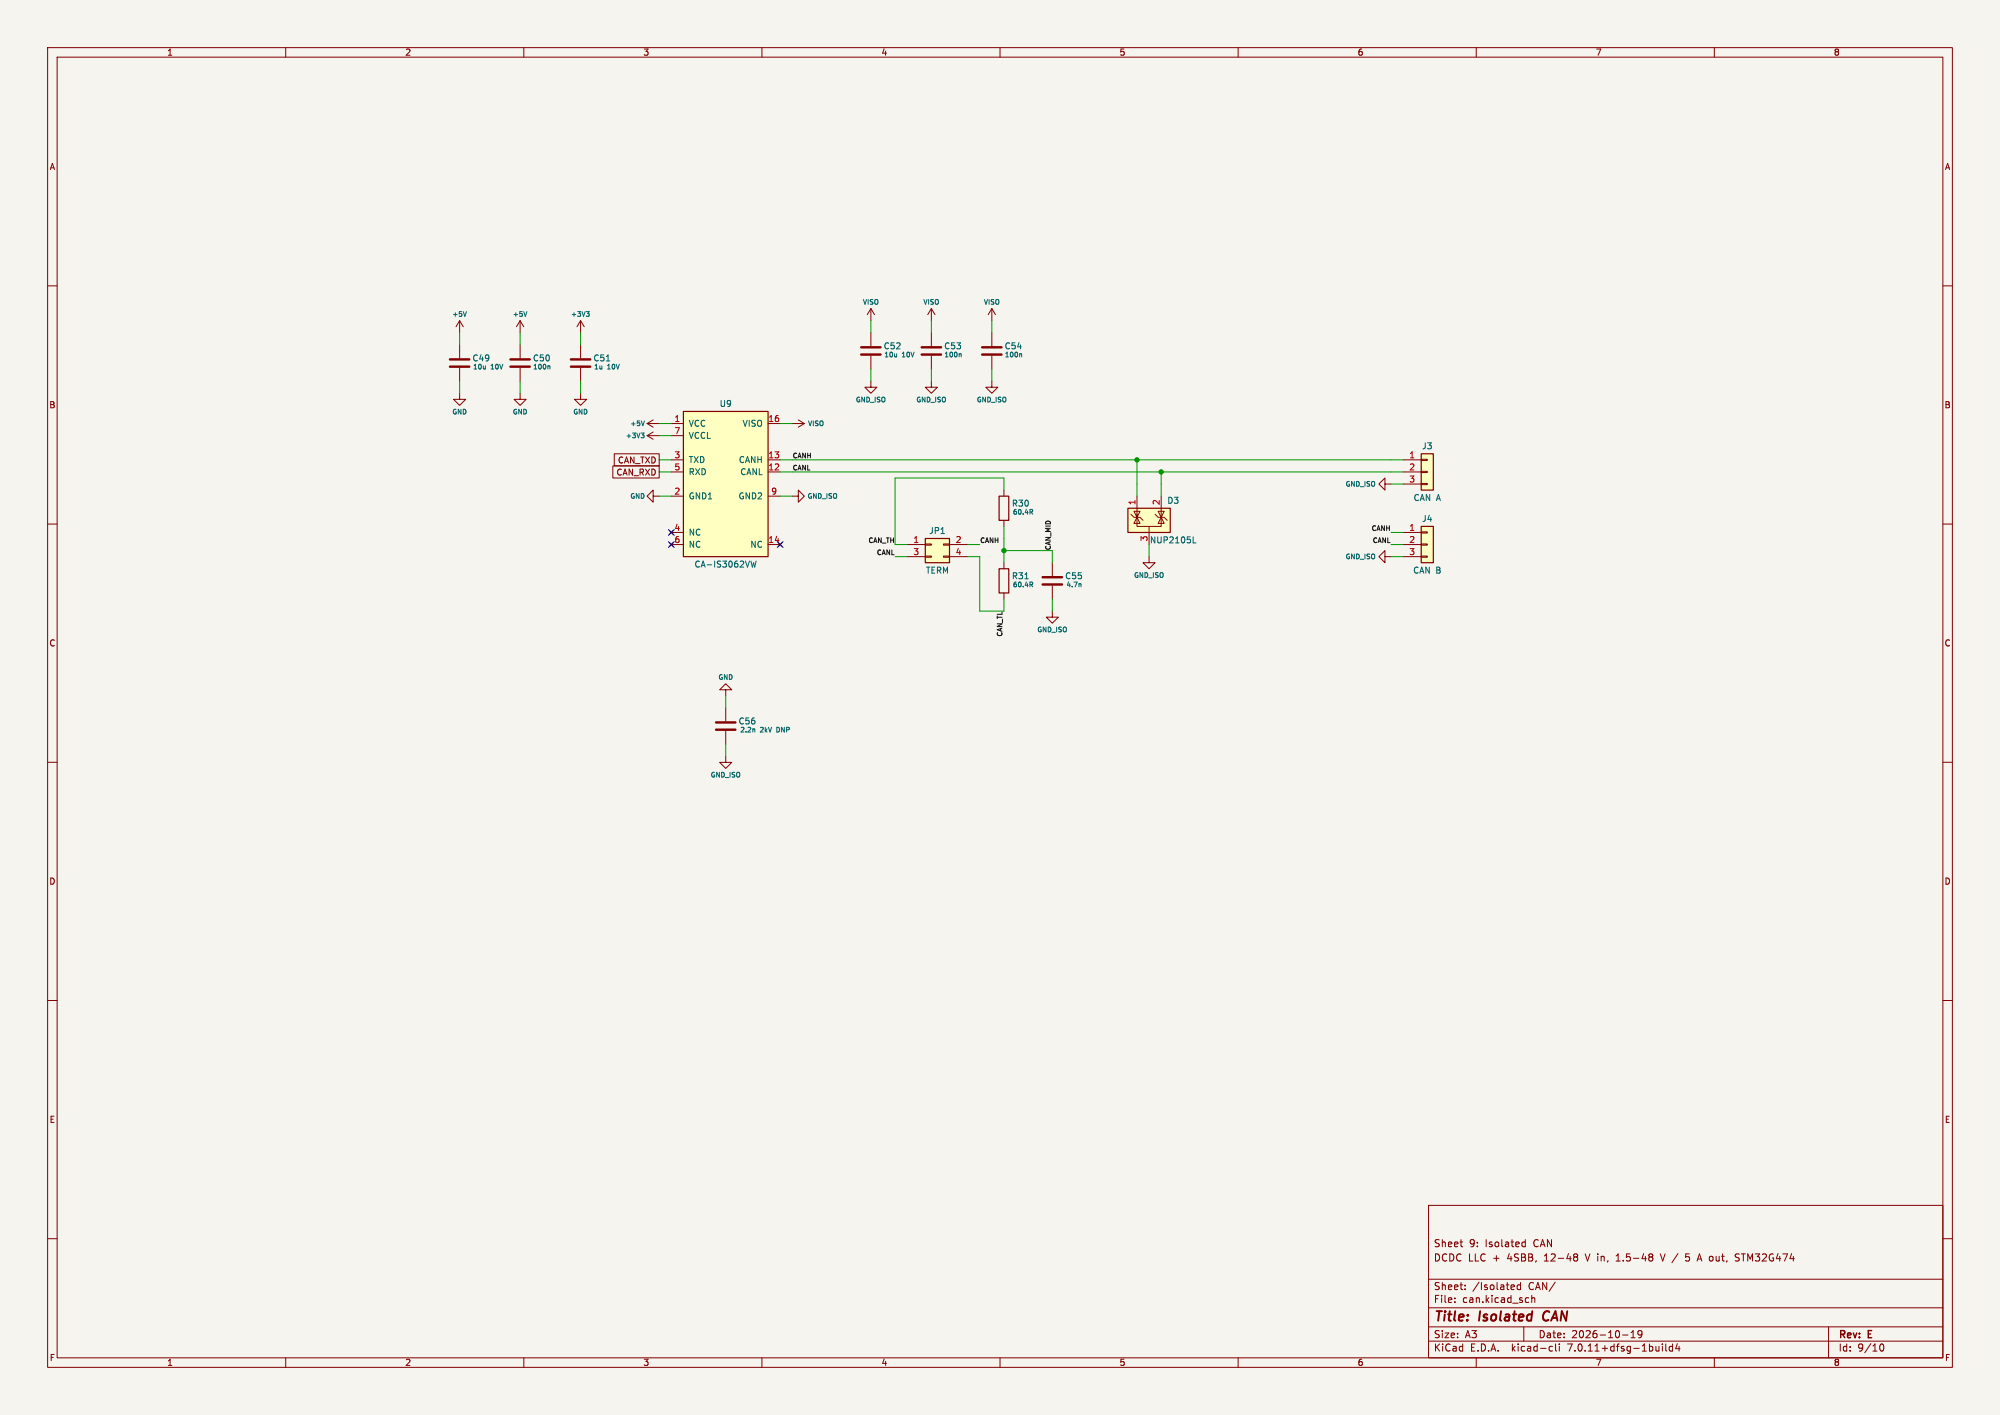
[picture p10: page 9]

Id: 9/10 Title: Isolated CAN

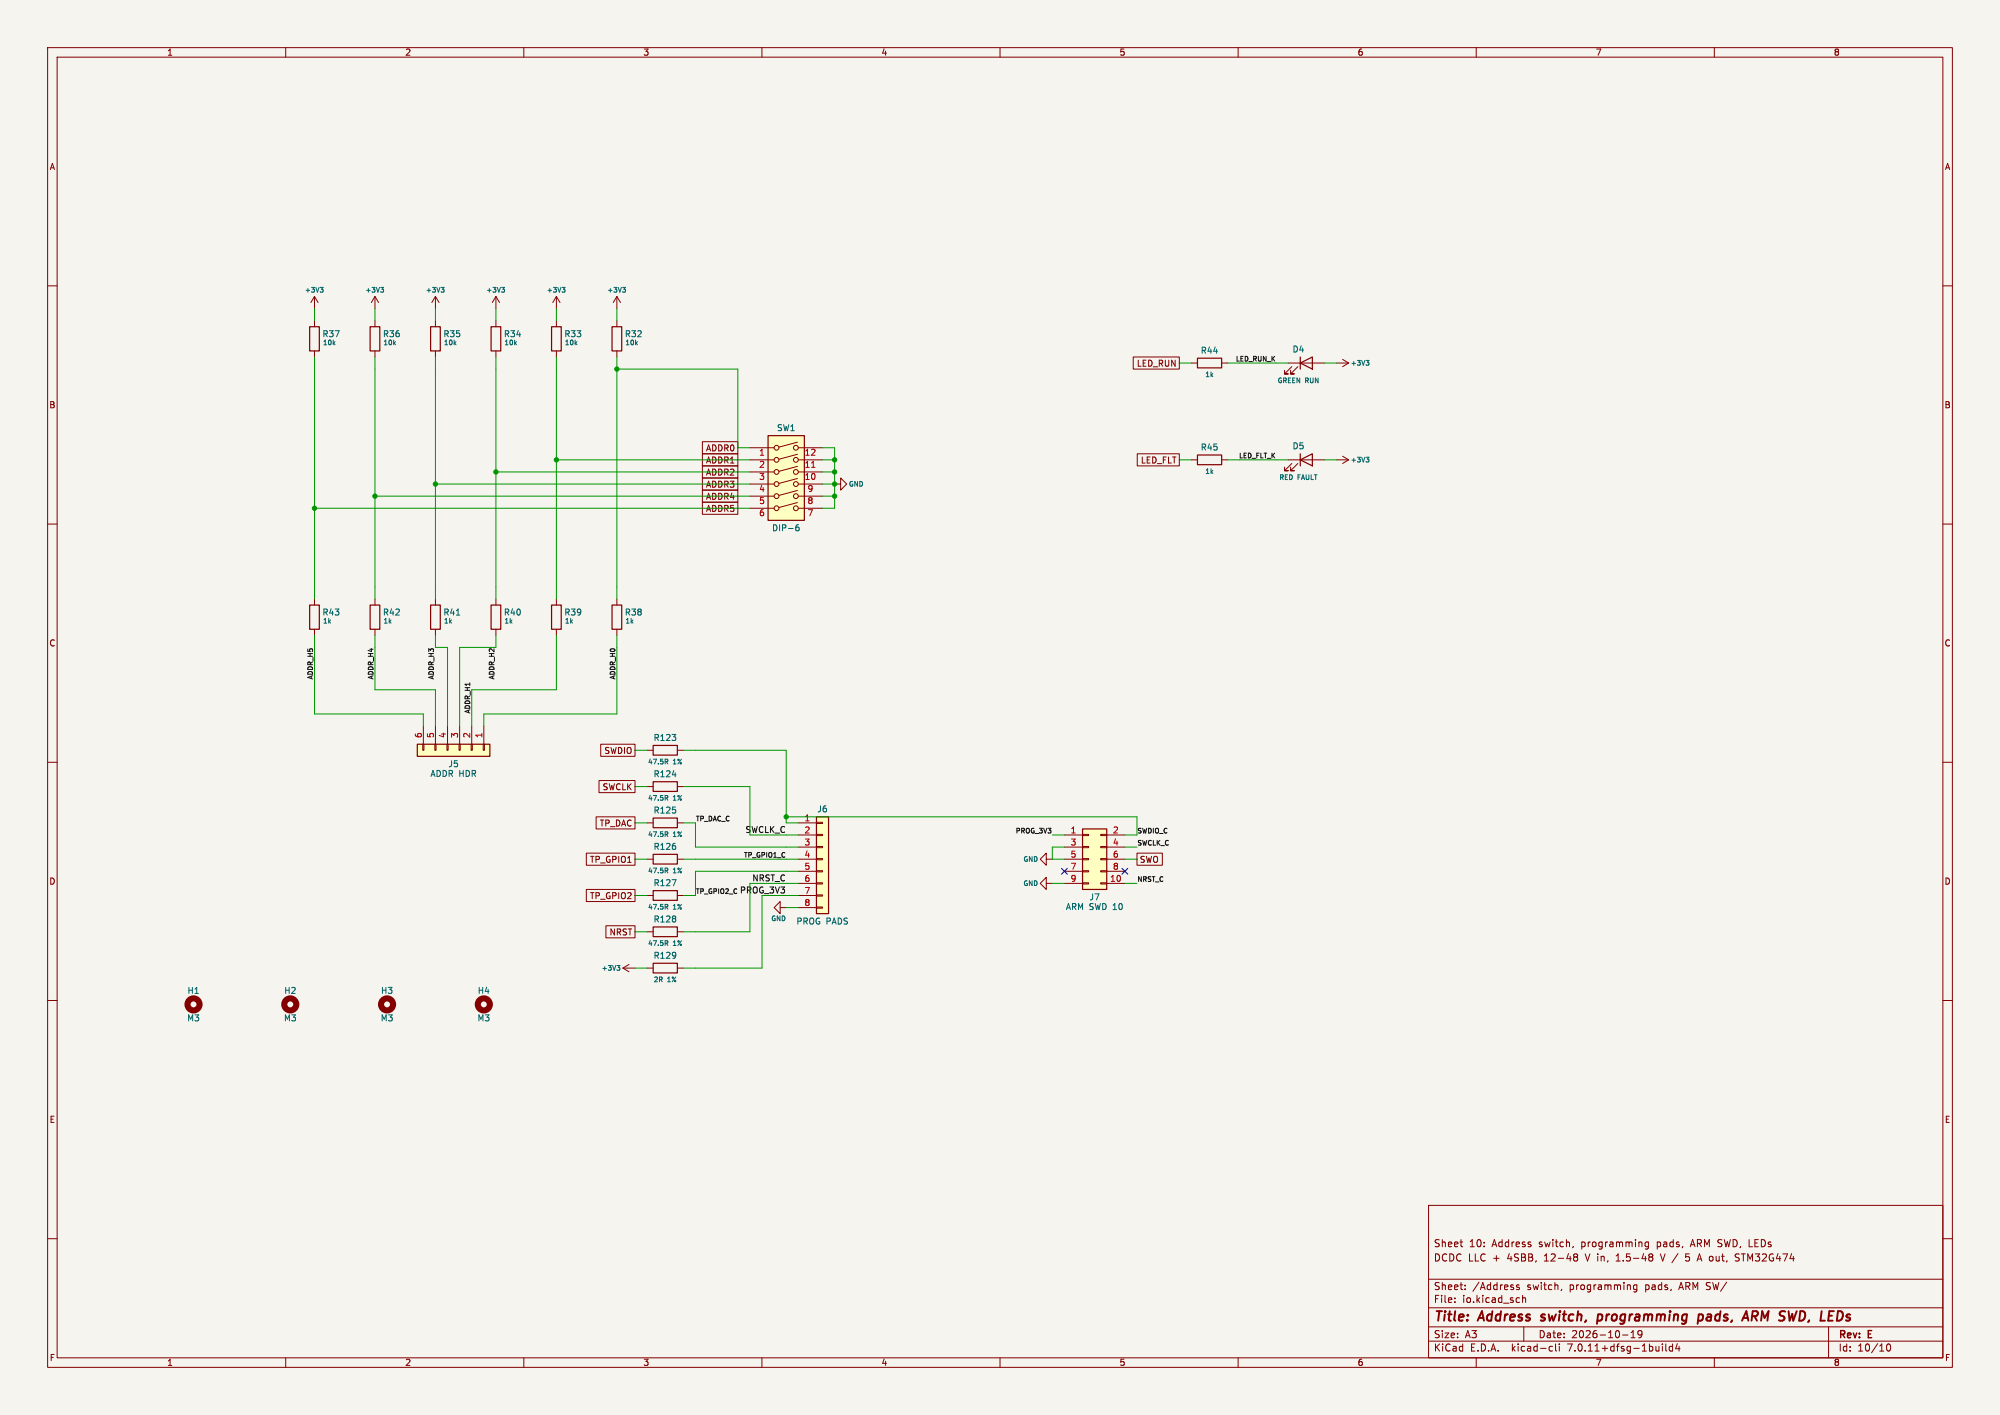
[picture p11: page 10]

Id: 10/10 Title: Address switch, programming pads, ARM SWD, LEDs
