shousei01/dcdc_converter/01_hardware/docs/DCDC_LLC_4SBB_G474_PCB_layers.pdf

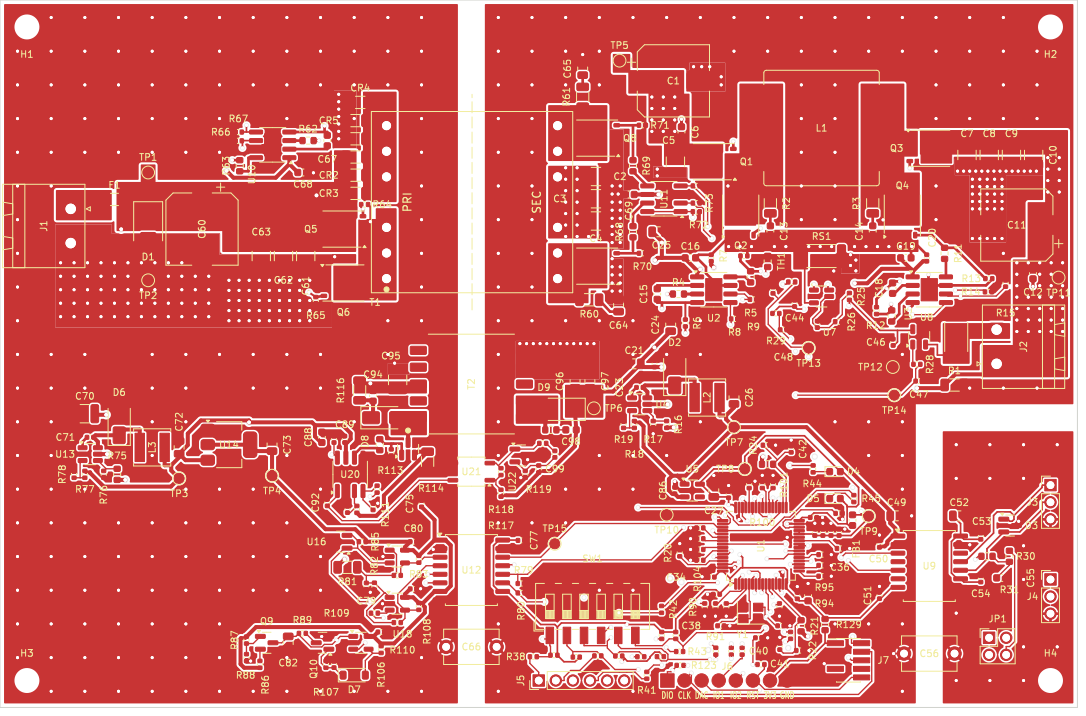
[picture p12: page 1]

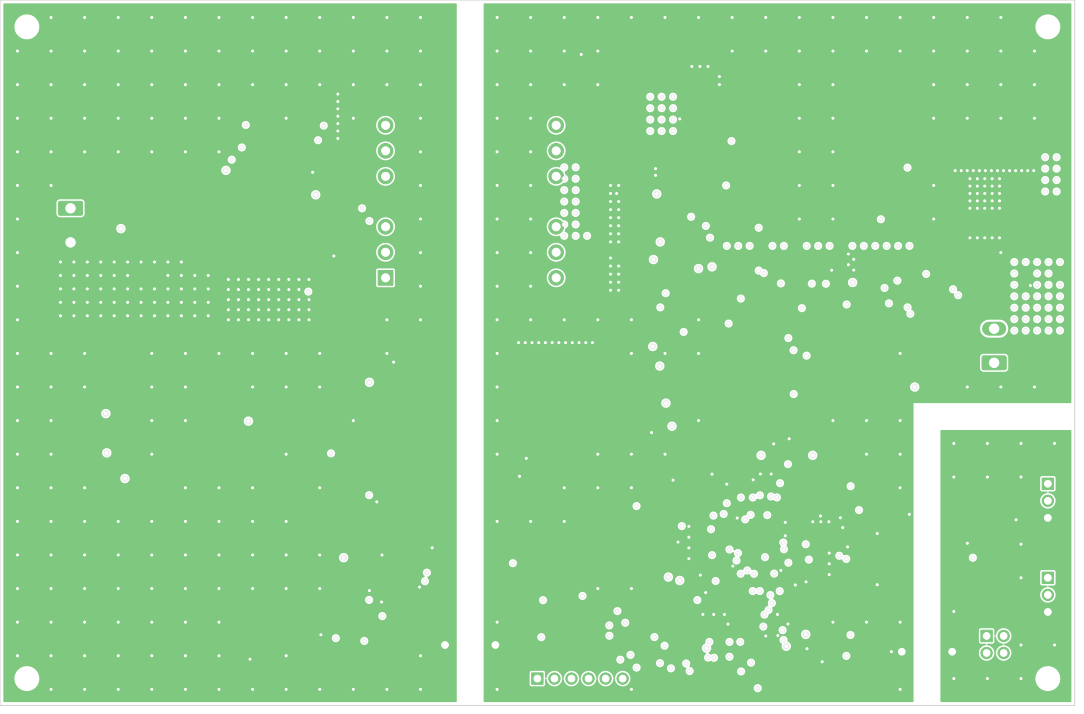
[picture p13: page 2]

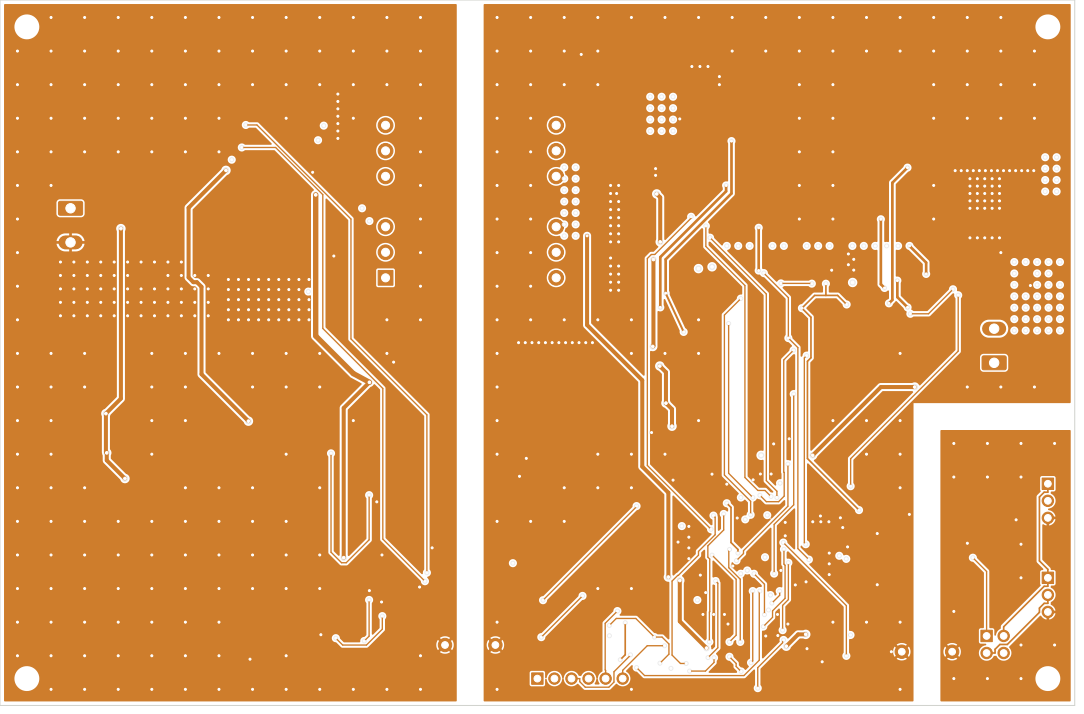
[picture p14: page 3]

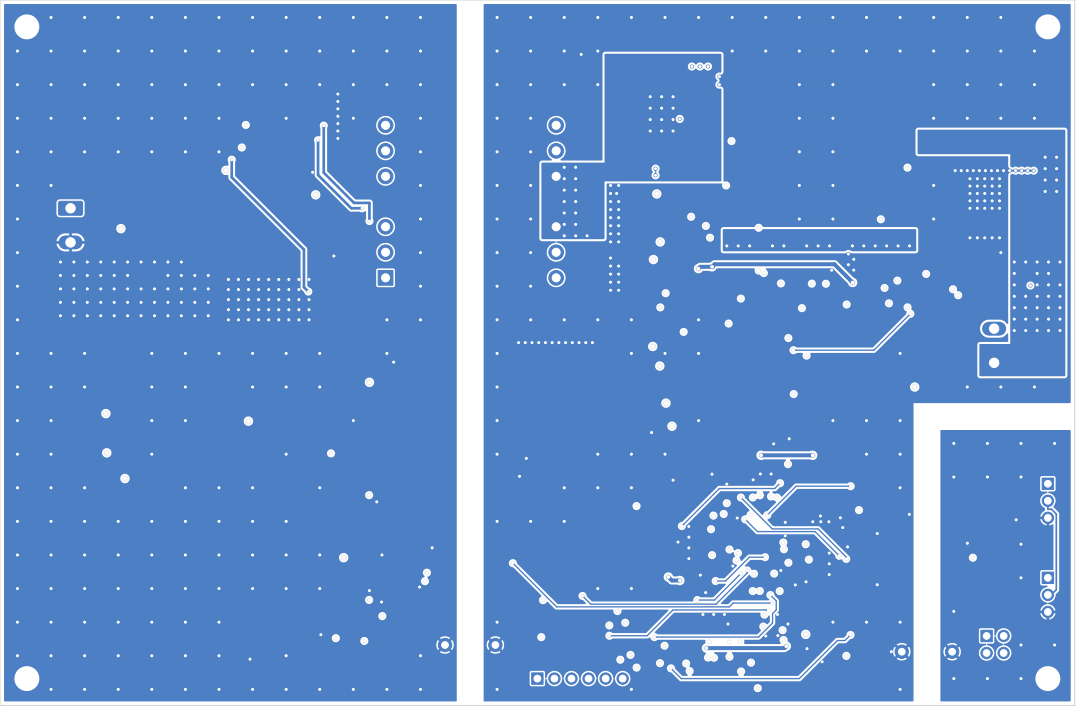
[picture p15: page 4]
