shousei01/dcdc_converter/01_hardware/kicad_project/DCDC_LLC_4SBB_G474.kicad_pcb

## KiCad design 01_hardware/kicad_project/DCDC_LLC_4SBB_G474.kicad_pcb (2026-10-20)

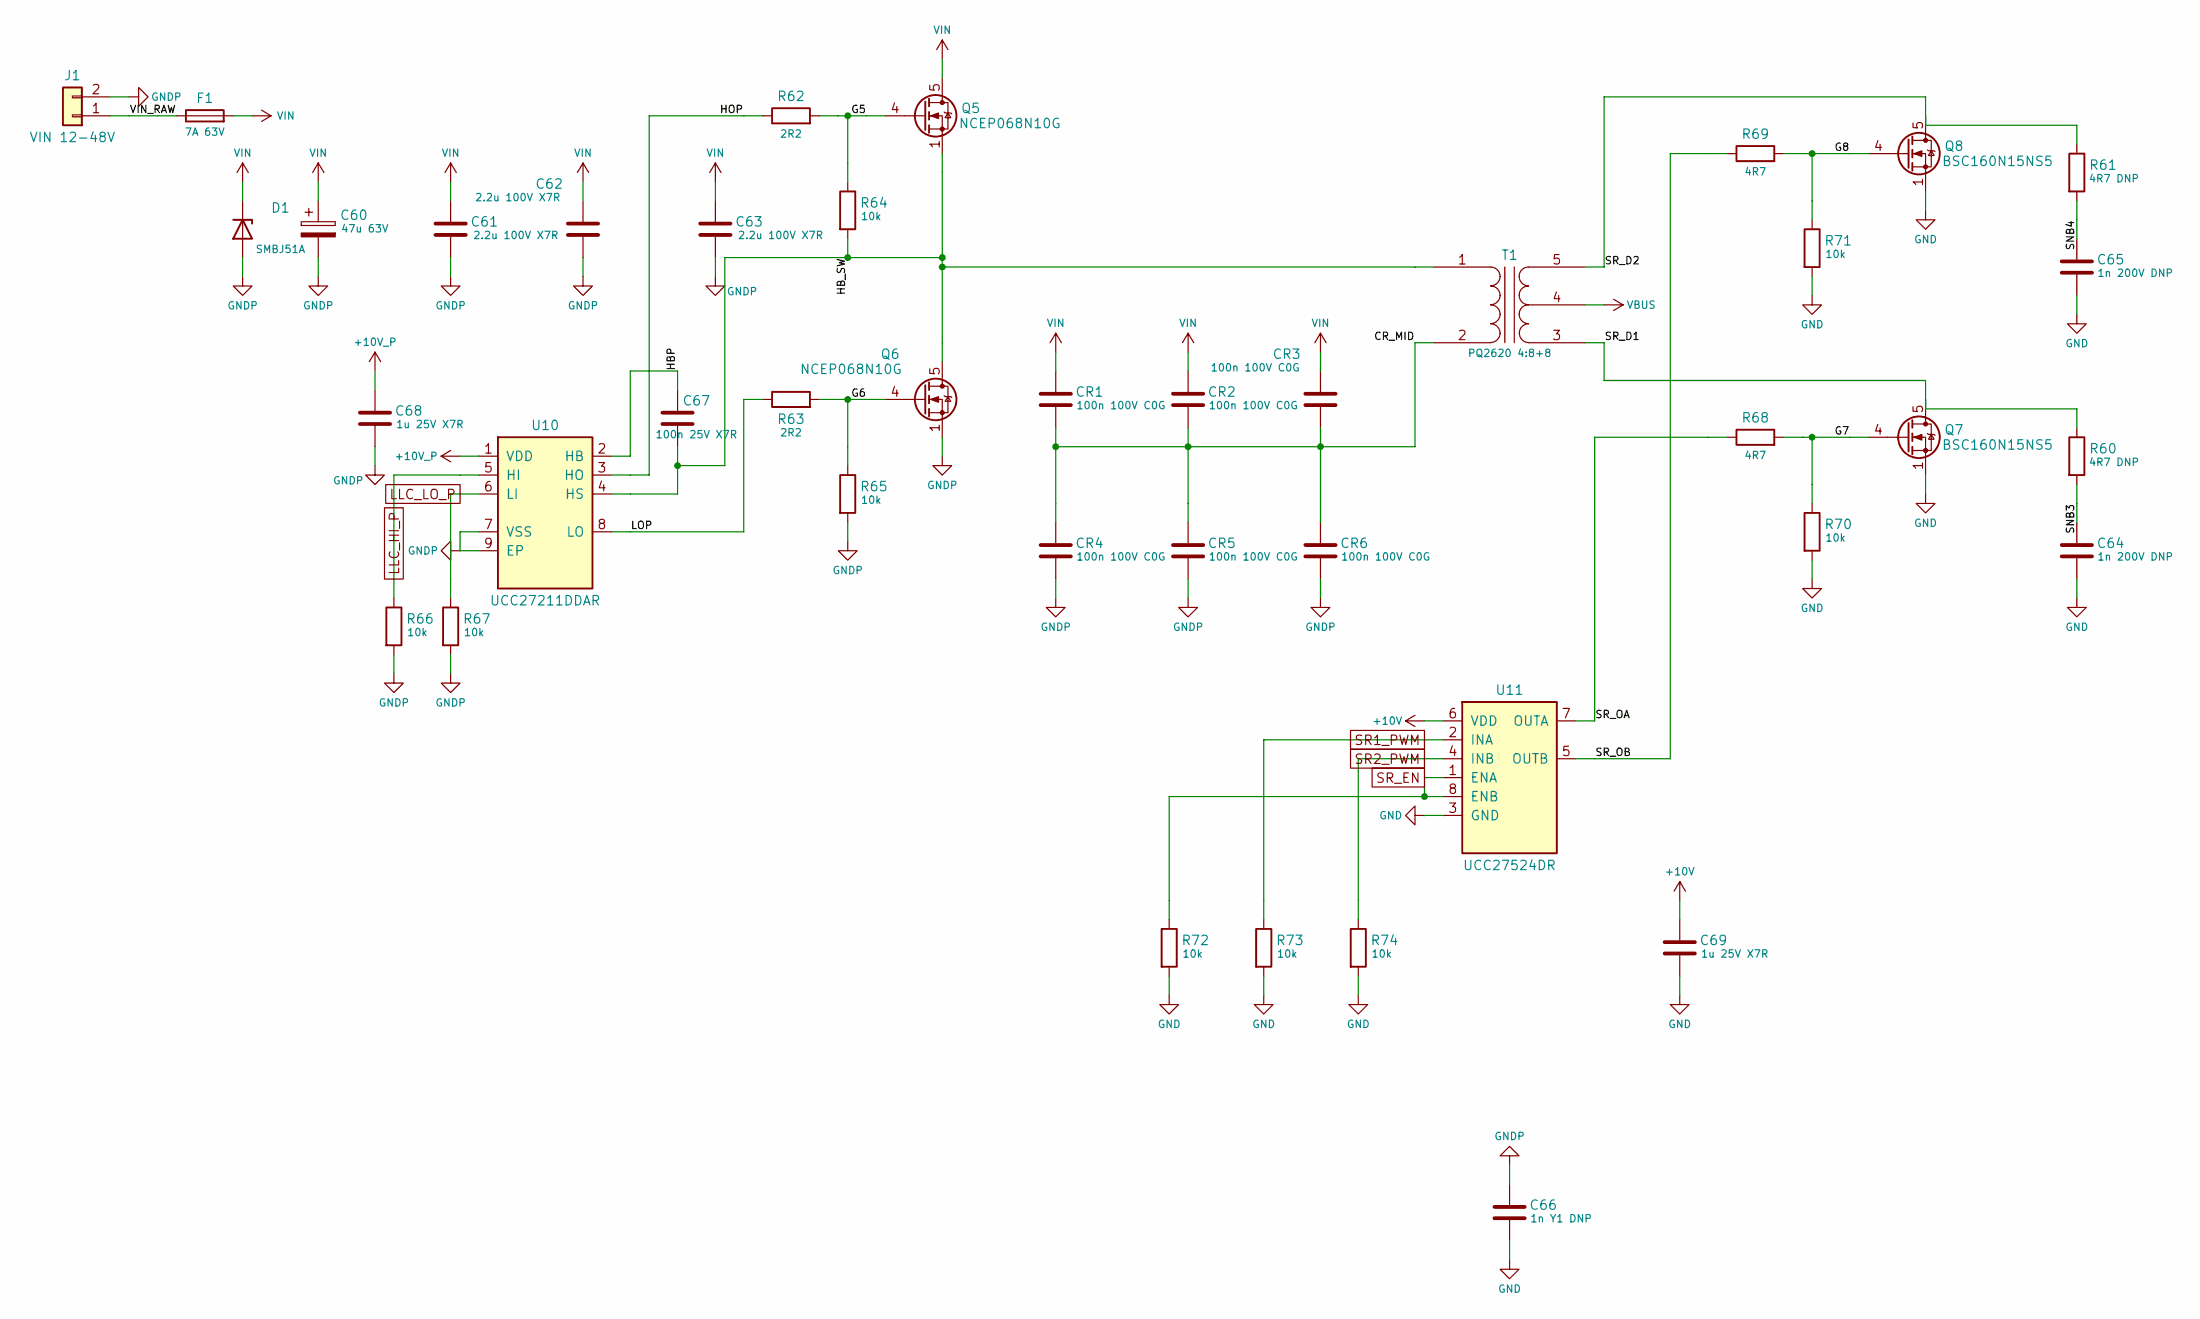
[picture p16: schematic llc.kicad_sch, LLC isolation stage - half-bridge, PQ2620, synchronous rect…]

Parts:
C60: 47u 63V; CP_Elec_10x10.5; MPN 47u 63V; LCSC C249664
C61, C62, C63: 2.2u 100V X7R; C_1210_3225Metric; MPN 2.2u 100V X7R; LCSC C153036
C64, C65: 1n 200V DNP; C_0805_2012Metric; MPN 1n 200V DNP
C66: 1n Y1 DNP; C_Disc_D8.0mm_W5.0mm_P7.50mm; MPN 1n Y1 DNP
C67: 100n 25V X7R; C_0603_1608Metric; MPN 100n 25V X7R; LCSC C14663
C68, C69: 1u 25V X7R; C_0603_1608Metric; MPN 1u 25V X7R; LCSC C15849
CR1, CR2, CR3, CR4, CR5, CR6: 100n 100V C0G; C_1206_3216Metric; MPN 100n 100V C0G; LCSC C2940749
D1: SMBJ51A; D_SMB; MPN SMBJ51A; LCSC C20883337
F1: 7A 63V; Fuse_1206_3216Metric; MPN 0458007.DR; LCSC C206980
J1: VIN 12-48V; PhoenixContact_MSTBA_2,5_2-G-5,08_1x02_P5.08mm_Horizontal; MPN KF2EDGR-5.08-2P; LCSC C441204
Q5, Q6: NCEP068N10G; TDSON-8-1; MPN NCEP068N10G; LCSC C503061
Q7, Q8: BSC160N15NS5; TDSON-8-1; MPN BSC160N15NS5; LCSC C459172
R60, R61: 4R7 DNP; R_1206_3216Metric; MPN 4R7 DNP
R62, R63: 2R2; R_0603_1608Metric; MPN 2R2; LCSC C2907006
R64, R65, R66, R67, R70, R71, R72, R73, R74: 10k; R_0402_1005Metric; MPN 10k; LCSC C2906861
R68, R69: 4R7; R_0603_1608Metric; MPN 4R7; LCSC C23164
T1: PQ2620 4:8+8; TX_PQ2620_12P; MPN PQ2620 4:8+8
U10: UCC27211DDAR; SOIC-8-1EP_3.9x4.9mm_P1.27mm_EP2.41x3.3mm; MPN UCC27211DDAR; LCSC C141980
U11: UCC27524DR; SOIC-8_3.9x4.9mm_P1.27mm; MPN UCC27524DR; LCSC C465729

Connections:
+10V: C69.1, U11.6 (VDD); also elsewhere on the board
+10V_P: C68.1, U10.1 (VDD); also elsewhere on the board
CR_MID: CR1.2, CR2.2, CR3.2, CR4.1, CR5.1, CR6.1, T1.2 (AB)
G5: Q5.4 (G), R62.2, R64.1
G6: Q6.4 (G), R63.2, R65.1
G7: Q7.4 (G), R68.2, R70.1
G8: Q8.4 (G), R69.2, R71.1
GND: C64.2, C65.2, C66.2, C69.2, Q7.1 (S), Q7.2 (S), Q7.3 (S), Q8.1 (S), Q8.2 (S), Q8.3 (S), R70.2, R71.2, R72.2, R73.2, R74.2, U11.3 (GND); also elsewhere on the board
GNDP: C60.2, C61.2, C62.2, C63.2, C66.1, C68.2, CR4.2, CR5.2, CR6.2, D1.2 (A), J1.2, Q6.1 (S), Q6.2 (S), Q6.3 (S), R65.2, R66.2, R67.2, U10.7 (VSS), U10.9 (EP); also elsewhere on the board
HBP: C67.1, U10.2 (HB)
HB_SW: C67.2, Q5.1 (S), Q5.2 (S), Q5.3 (S), Q6.5 (D), R64.2, T1.1 (AA), U10.4 (HS)
HOP: R62.1, U10.3 (HO)
LLC_HI_P: R66.1, U10.5 (HI); also elsewhere on the board
LLC_LO_P: R67.1, U10.6 (LI); also elsewhere on the board
LOP: R63.1, U10.8 (LO)
SNB3: C64.1, R60.2
SNB4: C65.1, R61.2
SR1_PWM: R73.1, U11.2 (INA); also elsewhere on the board
SR2_PWM: R74.1, U11.4 (INB); also elsewhere on the board
SR_D1: Q7.5 (D), R60.1, T1.3 (SA)
SR_D2: Q8.5 (D), R61.1, T1.5 (SB)
SR_EN: R72.1, U11.1 (ENA), U11.8 (ENB); also elsewhere on the board
SR_OA: R68.1, U11.7 (OUTA)
SR_OB: R69.1, U11.5 (OUTB)
VBUS: T1.4 (SC); also elsewhere on the board
VIN: C60.1, C61.1, C62.1, C63.1, CR1.1, CR2.1, CR3.1, D1.1 (K), F1.2, Q5.5 (D); also elsewhere on the board
VIN_RAW: F1.1, J1.1

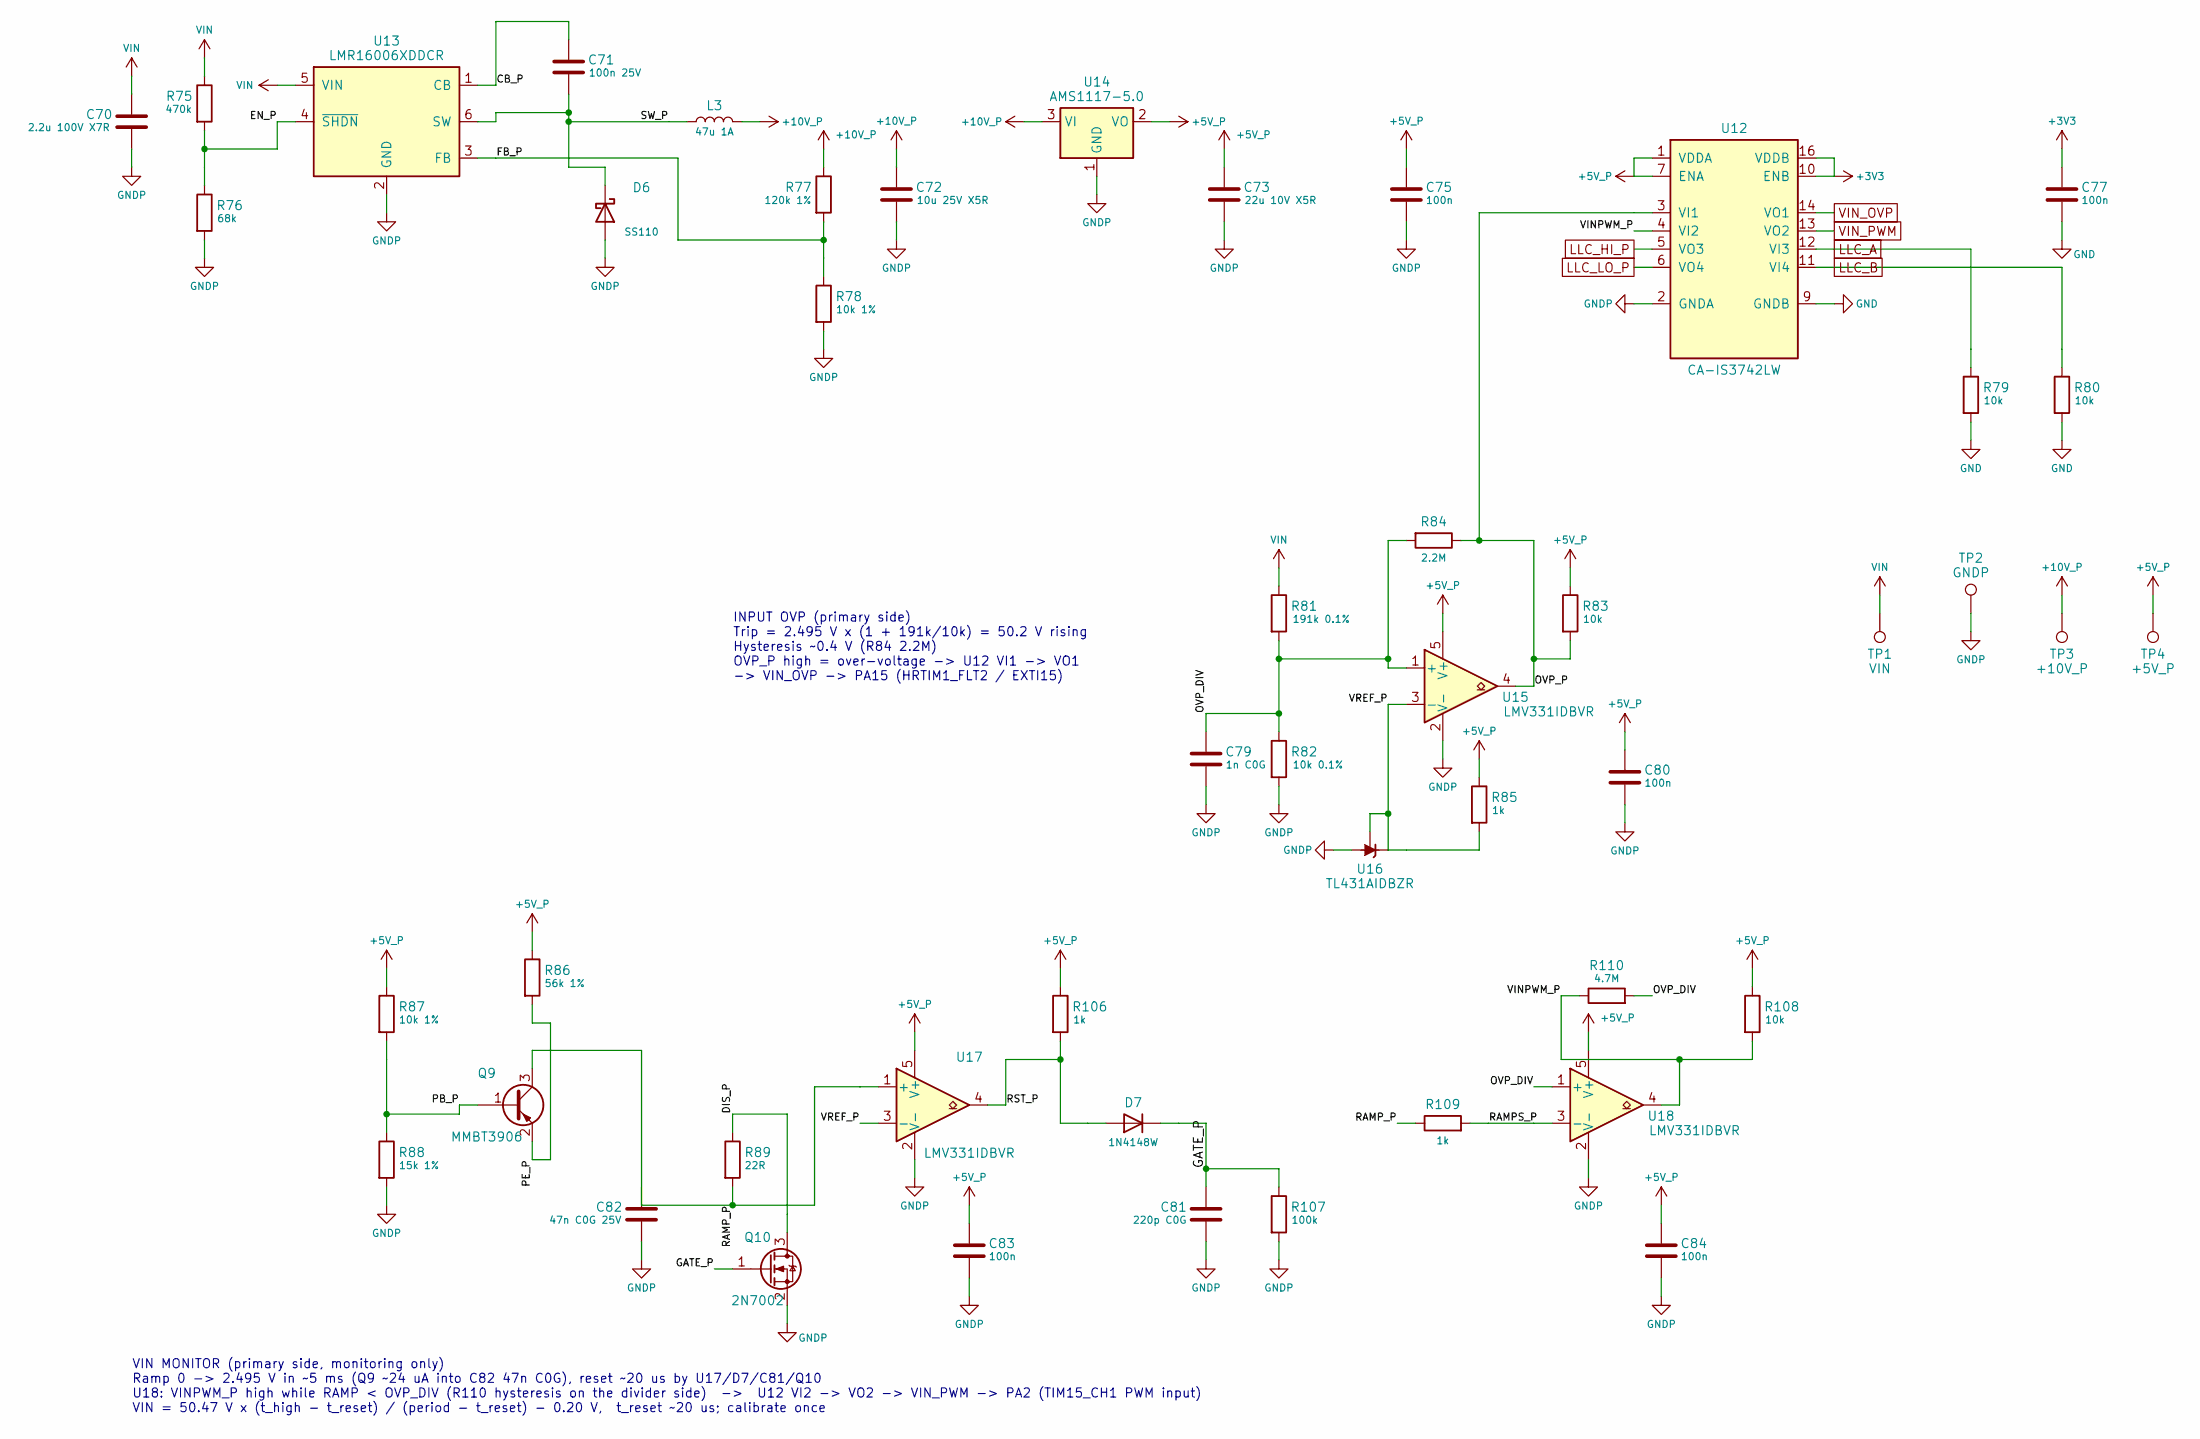
[picture p17: schematic pri_aux.kicad_sch, Primary aux supply, CA-IS3742 isolator, input OVP and VIN m…]

Parts:
C70: 2.2u 100V X7R; C_1210_3225Metric; MPN 2.2u 100V X7R; LCSC C153036
C71: 100n 25V; C_0402_1005Metric; MPN 100n 25V; LCSC C307331
C72: 10u 25V X5R; C_0805_2012Metric; MPN 10u 25V X5R; LCSC C15850
C73: 22u 10V X5R; C_0805_2012Metric; MPN 22u 10V X5R; LCSC C45783
C75, C77, C80, C83, C84: 100n; C_0402_1005Metric; MPN 100n; LCSC C307331
C79: 1n C0G; C_0402_1005Metric; MPN 1n C0G; LCSC C113780
C81: 220p C0G; C_0402_1005Metric; MPN 220p C0G; LCSC C107001
C82: 47n C0G 25V; C_0805_2012Metric; MPN C0805C473F3GECAUTO; LCSC C2233314
D6: SS110; D_SMA; MPN SS110; LCSC C2482
D7: 1N4148W; D_SOD-123; MPN 1N4148W; LCSC C81598
L3: 47u 1A; L_Sunlord_SWPA5040S; MPN FNR5040S470MT; LCSC C167974
Q9: MMBT3906; SOT-23; MPN MMBT3906; LCSC C53444
Q10: 2N7002; SOT-23; MPN 2N7002; LCSC C8545
R75: 470k; R_0603_1608Metric; MPN 470k; LCSC C23178
R76: 68k; R_0402_1005Metric; MPN 68k; LCSC C36871
R77: 120k 1%; R_0402_1005Metric; MPN 120k 1%; LCSC C25750
R78, R87: 10k 1%; R_0402_1005Metric; MPN 10k 1%; LCSC C2906861
R79, R80, R83, R108: 10k; R_0402_1005Metric; MPN 10k; LCSC C2906861
R81: 191k 0.1%; R_1206_3216Metric; MPN 191k 0.1%; LCSC C870479
R82: 10k 0.1%; R_0402_1005Metric; MPN 10k 0.1%; LCSC C844452
R84: 2.2M; R_0402_1005Metric; MPN 2.2M; LCSC C11490
R85, R106, R109: 1k; R_0402_1005Metric; MPN 1k; LCSC C11702
R86: 56k 1%; R_0402_1005Metric; MPN 56k 1%; LCSC C25796
R88: 15k 1%; R_0402_1005Metric; MPN 15k 1%; LCSC C25756
R89: 22R; R_0402_1005Metric; MPN 22R; LCSC C2929994
R107: 100k; R_0402_1005Metric; MPN 100k; LCSC C25741
R110: 4.7M; R_0402_1005Metric; MPN 4.7M; LCSC C227116
TP1: VIN; TestPoint_Pad_D1.5mm; MPN PCB pad, no part
TP2: GNDP; TestPoint_Pad_D1.5mm; MPN PCB pad, no part
TP3: +10V_P; TestPoint_Pad_D1.5mm; MPN PCB pad, no part
TP4: +5V_P; TestPoint_Pad_D1.5mm; MPN PCB pad, no part
U12: CA-IS3742LW; SOIC-16W_7.5x10.3mm_P1.27mm; MPN CA-IS3742LW; LCSC C4944981
U13: LMR16006XDDCR; SOT-23-6; MPN LMR16006XDDCR; LCSC C87080
U14: AMS1117-5.0; SOT-223-3_TabPin2; MPN AMS1117-5.0; LCSC C6187
U15, U17, U18: LMV331IDBVR; SOT-23-5; MPN LMV331IDBVR; LCSC C34731
U16: TL431AIDBZR; SOT-23; MPN TL431AIDBZR (TI pinout: 1 K, 2 REF, 3 A); LCSC C23892

Connections:
+3V3: C77.1, U12.10 (ENB), U12.16 (VDDB); also elsewhere on the board
+5V_P: C73.1, C75.1, C80.1, C83.1, C84.1, R83.1, R85.1, R86.1, R87.1, R106.1, R108.1, TP4.1, U12.1 (VDDA), U12.7 (ENA), U14.2 (VO), U15.5 (V+), U17.5 (V+), U18.5 (V+)
+10V_P: C72.1, L3.2, R77.1, TP3.1, U14.3 (VI); also elsewhere on the board
CB_P: C71.1, U13.1 (CB)
DIS_P: Q10.3 (D), R89.1
EN_P: R75.2, R76.1, U13.4 (~SHDN)
FB_P: R77.2, R78.1, U13.3 (FB)
GATE_P: C81.1, D7.1 (K), Q10.1 (G), R107.1
GND: C77.2, R79.2, R80.2, U12.9 (GNDB), U12.15 (GNDB); also elsewhere on the board
GNDP: C70.2, C72.2, C73.2, C75.2, C79.2, C80.2, C81.2, C82.2, C83.2, C84.2, D6.2 (A), Q10.2 (S), R76.2, R78.2, R82.2, R88.2, R107.2, TP2.1, U12.2 (GNDA), U12.8 (GNDA), U13.2 (GND), U14.1 (GND), U15.2 (V-), U16.3 (A), U17.2 (V-), U18.2 (V-); also elsewhere on the board
LLC_A: R79.1, U12.12 (VI3); also elsewhere on the board
LLC_B: R80.1, U12.11 (VI4); also elsewhere on the board
LLC_HI_P: U12.5 (VO3); also elsewhere on the board
LLC_LO_P: U12.6 (VO4); also elsewhere on the board
OVP_DIV: C79.1, R81.2, R82.1, R84.2, R110.2, U15.1 (+), U18.1 (+)
OVP_P: R83.2, R84.1, U12.3 (VI1), U15.4
PB_P: Q9.1 (B), R87.2, R88.1
PE_P: Q9.2 (E), R86.2
RAMPS_P: R109.2, U18.3 (-)
RAMP_P: C82.1, Q9.3 (C), R89.2, R109.1, U17.1 (+)
RST_P: D7.2 (A), R106.2, U17.4
SW_P: C71.2, D6.1 (K), L3.1, U13.6 (SW)
VIN: C70.1, R75.1, R81.1, TP1.1, U13.5 (VIN); also elsewhere on the board
VINPWM_P: R108.2, R110.1, U12.4 (VI2), U18.4
VIN_OVP: U12.14 (VO1); also elsewhere on the board
VIN_PWM: U12.13 (VO2); also elsewhere on the board
VREF_P: R85.2, U15.3 (-), U16.1 (K), U16.2 (REF), U17.3 (-)

Notes on the sheet:
INPUT OVP (primary side) Trip = 2.495 V x (1 + 191k/10k) = 50.2 V rising Hysteresis ~0.4 V (R84 2.2M) OVP_P high = over-voltage -> U12 VI1 -> VO1 -> VIN_OVP -> PA15 (HRTIM1_FLT2 / EXTI15)
VIN MONITOR (primary side, monitoring only) Ramp 0 -> 2.495 V in ~5 ms (Q9 ~24 uA into C82 47n C0G), reset ~20 us by U17/D7/C81/Q10 U18: VINPWM_P high while RAMP < OVP_DIV (R110 hysteresis on the divider side) -> U12 VI2 -> VO2 -> VIN_PWM -> PA2 (TIM15_CH1 PWM input) VIN = 50.47 V x (t_high - t_res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

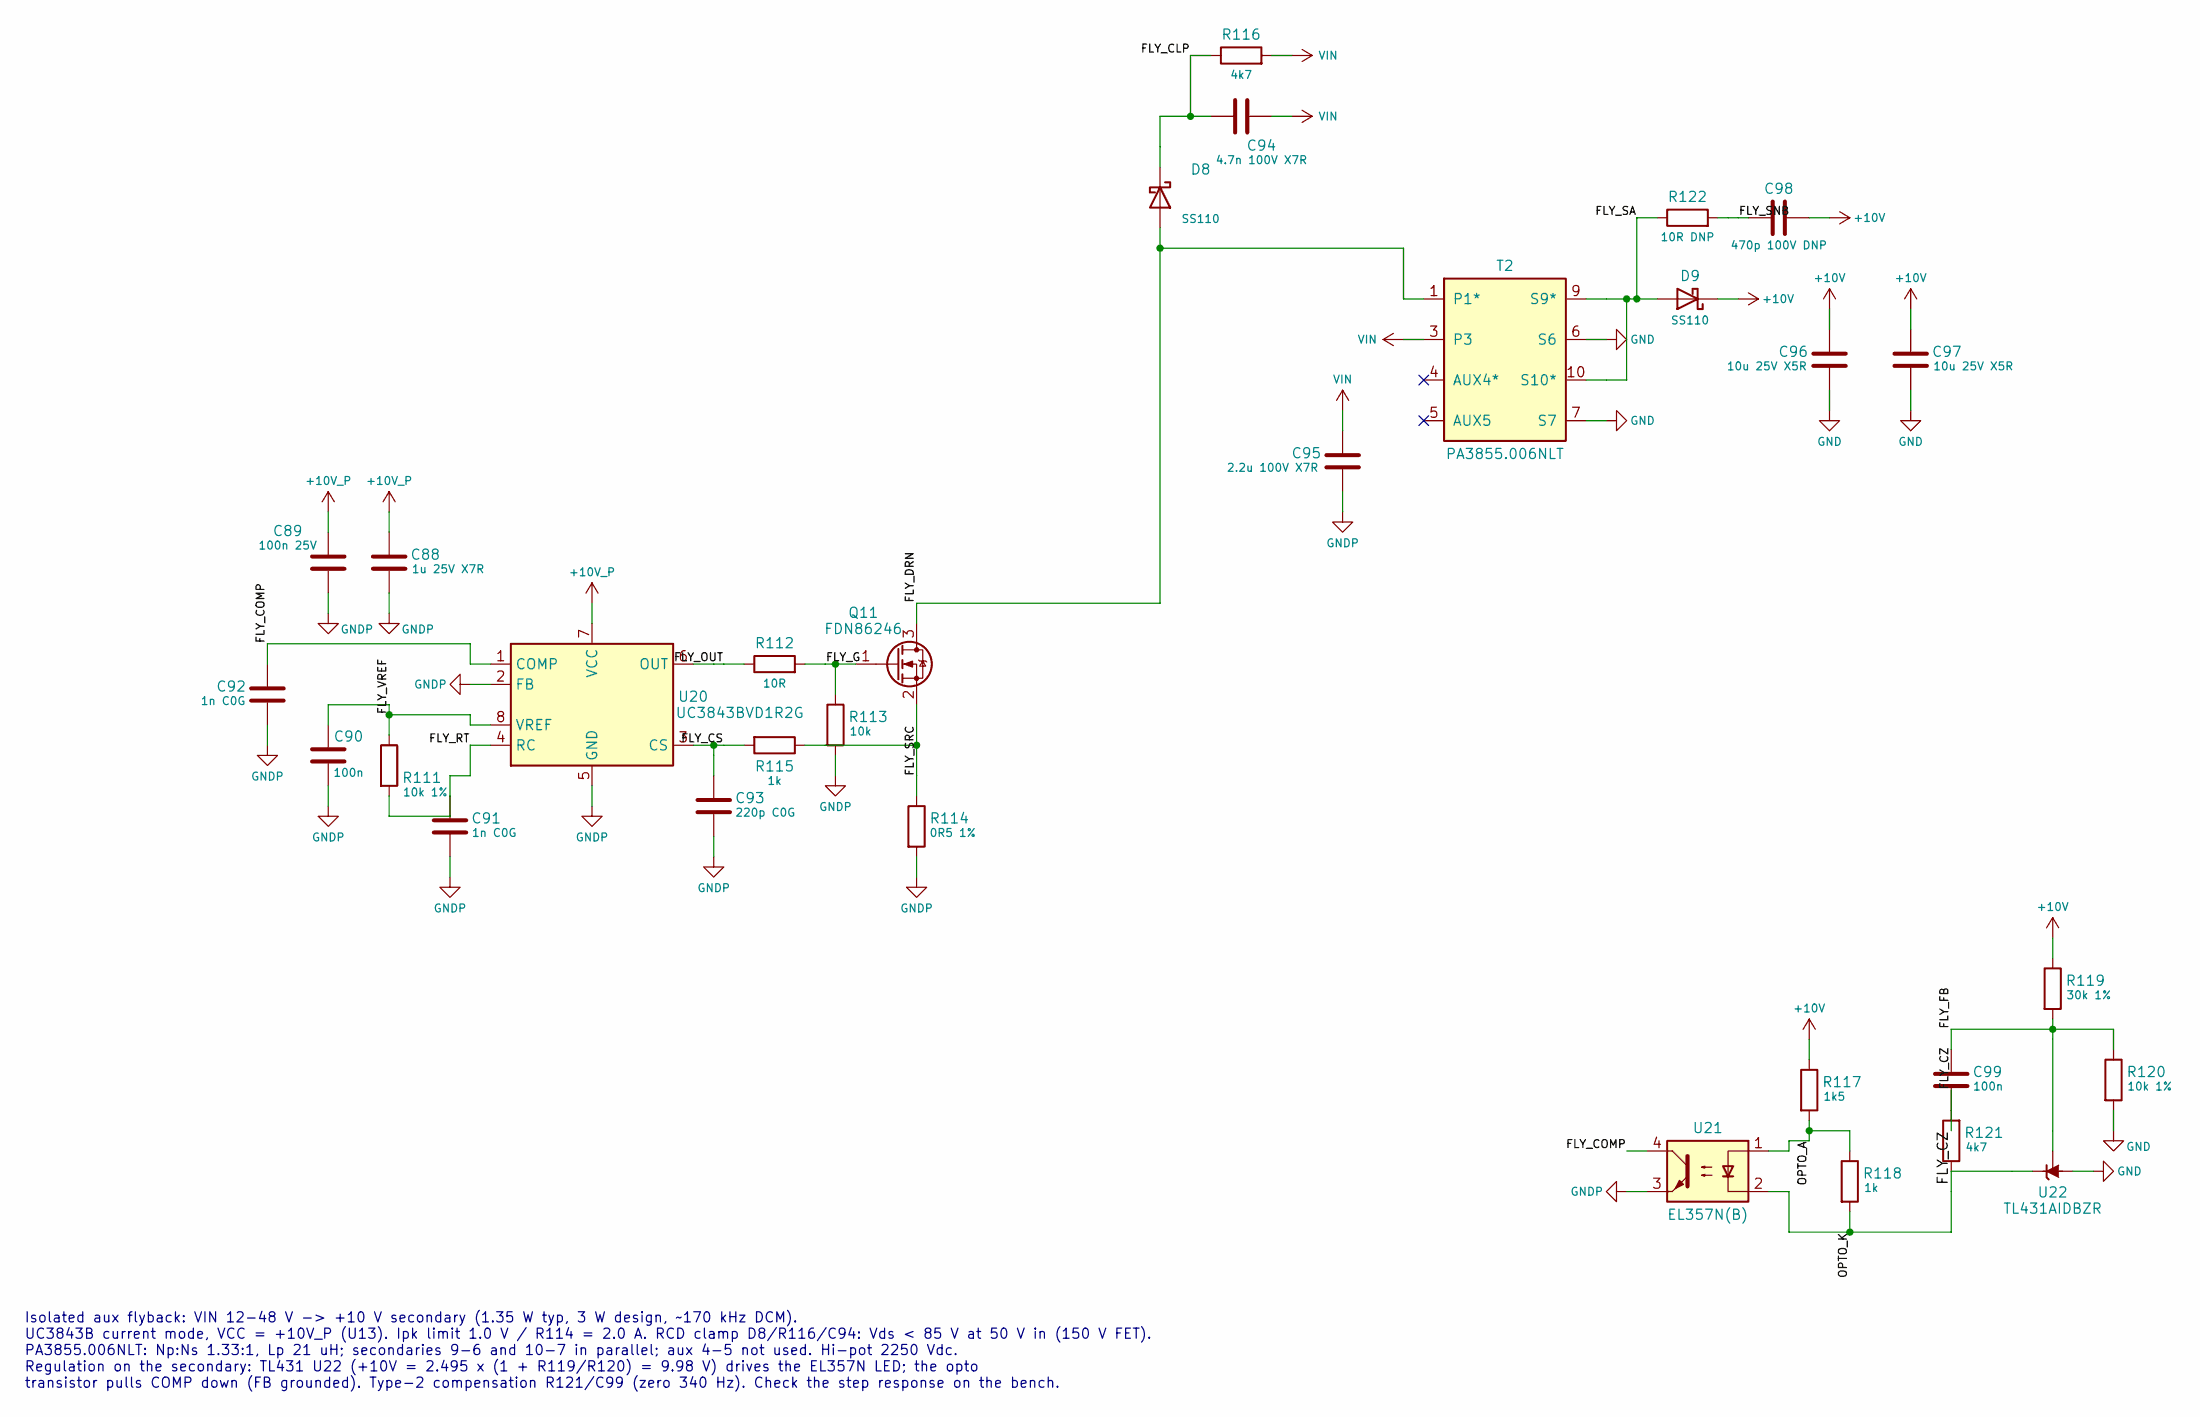
[picture p18: schematic iso_pwr.kicad_sch, Isolated aux flyback - UC3843B, PA3855, TL431 + optocoupler]

Parts:
C88: 1u 25V X7R; C_0603_1608Metric; MPN 1u 25V X7R; LCSC C15849
C89: 100n 25V; C_0402_1005Metric; MPN 100n 25V; LCSC C307331
C90, C99: 100n; C_0402_1005Metric; MPN 100n; LCSC C307331
C91, C92: 1n C0G; C_0402_1005Metric; MPN 1n C0G; LCSC C113780
C93: 220p C0G; C_0402_1005Metric; MPN 220p C0G; LCSC C107001
C94: 4.7n 100V X7R; C_0603_1608Metric; MPN 4.7n 100V X7R; LCSC C115052
C95: 2.2u 100V X7R; C_1210_3225Metric; MPN 2.2u 100V X7R; LCSC C153036
C96, C97: 10u 25V X5R; C_0805_2012Metric; MPN 10u 25V X5R; LCSC C15850
C98: 470p 100V DNP; C_0603_1608Metric; MPN 470p 100V DNP
D8, D9: SS110; D_SMA; MPN SS110; LCSC C2482
Q11: FDN86246; SOT-23; MPN FDN86246; LCSC C891118
R111, R120: 10k 1%; R_0402_1005Metric; MPN 10k 1%; LCSC C2906861
R112: 10R; R_0603_1608Metric; MPN 10R; LCSC C22859
R113: 10k; R_0402_1005Metric; MPN 10k; LCSC C2906861
R114: 0R5 1%; R_1206_3216Metric; MPN 0R5 1%; LCSC C25340
R115, R118: 1k; R_0402_1005Metric; MPN 1k; LCSC C11702
R116: 4k7; R_1206_3216Metric; MPN 4k7; LCSC C17936
R117: 1k5; R_0402_1005Metric; MPN 1k5; LCSC C25867
R119: 30k 1%; R_0402_1005Metric; MPN 30k 1%; LCSC C25776
R121: 4k7; R_0402_1005Metric; MPN 4k7; LCSC C25900
R122: 10R DNP; R_0603_1608Metric; MPN 10R DNP
T2: PA3855.006NLT; TX_PA3855_EP13_10P; MPN PA3855.006NLT; LCSC C5718384
U20: UC3843BVD1R2G; SOIC-8_3.9x4.9mm_P1.27mm; MPN UC3843BVD1R2G; LCSC C231572
U21: EL357N(B); SOP-4_3.8x4.1mm_P2.54mm; MPN EL357N(B)(TA)-G; LCSC C42381015
U22: TL431AIDBZR; SOT-23; MPN TL431AIDBZR; LCSC C23892

Connections:
+10V: C96.1, C97.1, C98.2, D9.1 (K), R117.1, R119.1; also elsewhere on the board
+10V_P: C88.1, C89.1, U20.7 (VCC); also elsewhere on the board
FLY_CLP: C94.1, D8.1 (K), R116.1
FLY_COMP: C92.1, U20.1 (COMP), U21.4
FLY_CS: C93.1, R115.2, U20.3 (CS)
FLY_CZ: C99.1, R121.2
FLY_DRN: D8.2 (A), Q11.3 (D), T2.1 (P1*)
FLY_FB: C99.2, R119.2, R120.1, U22.2 (REF)
FLY_G: Q11.1 (G), R112.2, R113.1
FLY_OUT: R112.1, U20.6 (OUT)
FLY_RT: C91.1, R111.2, U20.4 (RC)
FLY_SA: D9.2 (A), R122.1, T2.9 (S9*), T2.10 (S10*)
FLY_SNB: C98.1, R122.2
FLY_SRC: Q11.2 (S), R114.1, R115.1
FLY_VREF: C90.1, R111.1, U20.8 (VREF)
GND: C96.2, C97.2, R120.2, T2.6 (S6), T2.7 (S7), U22.3 (A); also elsewhere on the board
GNDP: C88.2, C89.2, C90.2, C91.2, C92.2, C93.2, C95.2, R113.2, R114.2, U20.2 (FB), U20.5 (GND), U21.3; also elsewhere on the board
OPTO_A: R117.2, R118.1, U21.1
OPTO_K: R118.2, R121.1, U21.2, U22.1 (K)
VIN: C94.2, C95.1, R116.2, T2.3; also elsewhere on the board

Notes on the sheet:
Isolated aux flyback: VIN 12-48 V -> +10 V secondary (1.35 W typ, 3 W design, ~170 kHz DCM). UC3843B current mode, VCC = +10V_P (U13). Ipk limit 1.0 V / R114 = 2.0 A. RCD clamp D8/R116/C94: Vds < 85 V at 50 V in (150 V FET). PA3855.006NLT: Np:Ns 1.33:1, Lp 21 uH; secondaries 9-6 and 10-7 in paralle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

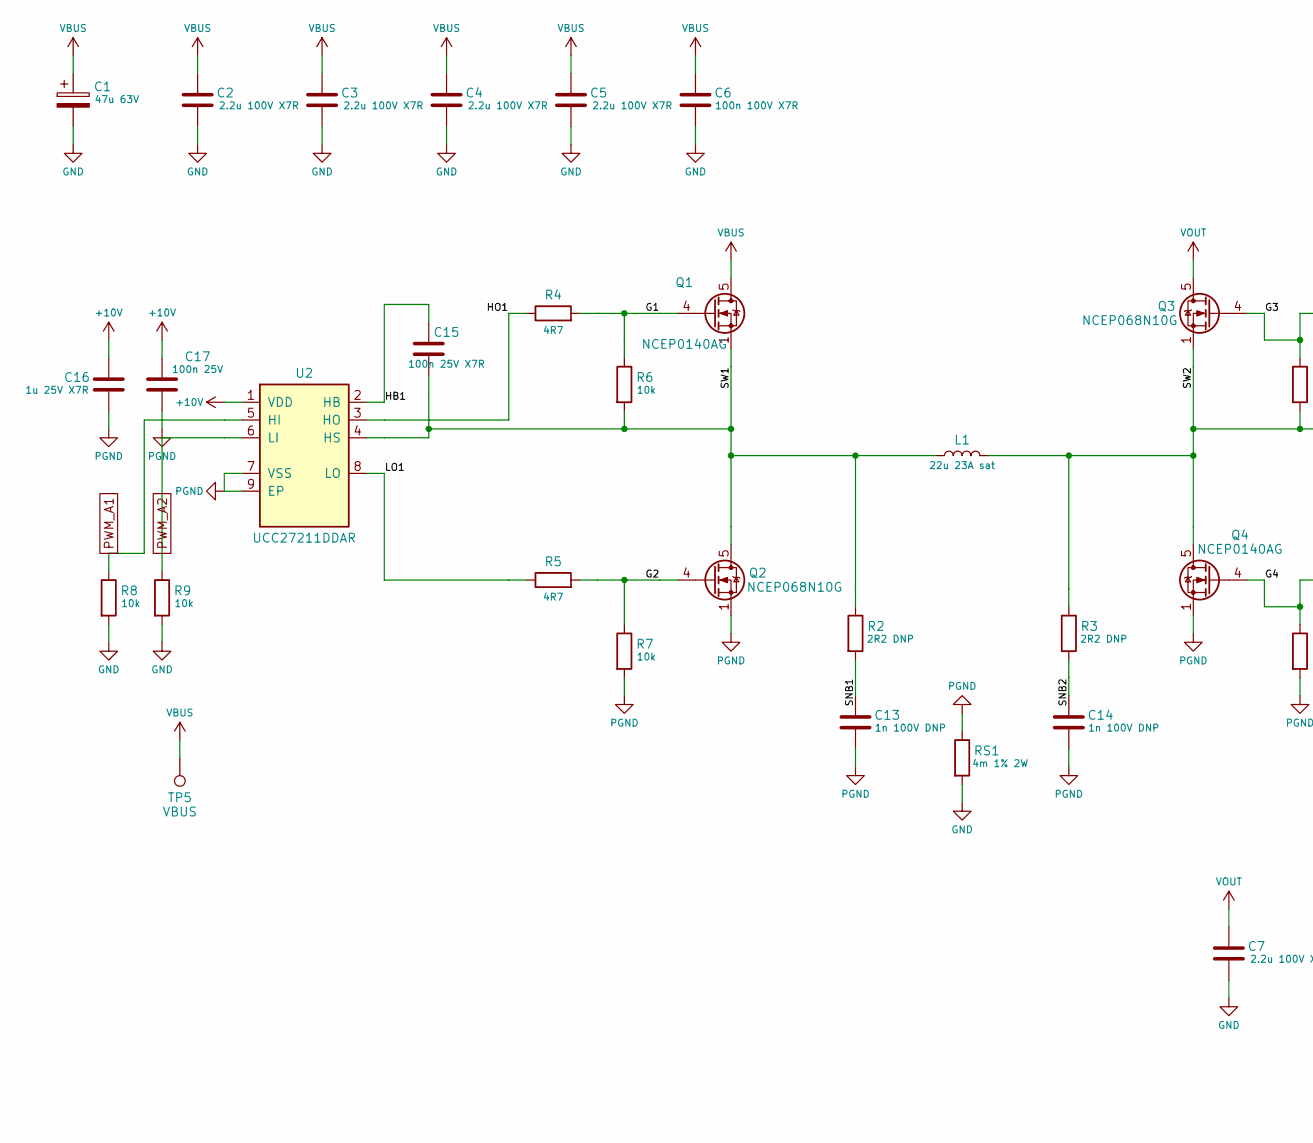
[picture p19: schematic sbb.kicad_sch, 4SBB regulator - power stage and gate drivers, part in row 1, column 1]

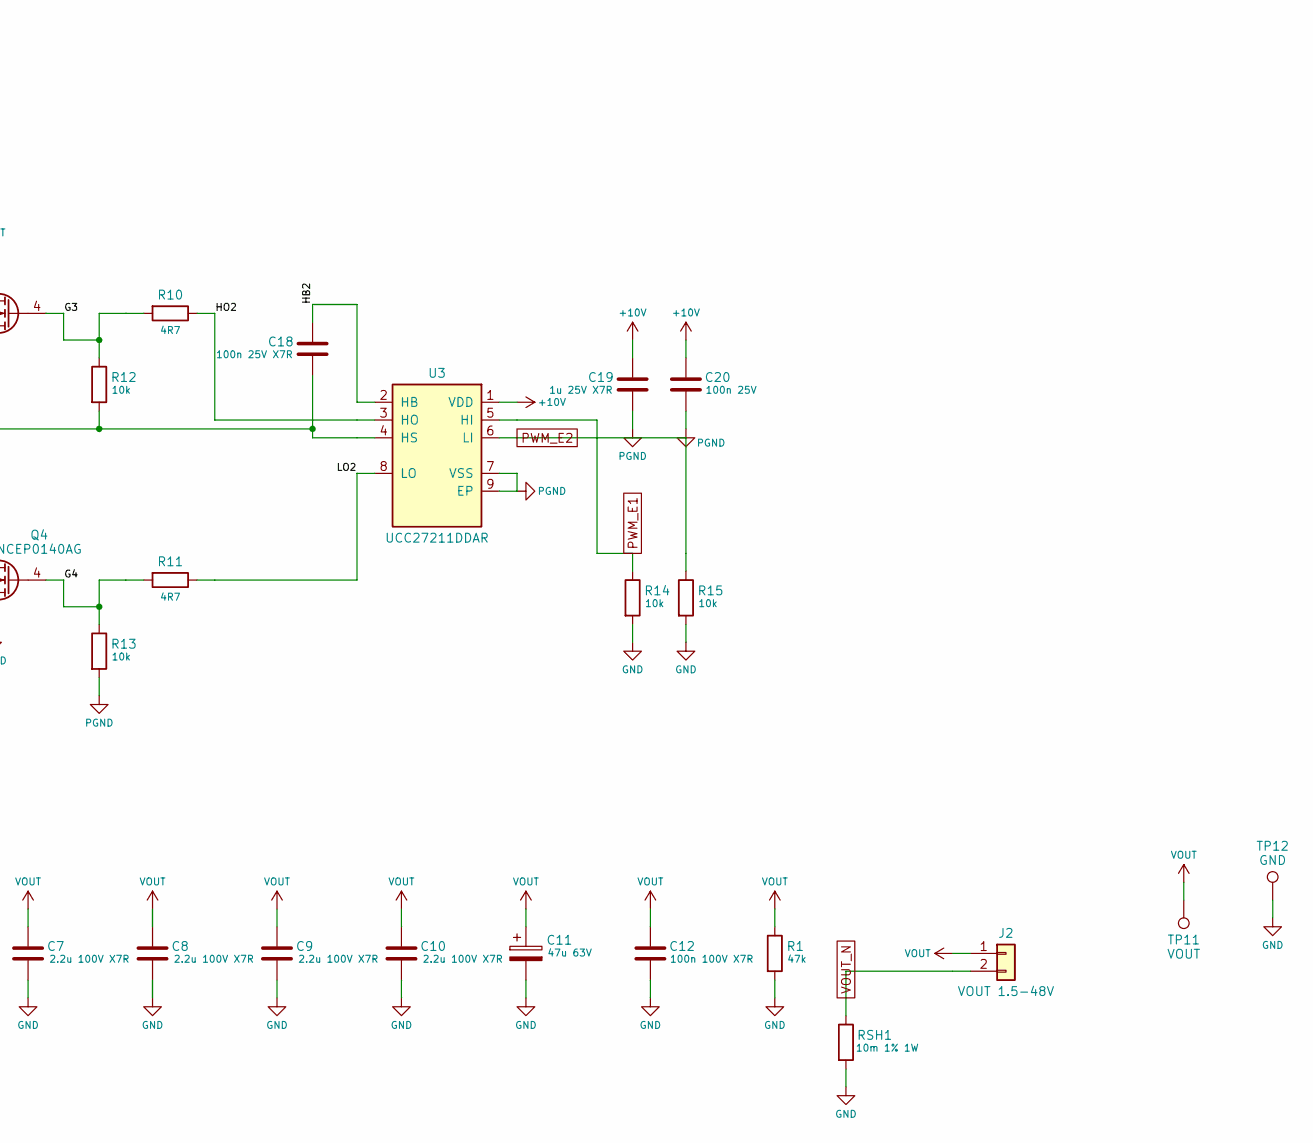
[picture p20: schematic sbb.kicad_sch, 4SBB regulator - power stage and gate drivers, part in row 1, column 2]

Parts:
C1, C11: 47u 63V; CP_Elec_10x10.5; MPN 47u 63V; LCSC C249664
C2, C3, C4, C5, C7, C8, C9, C10: 2.2u 100V X7R; C_1210_3225Metric; MPN 2.2u 100V X7R; LCSC C153036
C6, C12: 100n 100V X7R; C_0603_1608Metric; MPN 100n 100V X7R; LCSC C88219
C13, C14: 1n 100V DNP; C_0603_1608Metric; MPN 1n 100V DNP
C15, C18: 100n 25V X7R; C_0603_1608Metric; MPN 100n 25V X7R; LCSC C14663
C16, C19: 1u 25V X7R; C_0603_1608Metric; MPN 1u 25V X7R; LCSC C15849
C17, C20: 100n 25V; C_0402_1005Metric; MPN 100n 25V; LCSC C307331
J2: VOUT 1.5-48V; PhoenixContact_MSTBA_2,5_2-G-5,08_1x02_P5.08mm_Horizontal; MPN KF2EDGR-5.08-2P; LCSC C441204
L1: 22u 23A sat; L_Bourns_SRP1770TA_16.9x16.9mm; MPN PSPMAA1770-220M-CGP; LCSC C49308184
Q1, Q4: NCEP0140AG; TDSON-8-1; MPN NCEP0140AG; LCSC C503009
Q2, Q3: NCEP068N10G; TDSON-8-1; MPN NCEP068N10G; LCSC C503061
R1: 47k; R_1206_3216Metric; MPN 47k; LCSC C2907507
R2, R3: 2R2 DNP; R_1206_3216Metric; MPN 2R2 DNP
R4, R5, R10, R11: 4R7; R_0603_1608Metric; MPN 4R7; LCSC C23164
R6, R7, R8, R9, R12, R13, R14, R15: 10k; R_0402_1005Metric; MPN 10k; LCSC C2906861
RS1: 4m 1% 2W; R_2512_6332Metric; MPN HoJLR2512-3W-4mR-1%; LCSC C2904236
RSH1: 10m 1% 1W; R_2512_6332Metric; MPN 10m 1% 1W; LCSC C500718
TP5: VBUS; TestPoint_Pad_D1.5mm; MPN PCB pad, no part
TP11: VOUT; TestPoint_Pad_D1.5mm; MPN PCB pad, no part
TP12: GND; TestPoint_Pad_D1.5mm; MPN PCB pad, no part
U2, U3: UCC27211DDAR; SOIC-8-1EP_3.9x4.9mm_P1.27mm_EP2.41x3.3mm; MPN UCC27211DDAR; LCSC C141980

Connections:
+10V: C16.1, C17.1, C19.1, C20.1, U2.1 (VDD), U3.1 (VDD); also elsewhere on the board
G1: Q1.4 (G), R4.2, R6.1
G2: Q2.4 (G), R5.2, R7.1
G3: Q3.4 (G), R10.2, R12.1
G4: Q4.4 (G), R11.2, R13.1
GND: C1.2, C2.2, C3.2, C4.2, C5.2, C6.2, C7.2, C8.2, C9.2, C10.2, C11.2, C12.2, R1.2, R8.2, R9.2, R14.2, R15.2, RS1.2, RSH1.2, TP12.1; also elsewhere on the board
HB1: C15.1, U2.2 (HB)
HB2: C18.1, U3.2 (HB)
HO1: R4.1, U2.3 (HO)
HO2: R10.1, U3.3 (HO)
LO1: R5.1, U2.8 (LO)
LO2: R11.1, U3.8 (LO)
PGND: C13.2, C14.2, C16.2, C17.2, C19.2, C20.2, Q2.1 (S), Q2.2 (S), Q2.3 (S), Q4.1 (S), Q4.2 (S), Q4.3 (S), R7.2, R13.2, RS1.1, U2.7 (VSS), U2.9 (EP), U3.7 (VSS), U3.9 (EP); also elsewhere on the board
PWM_A1: R8.1, U2.5 (HI); also elsewhere on the board
PWM_A2: R9.1, U2.6 (LI); also elsewhere on the board
PWM_E1: R14.1, U3.5 (HI); also elsewhere on the board
PWM_E2: R15.1, U3.6 (LI); also elsewhere on the board
SNB1: C13.1, R2.2
SNB2: C14.1, R3.2
SW1: C15.2, L1.1, Q1.1 (S), Q1.2 (S), Q1.3 (S), Q2.5 (D), R2.1, R6.2, U2.4 (HS)
SW2: C18.2, L1.2, Q3.1 (S), Q3.2 (S), Q3.3 (S), Q4.5 (D), R3.1, R12.2, U3.4 (HS)
VBUS: C1.1, C2.1, C3.1, C4.1, C5.1, C6.1, Q1.5 (D), TP5.1; also elsewhere on the board
VOUT: C7.1, C8.1, C9.1, C10.1, C11.1, C12.1, J2.1, Q3.5 (D), R1.1, TP11.1; also elsewhere on the board
VOUT_N: J2.2, RSH1.1; also elsewhere on the board

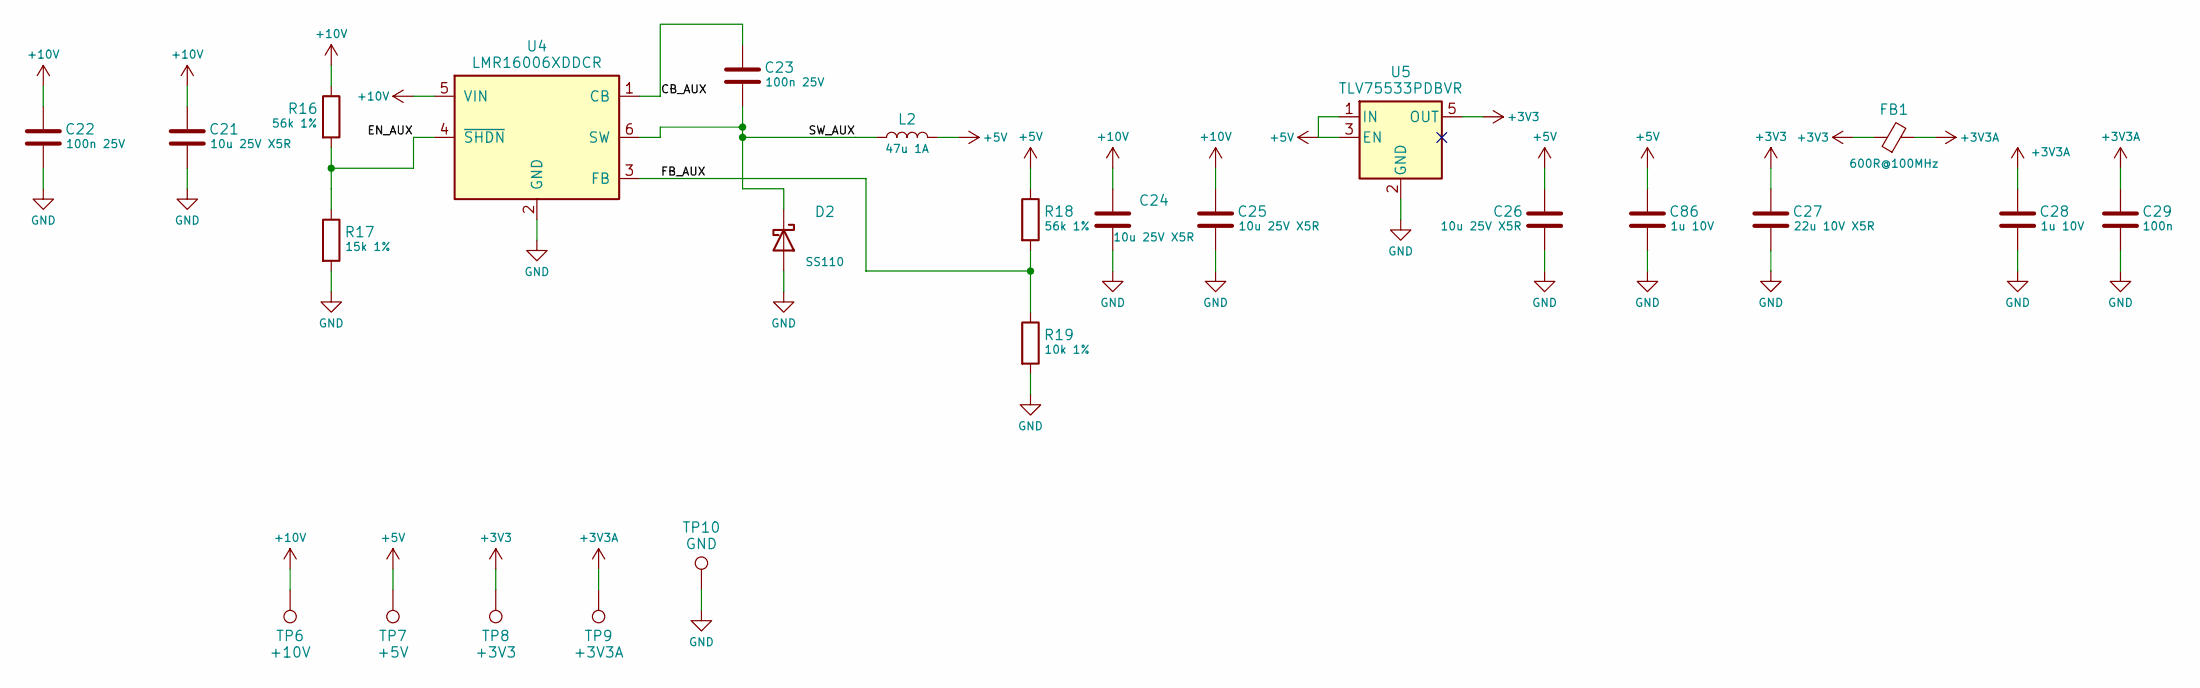
[picture p21: schematic sec_aux.kicad_sch, Secondary aux supplies]

Parts:
C21, C24, C25, C26: 10u 25V X5R; C_0805_2012Metric; MPN 10u 25V X5R; LCSC C15850
C22, C23: 100n 25V; C_0402_1005Metric; MPN 100n 25V; LCSC C307331
C27: 22u 10V X5R; C_0805_2012Metric; MPN 22u 10V X5R; LCSC C45783
C28, C86: 1u 10V; C_0402_1005Metric; MPN 1u 10V; LCSC C20539426
C29: 100n; C_0402_1005Metric; MPN 100n; LCSC C307331
D2: SS110; D_SMA; MPN SS110; LCSC C2482
FB1: 600R@100MHz; L_0603_1608Metric; MPN BLM18KG601SN1D; LCSC C85833
L2: 47u 1A; L_Sunlord_SWPA5040S; MPN FNR5040S470MT; LCSC C167974
R16, R18: 56k 1%; R_0402_1005Metric; MPN 56k 1%; LCSC C25796
R17: 15k 1%; R_0402_1005Metric; MPN 15k 1%; LCSC C25756
R19: 10k 1%; R_0402_1005Metric; MPN 10k 1%; LCSC C2906861
TP6: +10V; TestPoint_Pad_D1.5mm; MPN PCB pad, no part
TP7: +5V; TestPoint_Pad_D1.5mm; MPN PCB pad, no part
TP8: +3V3; TestPoint_Pad_D1.5mm; MPN PCB pad, no part
TP9: +3V3A; TestPoint_Pad_D1.5mm; MPN PCB pad, no part
TP10: GND; TestPoint_Pad_D1.5mm; MPN PCB pad, no part
U4: LMR16006XDDCR; SOT-23-6; MPN LMR16006XDDCR; LCSC C87080
U5: TLV75533PDBVR; SOT-23-5; MPN TLV75533PDBVR; LCSC C404027

Connections:
+3V3: C27.1, FB1.1, TP8.1, U5.5 (OUT); also elsewhere on the board
+3V3A: C28.1, C29.1, FB1.2, TP9.1; also elsewhere on the board
+5V: C26.1, C86.1, L2.2, R18.1, TP7.1, U5.1 (IN), U5.3 (EN); also elsewhere on the board
+10V: C21.1, C22.1, C24.1, C25.1, R16.1, TP6.1, U4.5 (VIN); also elsewhere on the board
CB_AUX: C23.1, U4.1 (CB)
EN_AUX: R16.2, R17.1, U4.4 (~SHDN)
FB_AUX: R18.2, R19.1, U4.3 (FB)
GND: C21.2, C22.2, C24.2, C25.2, C26.2, C27.2, C28.2, C29.2, C86.2, D2.2 (A), R17.2, R19.2, TP10.1, U4.2 (GND), U5.2 (GND); also elsewhere on the board
SW_AUX: C23.2, D2.1 (K), L2.1, U4.6 (SW)
