shousei01/dcdc_converter/01_hardware/kicad_project/DCDC_LLC_4SBB_G474.kicad_pcb

## KiCad design 01_hardware/kicad_project/DCDC_LLC_4SBB_G474.kicad_pcb (continued)

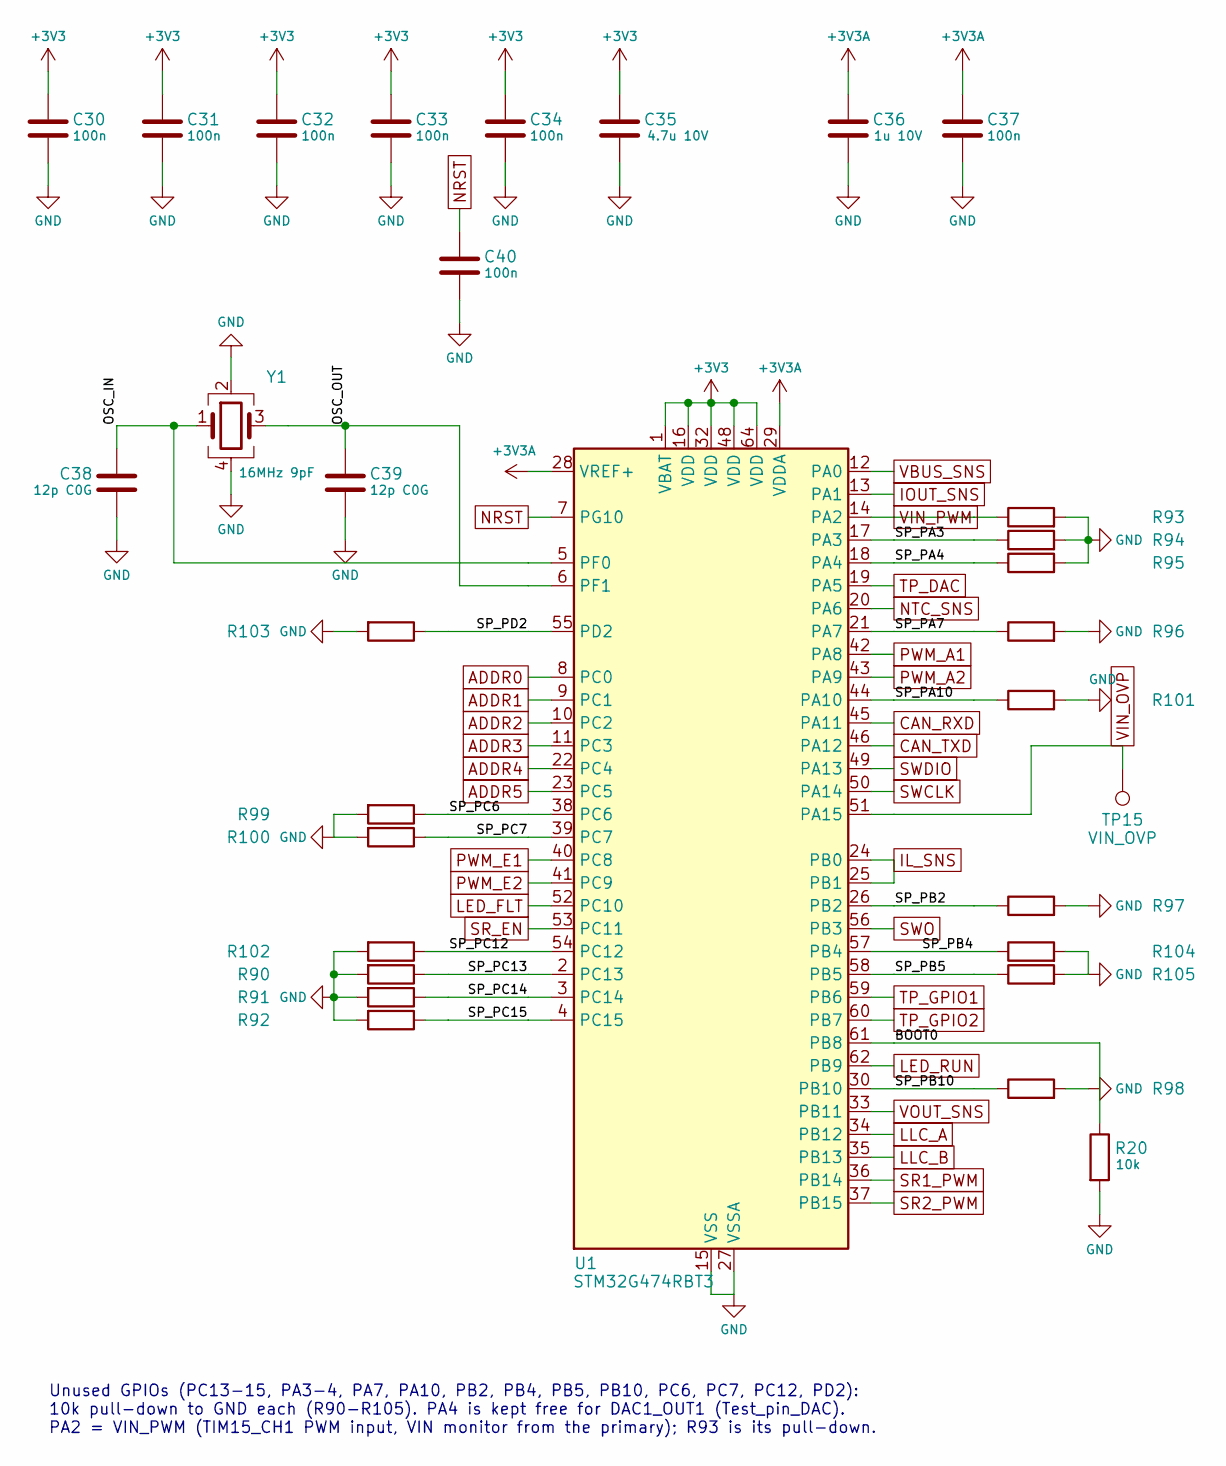
[picture p22: schematic mcu.kicad_sch, STM32G474RBT3 MCU]

Parts:
C30, C31, C32, C33, C34, C37, C40: 100n; C_0402_1005Metric; MPN 100n; LCSC C307331
C35: 4.7u 10V; C_0603_1608Metric; MPN 4.7u 10V; LCSC C19666
C36: 1u 10V; C_0402_1005Metric; MPN 1u 10V; LCSC C20539426
C38, C39: 12p C0G; C_0402_1005Metric; MPN 12p C0G; LCSC C1547
R20, R90, R91, R92, R93, R94, R95, R96, R97, R98, R99, R100, R101, R102, R103, R104, R105: 10k; R_0402_1005Metric; MPN 10k; LCSC C2906861
TP15: VIN_OVP; TestPoint_Pad_D1.5mm; MPN PCB pad, no part
U1: STM32G474RBT3; LQFP-64_10x10mm_P0.5mm; MPN STM32G474RBT3; LCSC C1235414
Y1: 16MHz 9pF; Crystal_SMD_3225-4Pin_3.2x2.5mm; MPN X322516MLB4SI; LCSC C13738

Connections:
+3V3: C30.1, C31.1, C32.1, C33.1, C34.1, C35.1, U1.1 (VBAT), U1.16 (VDD), U1.32 (VDD), U1.48 (VDD), U1.64 (VDD); also elsewhere on the board
+3V3A: C36.1, C37.1, U1.28 (VREF+), U1.29 (VDDA); also elsewhere on the board
ADDR0: U1.8 (PC0); also elsewhere on the board
ADDR1: U1.9 (PC1); also elsewhere on the board
ADDR2: U1.10 (PC2); also elsewhere on the board
ADDR3: U1.11 (PC3); also elsewhere on the board
ADDR4: U1.22 (PC4); also elsewhere on the board
ADDR5: U1.23 (PC5); also elsewhere on the board
BOOT0: R20.1, U1.61 (PB8)
CAN_RXD: U1.45 (PA11); also elsewhere on the board
CAN_TXD: U1.46 (PA12); also elsewhere on the board
GND: C30.2, C31.2, C32.2, C33.2, C34.2, C35.2, C36.2, C37.2, C38.2, C39.2, C40.2, R20.2, R90.2, R91.2, R92.2, R93.2, R94.2, R95.2, R96.2, R97.2, R98.2, R99.2, R100.2, R101.2, R102.2, R103.2, R104.2, R105.2, U1.15 (VSS), U1.27 (VSSA), U1.31 (VSS), U1.47 (VSS), U1.63 (VSS), Y1.2, Y1.4; also elsewhere on the board
IL_SNS: U1.24 (PB0), U1.25 (PB1); also elsewhere on the board
IOUT_SNS: U1.13 (PA1); also elsewhere on the board
LED_FLT: U1.52 (PC10); also elsewhere on the board
LED_RUN: U1.62 (PB9); also elsewhere on the board
LLC_A: U1.34 (PB12); also elsewhere on the board
LLC_B: U1.35 (PB13); also elsewhere on the board
NRST: C40.1, U1.7 (PG10); also elsewhere on the board
NTC_SNS: U1.20 (PA6); also elsewhere on the board
OSC_IN: C38.1, U1.5 (PF0), Y1.1
OSC_OUT: C39.1, U1.6 (PF1), Y1.3
PWM_A1: U1.42 (PA8); also elsewhere on the board
PWM_A2: U1.43 (PA9); also elsewhere on the board
PWM_E1: U1.40 (PC8); also elsewhere on the board
PWM_E2: U1.41 (PC9); also elsewhere on the board
SP_PA3: R94.1, U1.17 (PA3)
SP_PA4: R95.1, U1.18 (PA4)
SP_PA7: R96.1, U1.21 (PA7)
SP_PA10: R101.1, U1.44 (PA10)
SP_PB2: R97.1, U1.26 (PB2)
SP_PB4: R104.1, U1.57 (PB4)
SP_PB5: R105.1, U1.58 (PB5)
SP_PB10: R98.1, U1.30 (PB10)
SP_PC6: R99.1, U1.38 (PC6)
SP_PC7: R100.1, U1.39 (PC7)
SP_PC12: R102.1, U1.54 (PC12)
SP_PC13: R90.1, U1.2 (PC13)
SP_PC14: R91.1, U1.3 (PC14)
SP_PC15: R92.1, U1.4 (PC15)
SP_PD2: R103.1, U1.55 (PD2)
SR1_PWM: U1.36 (PB14); also elsewhere on the board
SR2_PWM: U1.37 (PB15); also elsewhere on the board
SR_EN: U1.53 (PC11); also elsewhere on the board
SWCLK: U1.50 (PA14); also elsewhere on the board
SWDIO: U1.49 (PA13); also elsewhere on the board
SWO: U1.56 (PB3); also elsewhere on the board
TP_DAC: U1.19 (PA5); also elsewhere on the board
TP_GPIO1: U1.59 (PB6); also elsewhere on the board
TP_GPIO2: U1.60 (PB7); also elsewhere on the board
VBUS_SNS: U1.12 (PA0); also elsewhere on the board
VIN_OVP: TP15.1, U1.51 (PA15); also elsewhere on the board
VIN_PWM: R93.1, U1.14 (PA2); also elsewhere on the board
VOUT_SNS: U1.33 (PB11); also elsewhere on the board

Notes on the sheet:
Unused GPIOs (PC13-15, PA3-4, PA7, PA10, PB2, PB4, PB5, PB10, PC6, PC7, PC12, PD2): 10k pull-down to GND each (R90-R105). PA4 is kept free for DAC1_OUT1 (Test_pin_DAC). PA2 = VIN_PWM (TIM15_CH1 PWM input, VIN monitor from the primary); R93 is its pull-down.

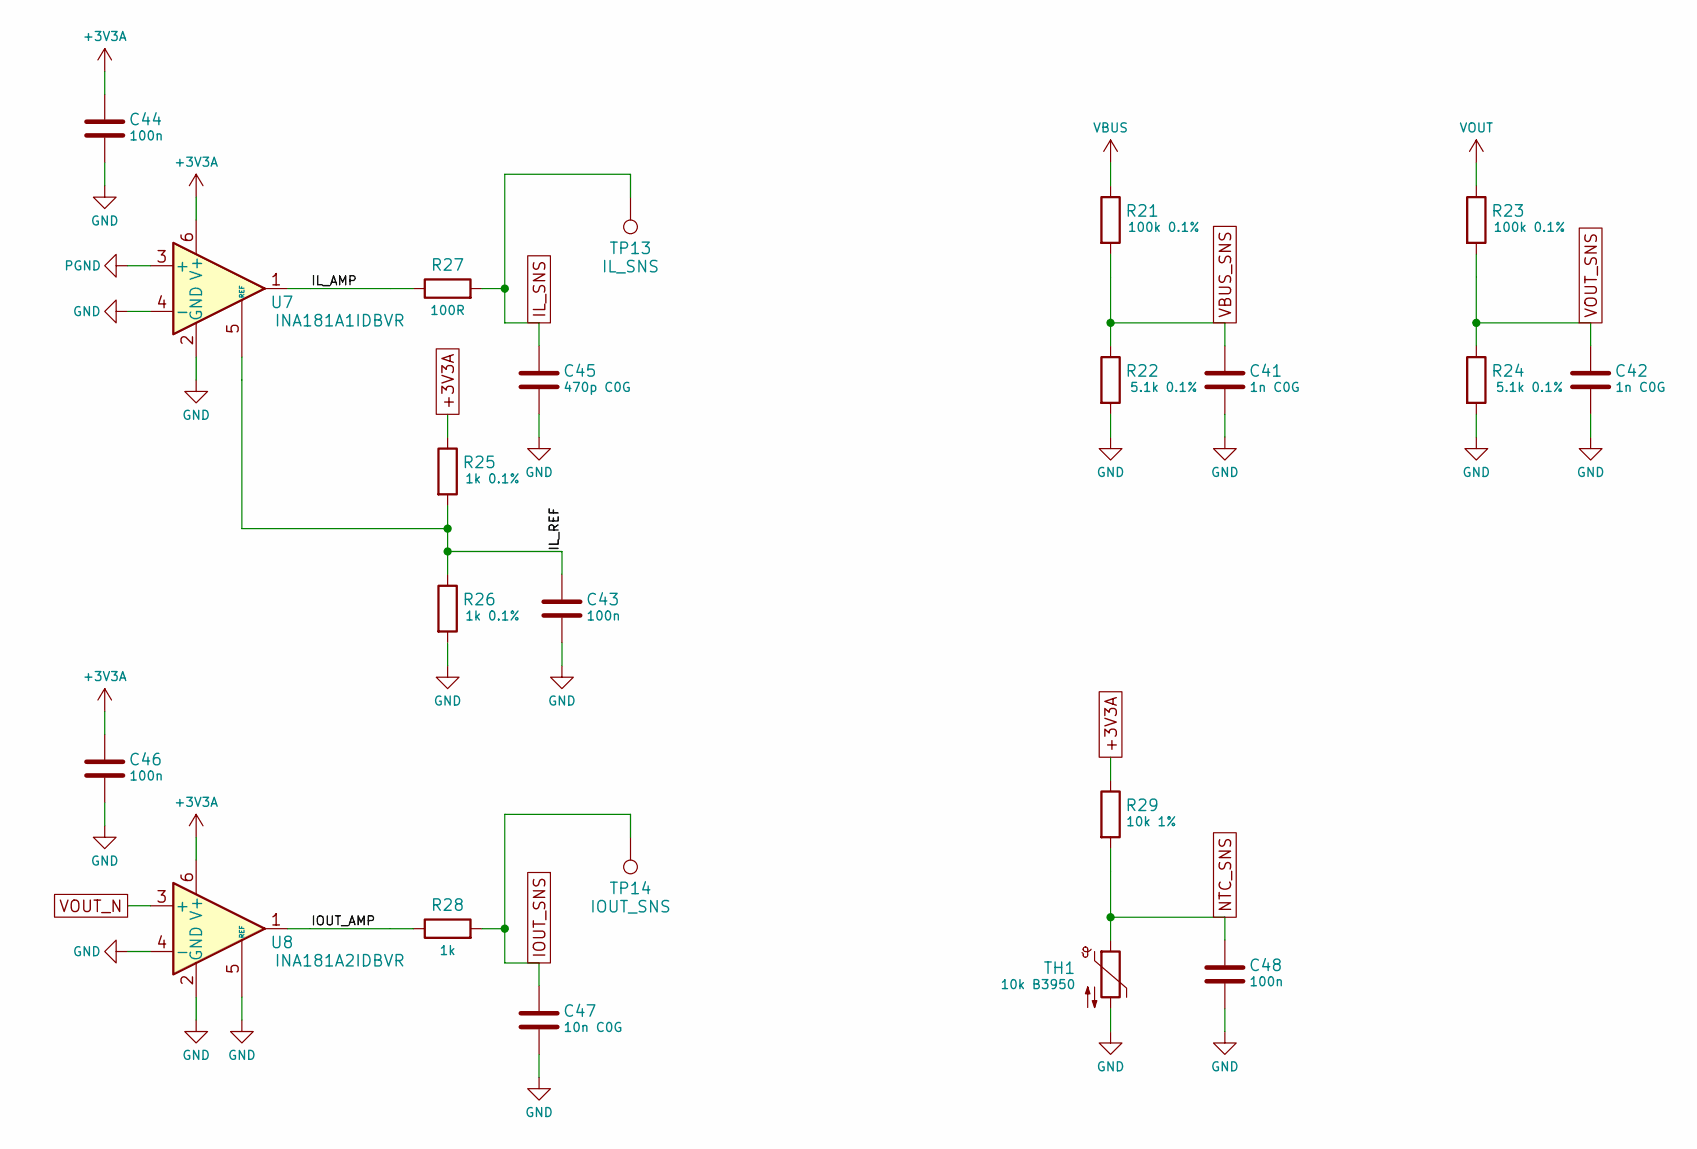
[picture p23: schematic sense.kicad_sch, Sensing - VBUS, VOUT, inductor and output current, NTC]

Parts:
C41, C42: 1n C0G; C_0402_1005Metric; MPN 1n C0G; LCSC C113780
C43, C44, C46, C48: 100n; C_0402_1005Metric; MPN 100n; LCSC C307331
C45: 470p C0G; C_0402_1005Metric; MPN 470p C0G; LCSC C106259
C47: 10n C0G; C_0402_1005Metric; MPN 10n C0G; LCSC C22400107
R21, R23: 100k 0.1%; R_0603_1608Metric; MPN 100k 0.1%; LCSC C122538
R22, R24: 5.1k 0.1%; R_0402_1005Metric; MPN 5.1k 0.1%; LCSC C186154
R25, R26: 1k 0.1%; R_0402_1005Metric; MPN 1k 0.1%; LCSC C186137
R27: 100R; R_0402_1005Metric; MPN 100R; LCSC C25076
R28: 1k; R_0402_1005Metric; MPN 1k; LCSC C11702
R29: 10k 1%; R_0402_1005Metric; MPN 10k 1%; LCSC C2906861
TH1: 10k B3950; R_0603_1608Metric; MPN 10k B3950; LCSC C2892547
TP13: IL_SNS; TestPoint_Pad_D1.5mm; MPN PCB pad, no part
TP14: IOUT_SNS; TestPoint_Pad_D1.5mm; MPN PCB pad, no part
U7: INA181A1IDBVR; SOT-23-6; MPN INA181A1IDBVR; LCSC C2058943
U8: INA181A2IDBVR; SOT-23-6; MPN INA181A2IDBVR; LCSC C2058784

Connections:
+3V3A: C44.1, C46.1, R25.1, R29.1, U7.6 (V+), U8.6 (V+); also elsewhere on the board
GND: C41.2, C42.2, C43.2, C44.2, C45.2, C46.2, C47.2, C48.2, R22.2, R24.2, R26.2, TH1.2, U7.2 (GND), U7.4 (-), U8.2 (GND), U8.4 (-), U8.5 (REF); also elsewhere on the board
IL_AMP: R27.1, U7.1
IL_REF: C43.1, R25.2, R26.1, U7.5 (REF)
IL_SNS: C45.1, R27.2, TP13.1; also elsewhere on the board
IOUT_AMP: R28.1, U8.1
IOUT_SNS: C47.1, R28.2, TP14.1; also elsewhere on the board
NTC_SNS: C48.1, R29.2, TH1.1; also elsewhere on the board
PGND: U7.3 (+); also elsewhere on the board
VBUS: R21.1; also elsewhere on the board
VBUS_SNS: C41.1, R21.2, R22.1; also elsewhere on the board
VOUT: R23.1; also elsewhere on the board
VOUT_N: U8.3 (+); also elsewhere on the board
VOUT_SNS: C42.1, R23.2, R24.1; also elsewhere on the board

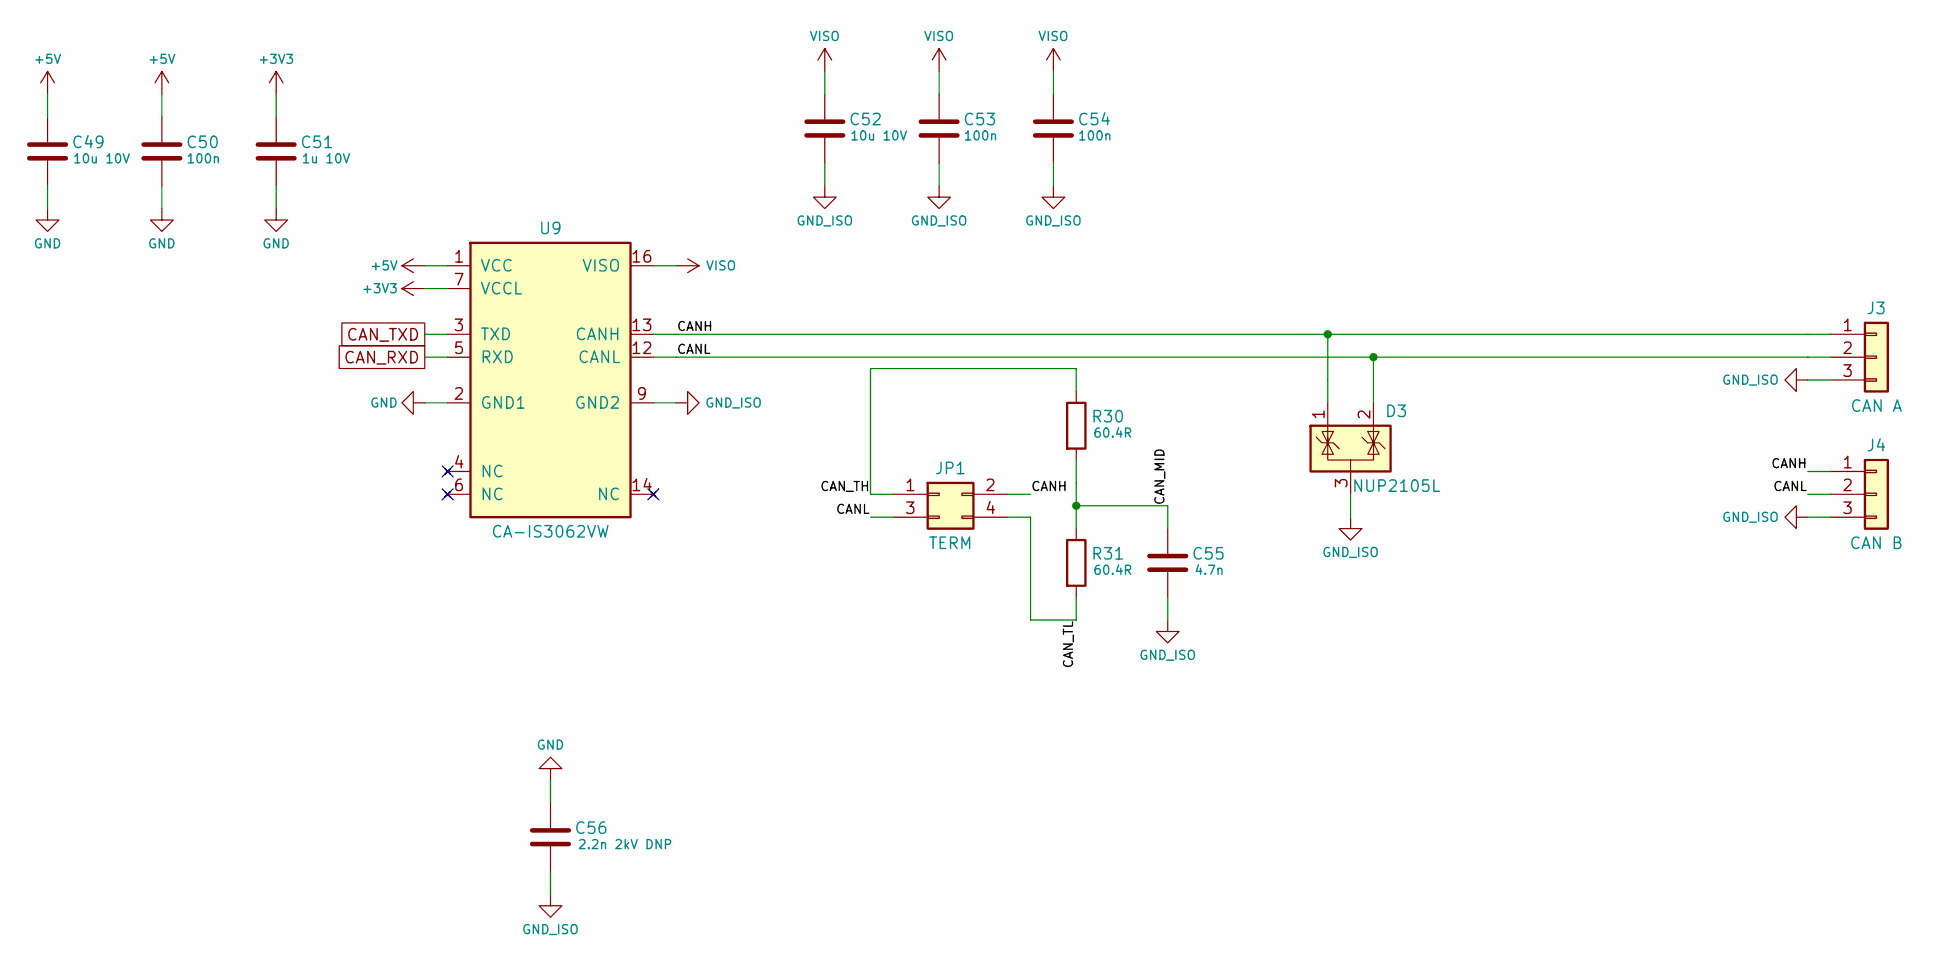
[picture p24: schematic can.kicad_sch, Isolated CAN]

Parts:
C49, C52: 10u 10V; C_0805_2012Metric; MPN 10u 10V; LCSC C15850
C50, C53, C54: 100n; C_0402_1005Metric; MPN 100n; LCSC C307331
C51: 1u 10V; C_0402_1005Metric; MPN 1u 10V; LCSC C20539426
C55: 4.7n; C_0603_1608Metric; MPN 4.7n; LCSC C53987
C56: 2.2n 2kV DNP; C_Disc_D8.0mm_W5.0mm_P7.50mm; MPN 2.2n 2kV DNP
D3: NUP2105L; SOT-23; MPN NUP2105LT1G; LCSC C14486
J3: CAN A; PinHeader_1x03_P2.54mm_Vertical; MPN PZ254V-11-03P-A40; LCSC C42419910
J4: CAN B; PinHeader_1x03_P2.54mm_Vertical; MPN PZ254V-11-03P-A40; LCSC C42419910
JP1: TERM; PinHeader_2x02_P2.54mm_Vertical; MPN PZ254V-12-04P-A40; LCSC C45384660
R30, R31: 60.4R; R_0603_1608Metric; MPN 60.4R; LCSC C2933247
U9: CA-IS3062VW; SOIC-16W_7.5x10.3mm_P1.27mm; MPN CA-IS3062VW; LCSC C5338808

Connections:
+3V3: C51.1, U9.7 (VCCL); also elsewhere on the board
+5V: C49.1, C50.1, U9.1 (VCC); also elsewhere on the board
CANH: D3.1 (K), J3.1, J4.1, JP1.2, U9.13 (CANH)
CANL: D3.2 (K), J3.2, J4.2, JP1.3, U9.12 (CANL)
CAN_MID: C55.1, R30.2, R31.1
CAN_RXD: U9.5 (RXD); also elsewhere on the board
CAN_TH: JP1.1, R30.1
CAN_TL: JP1.4, R31.2
CAN_TXD: U9.3 (TXD); also elsewhere on the board
GND: C49.2, C50.2, C51.2, C56.1, U9.2 (GND1), U9.8 (GND1); also elsewhere on the board
GND_ISO: C52.2, C53.2, C54.2, C55.2, C56.2, D3.3 (A), J3.3, J4.3, U9.9 (GND2), U9.10 (GND2), U9.15 (GND2)
VISO: C52.1, C53.1, C54.1, U9.11 (VISO), U9.16 (VISO)

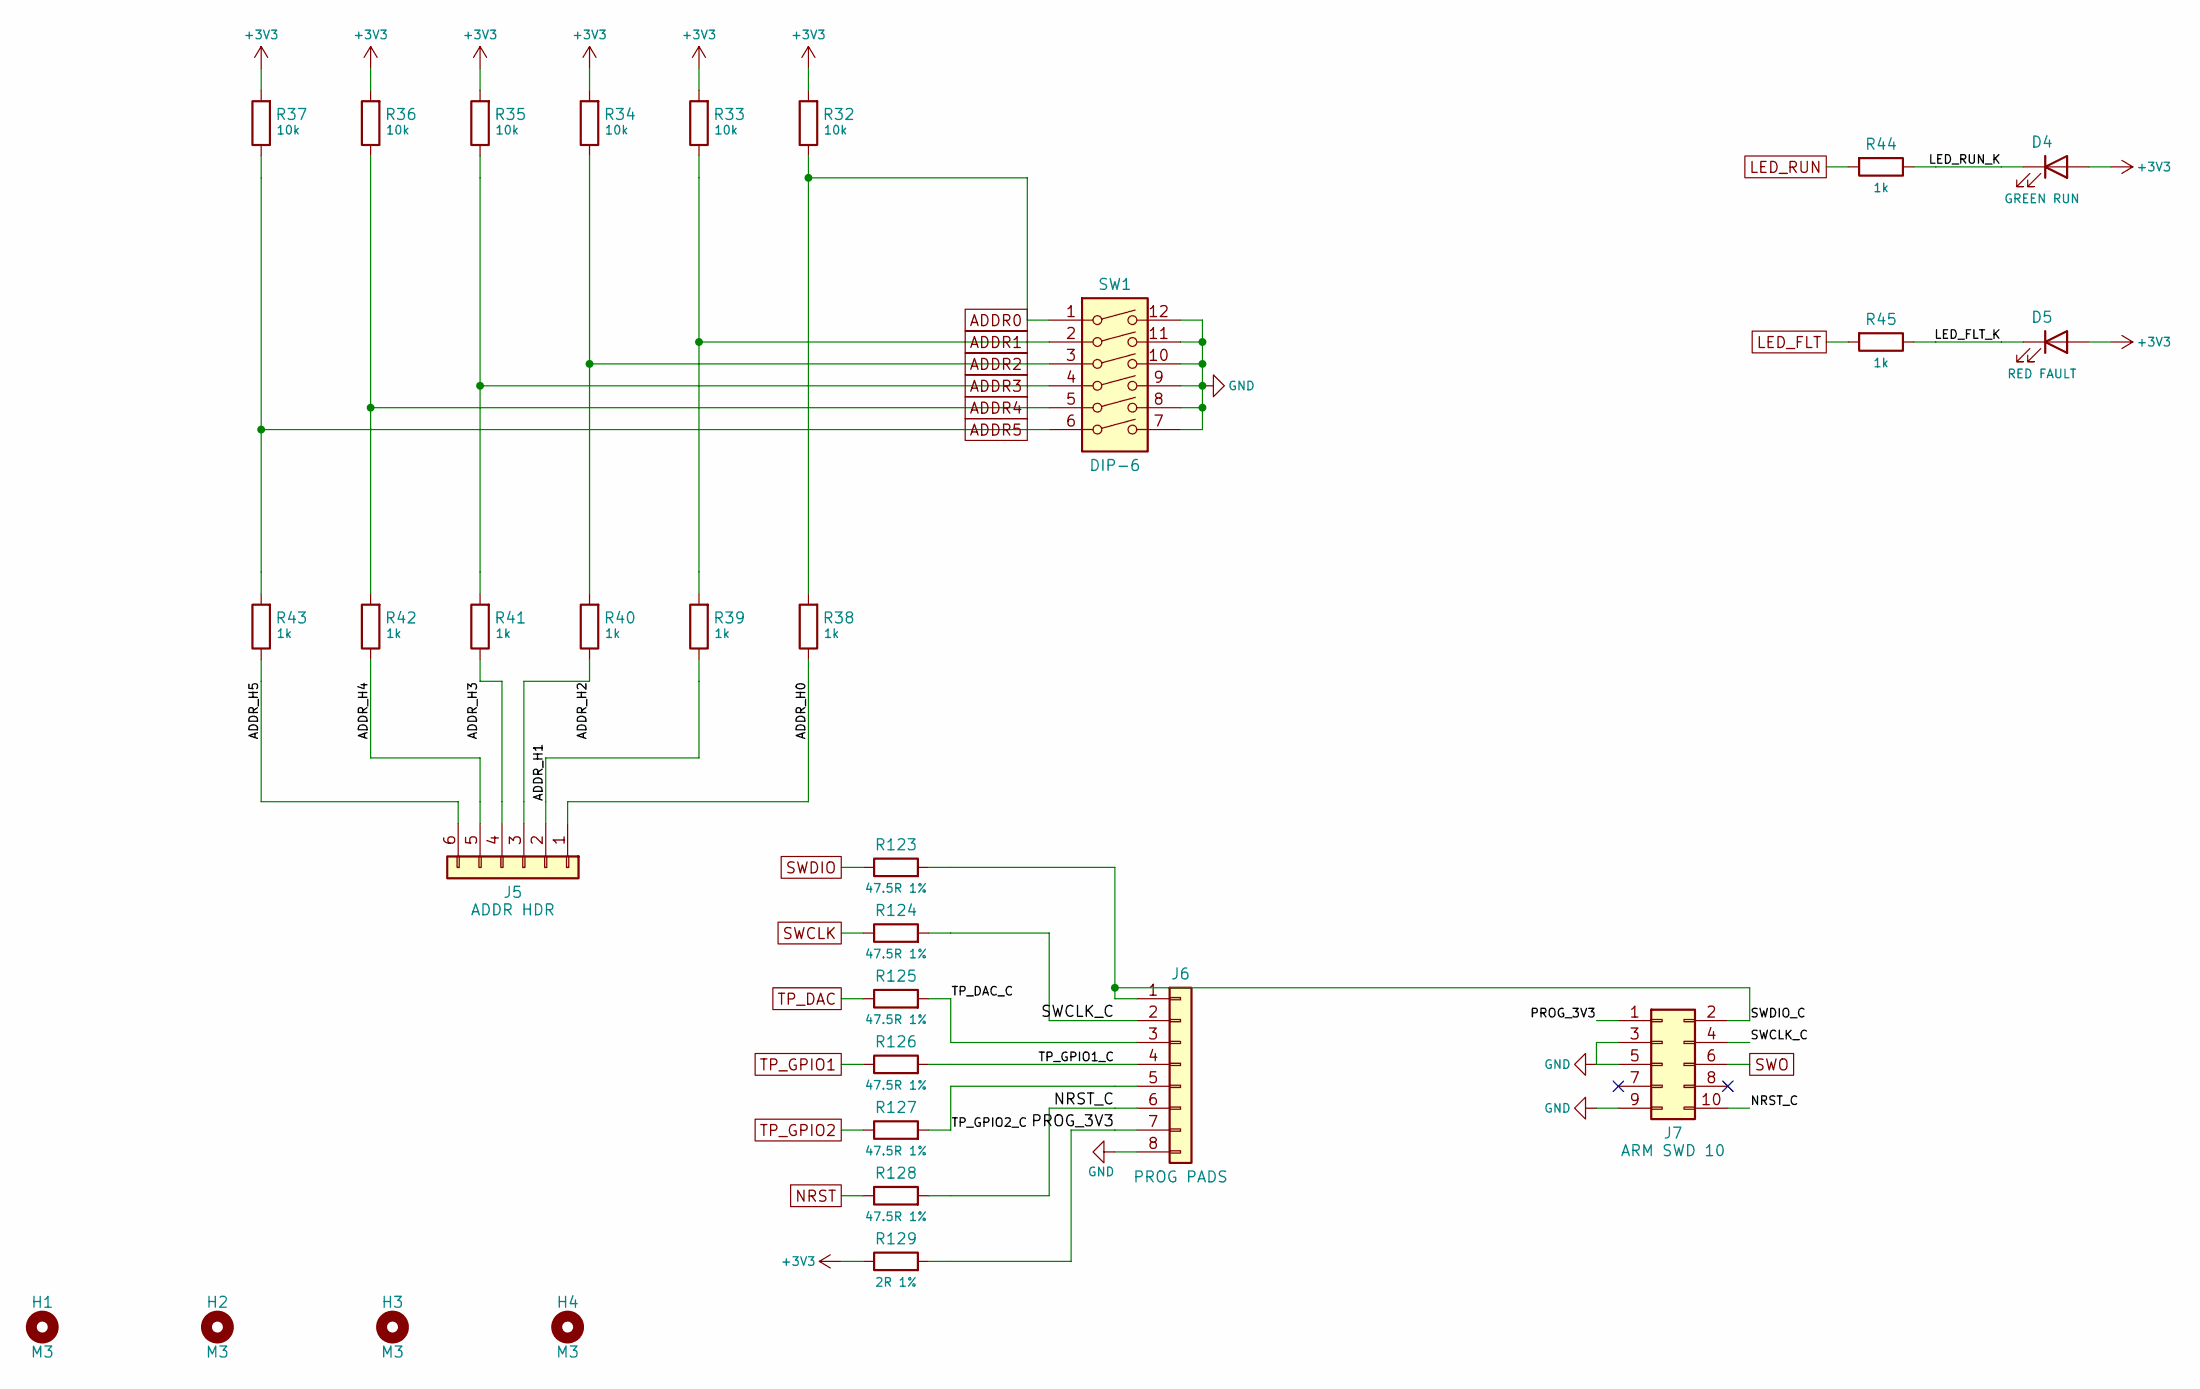
[picture p25: schematic io.kicad_sch, Address switch, programming pads, ARM SWD, LEDs]

Parts:
D4: GREEN RUN; LED_0603_1608Metric; MPN GREEN RUN; LCSC C12624
D5: RED FAULT; LED_0603_1608Metric; MPN RED FAULT; LCSC C2286
H1, H2, H3, H4: M3; MountingHole_3.2mm_M3; MPN no part (M3 standoff hole)
J5: ADDR HDR; PinHeader_1x06_P2.54mm_Vertical; MPN PZ254V-11-06P-A40; LCSC C42419913
J6: PROG PADS; TestPads_1x08_P2.54mm_D2.0mm; MPN PROG PADS
J7: ARM SWD 10; PinHeader_2x05_P1.27mm_Vertical_SMD; MPN HX PZ1.27-2x5P TP; LCSC C41376037
R32, R33, R34, R35, R36, R37: 10k; R_0402_1005Metric; MPN 10k; LCSC C2906861
R38, R39, R40, R41, R42, R43, R44, R45: 1k; R_0402_1005Metric; MPN 1k; LCSC C11702
R123, R124, R125, R126, R127, R128: 47.5R 1%; R_0402_1005Metric; MPN 0402WGF475JTCE; LCSC C82290
R129: 2R 1%; R_0603_1608Metric; MPN FRC0603F2R00TS; LCSC C2933191
SW1: DIP-6; SW_DIP_SPSTx06_Slide_6.7x16.8mm_W8.61mm_P2.54mm_LowProfile; MPN DIP-6; LCSC C6331172

Connections:
+3V3: D4.2 (A), D5.2 (A), R32.2, R33.2, R34.2, R35.2, R36.2, R37.2, R129.1; also elsewhere on the board
ADDR0: R32.1, R38.2, SW1.1; also elsewhere on the board
ADDR1: R33.1, R39.2, SW1.2; also elsewhere on the board
ADDR2: R34.1, R40.2, SW1.3; also elsewhere on the board
ADDR3: R35.1, R41.2, SW1.4; also elsewhere on the board
ADDR4: R36.1, R42.2, SW1.5; also elsewhere on the board
ADDR5: R37.1, R43.2, SW1.6; also elsewhere on the board
ADDR_H0: J5.1, R38.1
ADDR_H1: J5.2, R39.1
ADDR_H2: J5.3, R40.1
ADDR_H3: J5.4, R41.1
ADDR_H4: J5.5, R42.1
ADDR_H5: J5.6, R43.1
GND: J6.8, J7.3, J7.5, J7.9, SW1.7, SW1.8, SW1.9, SW1.10, SW1.11, SW1.12; also elsewhere on the board
LED_FLT: R45.2; also elsewhere on the board
LED_FLT_K: D5.1 (K), R45.1
LED_RUN: R44.2; also elsewhere on the board
LED_RUN_K: D4.1 (K), R44.1
NRST: R128.1; also elsewhere on the board
NRST_C: J6.6, J7.10, R128.2
PROG_3V3: J6.7, J7.1, R129.2
SWCLK: R124.1; also elsewhere on the board
SWCLK_C: J6.2, J7.4, R124.2
SWDIO: R123.1; also elsewhere on the board
SWDIO_C: J6.1, J7.2, R123.2
SWO: J7.6; also elsewhere on the board
TP_DAC: R125.1; also elsewhere on the board
TP_DAC_C: J6.3, R125.2
TP_GPIO1: R126.1; also elsewhere on the board
TP_GPIO1_C: J6.4, R126.2
TP_GPIO2: R127.1; also elsewhere on the board
TP_GPIO2_C: J6.5, R127.2

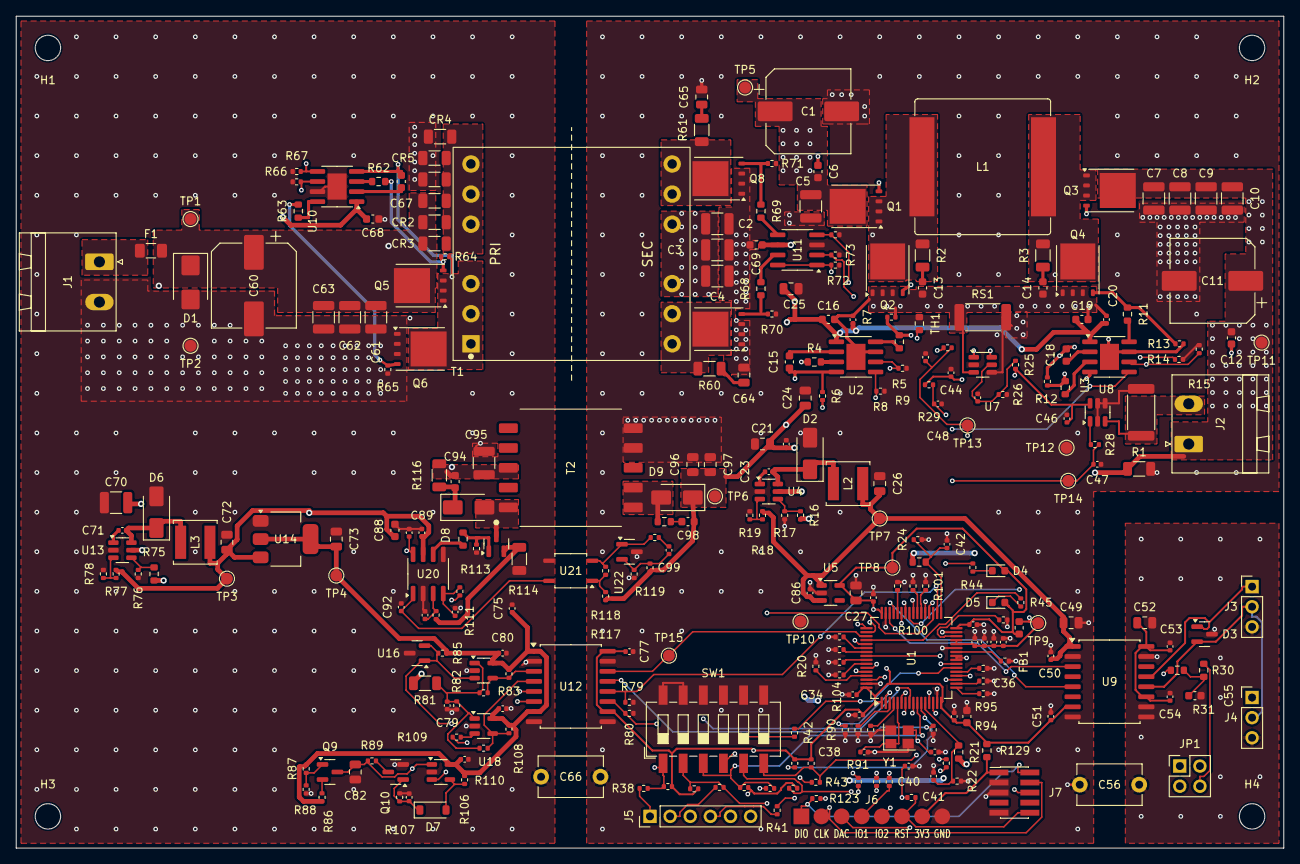
[picture p26: board DCDC_LLC_4SBB_G474.kicad_pcb from above]

Board: 4 copper layers, 160.0 x 105.0 mm, 291 parts (0 on the bottom side), 155 nets.
