shousei01/dcdc_converter/04_scripts/vin_center_l3.py

"""Rev D order prep: move the VIN track under L3 to x = 30.0 mm (centred between the 5040 pads, 0.4 mm each side).
Applied by hand in pcbnew Python on 18 Oct 2026: segments at x = 29.806 below y = 60 moved to x = 30.0, with a
jog (29.806, 64.5) -> (30.0, 64.7). Kept for the record; the board in kicad_project already contains it."""
