shousei01/dcdc_converter/(commit log)

2026-10-18 update D
    [BOM_DCDC_LLC_4SBB_G474.csv, BOM_JLCPCB_DCDC_LLC_4SBB_G474.csv, DCDC_LLC_4SBB_G474.kicad_pcb, DCDC_LLC_4SBB_G474.kicad_sch, can.kicad_sch, io.kicad_sch, llc.kicad_sch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]
2026-10-18 add CAN termination res jumper
    [BOM_DCDC_LLC_4SBB_G474.csv, BOM_JLCPCB_DCDC_LLC_4SBB_G474.csv, DCDC_LLC_4SBB_G474.kicad_pcb, DCDC_LLC_4SBB_G474.kicad_sch, can.kicad_sch, io.kicad_sch, llc.kicad_sch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]
2026-10-18 update silkscreen
    [DCDC_LLC_4SBB_G474.kicad_pcb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]
2026-10-18 T1: footprint to vendor PQ2620 6+6 bobbin, winding guide update
    - TX_PQ2620_12P: 25.4 mm row-to-row (was 22.5 placeholder), 1.1 mm holes
    for 0.70 mm pins, 27 x 29 mm body outline/courtyard
    - PCB: track stubs to the new T1 pads; VBUS (In2) and LLC_HI_P/LO_P (In2)
    rerouted clear of the moved pins; CR1-CR6 -0.4 mm, Q7/Q8 +0.1 mm so
    courtyards clear the larger bobbin; C2-C4 refs to F.Fab only
    - DRC clean, netlist parity and isolation check pass
    - Winding guide: bobbin data, radial fit check (foil primary recommended,
    litz 0.1x200 does not fit), materials updated
    - Regenerated gerbers, CPL, EasyEDA import, PCB layer PDF
    Claude-Sessi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
    [DCDC_LLC_4SBB_G474.kicad_pcb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]
2026-10-18 T1: footprint fits PQ2620 and PQ2625 bobbins; SW1 address silkscreen
    - TX_PQ2620_12P: 1.2 mm holes (0.70 / 0.80 mm pins, 25.4 / 25.5 mm rows),
    outline and courtyard for the 29.8 x 26.7 mm PQ2625 base
    - Room around T1: T1 +0.1 mm, CR1-CR6 -0.7 mm total, Q7/Q8 +0.68 mm total
    with their gate/GND fan-out, R61 +0.3 mm; HB_SW driver return 1.5 -> 0.8 mm,
    GND bus beside Q7 moved to x=92.72, Q8 source strap 2.5 -> 1.6 mm,
    three source-side GND vias stepped out of the pads, three removed
    - SW1 silkscreen: A0..A5 per switch and "ON=1"; R80 reference moved
    - DRC clean (incl. courtyards), netlist parity and isolation check pass
    Co-Author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
    [DCDC_LLC_4SBB_G474.kicad_pcb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]
2026-10-18 Winding guide: 3D view clockwise like the 2D pin map, real bobbin size
    - 3D helix and "CW from top" arrow now turn clockwise seen from the top
    (they were counter-clockwise, contradicting sections 3 and 6)
    - 3D bobbin: 25.4 mm rows, 27 x 29 mm base, tube 14.1 / flange 20.8 mm,
    PQ26 core; labels no longer clipped, camera pulled back
    - Section 3: note on T1 orientation on the PCB (primary = left column,
    pin 1 at its bottom end)
    - Materials: footprint also takes PQ2625 6+6, 1.2 mm holes
    Claude-Session: https://claude.ai/code/session_01A35wrnwFKLPSaRSxxHs471
2026-10-18 Layout review: power path, switch nodes, gate loops, Kelvin, clean-up
    - VOUT pour C11 -> J2 (was one 1.0 mm track; ~10 -> ~3.5 mOhm)
    - CR1-CR6: VIN / GNDP pours on the left pads, CR_MID pour over the right pads
    - SW1/SW2 pours trimmed to L1 pad + FET pins/tab (282/271 -> 213/211 mm2)
    - High-side gate loops: SW1 return beside G1 on In2 (~85 -> ~15 mm2),
    SW2 return beside G3 on B.Cu and G3 0.25 -> 0.5 mm (~47 -> ~18 mm2),
    HB_SW return beside G5 on B.Cu (~17 -> ~8 mm2)
    - U8 sense taps moved inside the RSH1 pads (Kelvin)
    - Router staircases straightened: 2906 -> 1810 segments, clearance-checked
    - 320 ground stitching vias (5 mm grid, only where the ground net is poured
    on all four layers)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
    [DCDC_LLC_4SBB_G474.kicad_pcb]
2026-10-18 ADDR2 duplicate route removed; contained duplicate segments cleaned
    - ADDR2: MCU branch ran parallel to the SW1-R34-R40 track; it now ends
    where it meets that track (single tree)
    - 90 same-net segments lying fully inside another track removed
    (no copper change), 5 tiny dangling stubs removed
    - DRC clean, netlist parity unchanged
    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
    [DCDC_LLC_4SBB_G474.kicad_pcb]
2026-10-18 VIN monitor: sawtooth/comparator PWM over spare isolator channel to PA2 (TIM15_CH1)
    - Primary: PNP current-source ramp (~5 ms) into 47 nF C0G, U17 reset detector,
    U18 PWM comparator vs OVP_DIV; R81/R82 now 0.1 %
    - U12 VI2->VO2 carries VIN_PWM to PA2; R93 is its pull-down
    - PCB: new block placed/routed below U15/U16, R106 moved for courtyard,
    GNDP island vias, silkscreen for new parts; DRC clean, netlist parity OK
    - Outputs regenerated (BOM, Gerbers, CPL, EasyEDA, PDFs, pin-map)
    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
    [BOM_DCDC_LLC_4SBB_G474.csv, BOM_JLCPCB_DCDC_LLC_4SBB_G474.csv, DCDC_LLC_4SBB_G474.kicad_pcb, DCDC_LLC_4SBB_G474.kicad_sch, can.kicad_sch, io.kicad_sch, llc.kicad_sch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]
2026-10-18 Review fixes: VIN monitor linearity and reset, full-scale summary, design notes
    - U18 inputs swapped (IN+ = OVP_DIV, IN- = RAMP via R109 1k); R110 4.7M
    hysteresis now on the divider, not the ramp (old 1M path bent the ramp:
    +12.5 % error at 12 V; now < 0.02 % in simulation)
    - Reset pulse hardened: C81 220p C0G, R107 100k so C82 always fully discharges
    - OVP trip corrected to 50.26 V rising / 49.83 V falling; TL431A noted as 1 %
    - PCB re-routed locally, values synced to schematic; DRC clean, parity OK,
    isolation 4.0 mm
    - Design notes: full-scale and threshold summary, VIN monitor firmware formula
    and two-point calibration; exported to DOCX and PDF
    - Pin-map, BOM, Gerbers, CPL, EasyEDA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
    [BOM_DCDC_LLC_4SBB_G474.csv, BOM_JLCPCB_DCDC_LLC_4SBB_G474.csv, DCDC_LLC_4SBB_G474.kicad_pcb, DCDC_LLC_4SBB_G474.kicad_sch, can.kicad_sch, io.kicad_sch, llc.kicad_sch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]
2026-10-18 External REF3030 ADC reference; full review and documentation update
    - U19 REF3030AIDBZR (3.000 V +/-0.2 %, LCSC C38423) + C85 drive VREF+ (new net
    VREF_ADC); VREF+ separated from VDDA; R25 (IL zero) and R29 (NTC pull-up)
    moved to VREF_ADC so those channels are ratiometric
    - Full scales: VBUS/VOUT 61.8 V, IL +/-18.75 A, IOUT 6.0 A, DAC/COMP 0-3.0 V
    - PCB: U19/C85 placed and routed, pins 28/29 hand-routed; DRC clean, parity
    OK, isolation 4.0 mm
    - Design notes (DOCX/PDF), root and firmware READMEs, pin-map, layout review
    image, BOM, Gerbers, CPL, EasyEDA zip and PDFs updated
    Claude-Session: https://claude.ai/code/session_01A35wrn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
    [BOM_DCDC_LLC_4SBB_G474.csv, BOM_JLCPCB_DCDC_LLC_4SBB_G474.csv, DCDC_LLC_4SBB_G474.kicad_pcb, DCDC_LLC_4SBB_G474.kicad_sch, can.kicad_sch, io.kicad_sch, llc.kicad_sch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]
2026-10-18 Comply with JLCPCB 4-layer capabilities (2 oz outer)
    - PTH pad to track >= 0.28 mm: J5 ADDR_H3 (F.Cu) and ADDR_H2 (In2) re-routed,
    J3/J4 CAN In2 runs 0.4 mm, unused inner annular rings removed on J3/J4/J5
    - Silkscreen: all text >= 1.0 mm high, 0.15 mm stroke; only 2 references moved
    - New kicad_dru with the JLC limits as custom DRC rules; DRC 0 errors / 0
    warnings with them loaded, parity OK, isolation 4.0 mm
    - Gerbers, CPL, PCB PDF, EasyEDA zip, design notes and README updated
    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
    [DCDC_LLC_4SBB_G474.kicad_pcb]
2026-10-18 Rev D order prep: common F1/L2/L3 parts, JLC-checked LCSC numbers, assembly files
    - F1: 2512 -> 1206 7 A 63 V fuse (Littelfuse 0458007.DR, C206980; 2nd source Schurter 3413.0326.11)
    - L2/L3: SRP5030 -> 5040 shielded 47 uH (SWPA5040S470MT, C86617; 2nd source SRN5040-470M, NRS5040T470MMGK)
    - EN_AUX re-routed off the L2 pad gap; VIN track centred between the L3 pads (0.4 mm each side)
    - LCSC numbers checked in the JLCPCB library for every assembled part (design.py JLC_LCSC),
    written to the BOMs, schematic and PCB fields
    - New JLC assembly upload files DCDC_JLC_BOM.csv / DCDC_JLC_CPL.csv (217 parts; U1, T1,
    connectors, headers and SW1 hand-soldered) and jlc_order_files.py to rebuild them
    - 0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
    [BOM_DCDC_LLC_4SBB_G474.csv, BOM_JLCPCB_DCDC_LLC_4SBB_G474.csv, DCDC_JLC_BOM.csv, DCDC_LLC_4SBB_G474.kicad_pcb, DCDC_LLC_4SBB_G474.kicad_sch, can.kicad_sch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]
2026-10-18 JLC assembly files: add SW1, merge duplicate LCSC lines, fix rotations
    - SW1 DIP switch added to BOM/CPL (C6331172) and given an LCSC field in
    schematic and PCB
    - BOM lines sharing an LCSC number are merged (JLC unselects duplicates)
    - CPL rotations corrected against JLC pin-1 markers; NCEP0160AG (Q2/Q3/Q5/Q6)
    centroid offset 1.0 mm for the JLC model
    - U1 hand-soldered (own sample); DNP snubbers/Y-caps left out of CPL
    - U12 stays CA-IS3642LVW (pre-order); TI ISOW7842FDWER C2861496 is a
    pin-compatible alternative
    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
    [BOM_DCDC_LLC_4SBB_G474.csv, BOM_JLCPCB_DCDC_LLC_4SBB_G474.csv, DCDC_JLC_BOM.csv, DCDC_LLC_4SBB_G474.kicad_pcb, io.kicad_sch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]
2026-10-18 JLC CPL: rotate SW1 90 deg CW; update KiCad local history
    - SW1 (DIP-6, C6331172) rotation 90 -> 0 to match JLC's part model
    (checked in the JLC viewer)
    - .history (KiCad local-history repo) pointer updated
    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
    [DCDC_JLC_CPL.csv]
2026-10-20 Rev E: isolated flyback aux supply, VREF+ back to 3.3 V, 1 oz re-layout
    - New isolated aux flyback (sheet iso_pwr): UC3843B U20 from +10V_P, FDN86246 Q11,
    PA3855.006NLT EP13 T2, SS110 D9 -> isolated +10 V; secondary regulation TL431 U22 +
    EL357N opto U21 into COMP; RCD clamp D8/R116/C94; 2 A primary limit (R114)
    - Secondary rails from the flyback, not VBUS: +10 V -> U4 10->5 V -> U5 TLV75533 3.3 V;
    MCU, CAN and drivers up before the LLC starts
    - U12 -> CA-IS3742LW (data only); REF3030 U19 removed, VREF+ = +3V3A (3.3 V full scale)
    - PCB re-placed / re-routed for 1 oz outer / 0.5 oz inner: power pours on F.Cu, In1 solid
    ground planes, gate loops as tight HO/HS pairs, 1.7 mm power-via p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
    [BOM_DCDC_LLC_4SBB_G474.csv, BOM_JLCPCB_DCDC_LLC_4SBB_G474.csv, DCDC_JLC_BOM.csv, DCDC_LLC_4SBB_G474.kicad_pcb, DCDC_LLC_4SBB_G474.kicad_sch, can.kicad_sch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]
2026-10-20 BOM sourcing review Rev E: LCSC stock 2026-10-20, shortage risk, 2nd/3rd sources
    - 01_hardware/bom/BOM_sourcing_revE.xlsx: every assembled line (+ U1) with live LCSC stock,
    boards covered, risk, action, and 2nd / 3rd source (MPN, LCSC #, stock)
    - 11 CRITICAL lines before ordering: U1 STM32G474RBT6 out of stock (-> RBT3), NCEP0160AG 38 pcs
    (-> NCEP068N10G), C1525 / C25744 / C52923 / C22939 / C25092 / C190095 out of stock, FB1 and L2/L3
    parts no longer listed, C82 BOM error (X7R part on a C0G ramp cap)
    - 5 HIGH: L1, T2, C1/C11/C60, UCC27211DDAR low stock; RS1 part marked discontinued
    - 04_scripts/sourcing: alternates table, raw stock snapshot, workbook builder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
    [BOM_sourcing_revE.xlsx, lcsc_stock_20261020.tsv]
2026-10-20 Rev E BOM: in-stock LCSC first source for every part; 2nd/3rd sources checked
    - First sources swapped (same footprints, layout unchanged): U1 STM32G474RBT3,
    Q2/Q3/Q5/Q6 NCEP068N10G, 10k 0402 FOJAN, 100n 0402 merged onto C307331,
    1u 0402 CCTC, R62/R63/R89/R82, FB1 Murata BLM18KG601SN1D, L2/L3 cjiang
    FNR5040S470MT, C82 KEMET C0G (was X7R), RS1 Milliohm HoJLR2512, SS110 MDD
    - LCSC part numbers for the hand-soldered headers (J1-J5, J7, JP1)
    - Schematic and PCB fields, BOM, JLC BOM/CPL, PDFs and design notes regenerated;
    netlist check 0 errors, DRC unchanged
    - BOM_sourcing_revE.xlsx: live LCSC stock 2026-10-20, 2nd/3rd sources checked
    for pinout / land pattern / ratings, PCB reserve opt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
    [BOM_DCDC_LLC_4SBB_G474.csv, BOM_JLCPCB_DCDC_LLC_4SBB_G474.csv, BOM_sourcing_revE.xlsx, DCDC_JLC_BOM.csv, DCDC_LLC_4SBB_G474.kicad_pcb, DCDC_LLC_4SBB_G474.kicad_sch, can.kicad_sch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]
2026-10-20 Rev E2: debug-port series resistors, DRC clean (0 errors / 0 warnings)
    - R123-R128 47.5 Ohm 0402 (C82290) in SWDIO, SWCLK, TP_DAC, TP_GPIO1,
    TP_GPIO2, NRST; R129 2 Ohm 0603 (C2933191) +3V3 -> J6.7 / J7 VTref
    (PROG_3V3). Placed on the MCU side of the J6/J7 branch, inserted into
    the existing traces.
    - Cleared the 16 courtyard overlaps (T1/CR*/R64, T2/D8/C94/R116/C95/Q11/
    R114, C98/R122, C69/U11, C34/U1) with small moves, tracks re-attached;
    silk warnings gone. Parity 291 parts / 796 pads, 0 mismatches.
    - BOMs, JLC BOM/CPL, gerbers, PDFs, EasyEDA zip, sourcing workbook,
    design notes, DRC report, README updated; scripts in 04_scripts/pcb6.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
    [BOM_DCDC_LLC_4SBB_G474.csv, BOM_JLCPCB_DCDC_LLC_4SBB_G474.csv, BOM_sourcing_revE.xlsx, DCDC_JLC_BOM.csv, DCDC_LLC_4SBB_G474.kicad_pcb, DCDC_LLC_4SBB_G474.kicad_sch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]
2026-10-20 Rev E2: J3 thermal spokes, via holes out of SMD pads, short-risk review
    - J3 pin 3 (GND_ISO) on In2 was boxed in by the J3->J4 CANH/CANL links
    (1 spoke into a cut-off scrap; KiCad 8+ DRC error). CANL link moved to
    B.Cu: pin now has 2+ spokes into the plane on every layer.
    - Via drill holes kept out of SMD pads: C69.2, C95.2, J7.5 vias moved,
    R64 0.15 mm up off the Q5 gate via. U12.2 GNDP via unchanged (no room).
    - Review: vias tented, min other-net gap 0.20 mm, no pad with <2 thermal
    spokes; DRC 0/0/0 unconnected, parity 796 pads 0 mismatches.
    - Includes the KiCad local history (.history).
    Claude-Session: https://claude.ai/code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
    [DCDC_LLC_4SBB_G474.kicad_pcb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]
